aminewe898/nexus-pear-reva/engineering-tools/README.md

# Engineering tools

Historical generation, routing, correction, audit and packaging scripts are preserved for review. Some reference the original working folders and installed Windows tools. They are not a one-command reproducible build. Running generation scripts can overwrite circuit or routing changes; use the native checked project as the authoritative revision.
