aminewe898/nexus-pear-reva/docs/SOURCES.md

# Receipts, because "trust me bro" is not a datasheet

Research date: 2026-10-07. Official documentation is the basis of the redesign. Indexed supplier prices are explicitly weaker than current cart evidence. No supplier order or RFQ was sent.

| References | Manufacturer | Exact MPN | Official source |
|---|---|---|---|
| U1 | Espressif | ESP32-S3-WROOM-1U-N16R8 | [Source](https://www.espressif.com/sites/default/files/documentation/esp32-s3-wroom-1_wroom-1u_datasheet_en.pdf) |
| R1 R2 R20 R25 R29 R30 R42 R43 R44 R45 | Yageo | RC0805FR-0710KL | [Source](https://www.yageo.com/en/ProductSearch) |
| C1 C17 C21 | Murata | GRM21BR71A105KA01L | [Source](https://www.murata.com/en-global/products/capacitor/mlcc) |
| C2 C10 C11 C14 C15 C19 | Murata | GRM31CR61A226KE19L | [Source](https://www.murata.com/en-global/products/capacitor/mlcc) |
| C3 C6 C9 C16 C18 C20 C22 C23 C24 C25 | Murata | GRM21BR71H104KA01L | [Source](https://www.murata.com/en-global/products/capacitor/mlcc) |
| J1 | GCT | USB4105-GF-A | [Source](https://gct.co/files/drawings/usb4105.pdf) |
| R7 R8 | Yageo | RC0805FR-0722RL | [Source](https://www.yageo.com/en/ProductSearch) |
| U2 | STMicroelectronics | USBLC6-2SC6 | [Source](https://www.st.com/resource/en/datasheet/usblc6-2.pdf) |
| U3 | Nexperia | PESD5V0S2BT,215 | [Source](https://assets.nexperia.com/documents/data-sheet/PESD5V0S2BT.pdf) |
| F1 | Littelfuse | 1812L300/24SLER | [Source](https://www.littelfuse.com/assetdocs/low-rho-datasheet-update?assetguid=b786faf0-de16-4763-9d22-6b8080943caf) |
| U4 | Texas Instruments | TPS25940LRVCR | [Source](https://www.ti.com/lit/ds/symlink/tps25940.pdf) |
| C8 | Murata | GRM31CR61A106KA01L | [Source](https://www.murata.com/en-global/products/capacitor/mlcc) |
| U5 | Diodes Incorporated | AP63203WU-7 | [Source](https://www.diodes.com/assets/Datasheets/AP63200-AP63201-AP63203-AP63205.pdf) |
| L1 | Bourns | SRN6028C-3R9M | [Source](https://www.bourns.com/data/global/pdfs/SRN6028C.pdf) |
| R9 R37 R41 R48 R49 R50 | Yageo | RC0805FR-07100KL | [Source](https://www.yageo.com/en/ProductSearch) |
| J2 | JST | SM15B-GHS-TB(LF)(SN) | [Source](https://www.jst-mfg.com/product/pdf/eng/eGH.pdf) |
| R10 R11 R17 R18 R19 R27 R28 R46 R47 | Yageo | RC0805FR-0733RL | [Source](https://www.yageo.com/en/ProductSearch) |
| R13 R14 R24 | Yageo | RC0805FR-074K7L | [Source](https://www.yageo.com/en/ProductSearch) |
| J3 J4 | Samtec | TSW-007-07-G-S | [Source](https://www.samtec.com/products/tsw) |
| R15 | Yageo | RC0805FR-0782KL | [Source](https://www.yageo.com/en/ProductSearch) |
| R16 | Yageo | RC0805FR-07560KL | [Source](https://www.yageo.com/en/ProductSearch) |
| J5 J6 J7 | Samtec | TSW-006-07-G-S | [Source](https://www.samtec.com/products/tsw) |
| SW1 SW2 SW3 SW4 SW5 SW6 SW7 SW8 | Omron | B3F-1000 | [Source](https://components.omron.com/us-en/products/switches/B3F) |
| R21 | Yageo | RC0805JR-070RL | [Source](https://www.yageo.com/en/ProductSearch) |
| R22 R31 | Yageo | RC0805FR-071KL | [Source](https://www.yageo.com/en/ProductSearch) |
| R23 | Yageo | RC0805FR-072K2L | [Source](https://www.yageo.com/en/ProductSearch) |
| R26 | Yageo | RC0805FR-0722KL | [Source](https://www.yageo.com/en/ProductSearch) |
| J8 | Samtec | TSW-004-07-G-S | [Source](https://www.samtec.com/products/tsw) |
| D1 | Lite-On | LTST-C170KFKT | [Source](https://optoelectronics.liteon.com/en-global/Led/LED-Lamp) |
| U6 | Texas Instruments | TXU0104PWR | [Source](https://www.ti.com/lit/ds/symlink/txu0104.pdf) |
| U7 | Texas Instruments | TUSB320LAIRWBR | [Source](https://www.ti.com/lit/ds/symlink/tusb320lai.pdf) |
| U8 | Texas Instruments | TLV76033DBZR | [Source](https://www.ti.com/lit/ds/symlink/tlv760.pdf) |
| U9 | Texas Instruments | SN74LVC2G02DCTR | [Source](https://www.ti.com/lit/ds/symlink/sn74lvc2g02.pdf) |
| Q1 | Nexperia | 2N7002,215 | [Source](https://assets.nexperia.com/documents/data-sheet/2N7002.pdf) |
| D2 | Littelfuse | SMBJ10A | [Source](https://www.littelfuse.com/products/overvoltage-protection/tvs-diodes/surface-mount/smbj/smbj10a) |
| R32 R33 | Yageo | RC0805FR-0747KL | [Source](https://www.yageo.com/en/ProductSearch) |
| R34 | Yageo | RC0805FR-07887KL | [Source](https://www.yageo.com/en/ProductSearch) |
| R35 | Yageo | RC0805FR-0734K8L | [Source](https://www.yageo.com/en/ProductSearch) |
| R36 | Yageo | RC0805FR-07309KL | [Source](https://www.yageo.com/en/ProductSearch) |
| R38 | Yageo | RT0805BRD07475KL | [Source](https://www.yageo.com/en/ProductSearch) |
| R39 | Yageo | RT0805BRD07100KL | [Source](https://www.yageo.com/en/ProductSearch) |
| R40 | Yageo | RC0805FR-07332KL | [Source](https://www.yageo.com/en/ProductSearch) |
| C26 | Murata | GRM21BR71H473KA01L | [Source](https://www.murata.com/en-global/products/capacitor/mlcc) |

Display: [product](https://www.waveshare.com/product/3.5inch-capacitive-touch-lcd.htm), [wiki](https://www.waveshare.com/wiki/3.5inch_Capacitive_Touch_LCD), [public schematic](https://files.waveshare.com/wiki/3.5inch%20Capacitive%20Touch%20LCD/3.5inch_Capacitive_Touch_LCD_Schematic.pdf), [ST7796S](https://files.waveshare.com/wiki/common/ST7796S_Datasheet.pdf), [FT6336U](https://files.waveshare.com/wiki/common/FT6336U_Datasheet.pdf), [JST GH drawing](https://www.jst-mfg.com/product/pdf/eng/eGH.pdf).

Protection references: [TPS25940](https://www.ti.com/lit/ds/symlink/tps25940.pdf), [TUSB320LAI](https://www.ti.com/lit/ds/symlink/tusb320lai.pdf), [TLV760](https://www.ti.com/lit/ds/symlink/tlv760.pdf), [TXU0104](https://www.ti.com/lit/ds/symlink/txu0104.pdf), [Littelfuse Low Rho drawing/derating](https://www.littelfuse.com/assetdocs/low-rho-datasheet-update?assetguid=b786faf0-de16-4763-9d22-6b8080943caf).

Software: [KiCad 10 CLI](https://docs.kicad.org/10.0/en/cli/cli.html). KiCad 10.0.1 supplied native ERC/DRC and manufacturing exports. Local autorouting was followed by manual buck/USB/power corrections and native checks. Routing provenance is retained as engineering evidence.

BOM: 106 rows, 96 rows without prices. Observed USD subtotal 44.378 across ten rows is not a total procurement quote. Indexed prices, currency, import, VAT, shipping, PCB assembly, enclosure and storage-card cost are not a committed purchase price.
