aminewe898/nexus-pear-reva/previews/board-3d.png

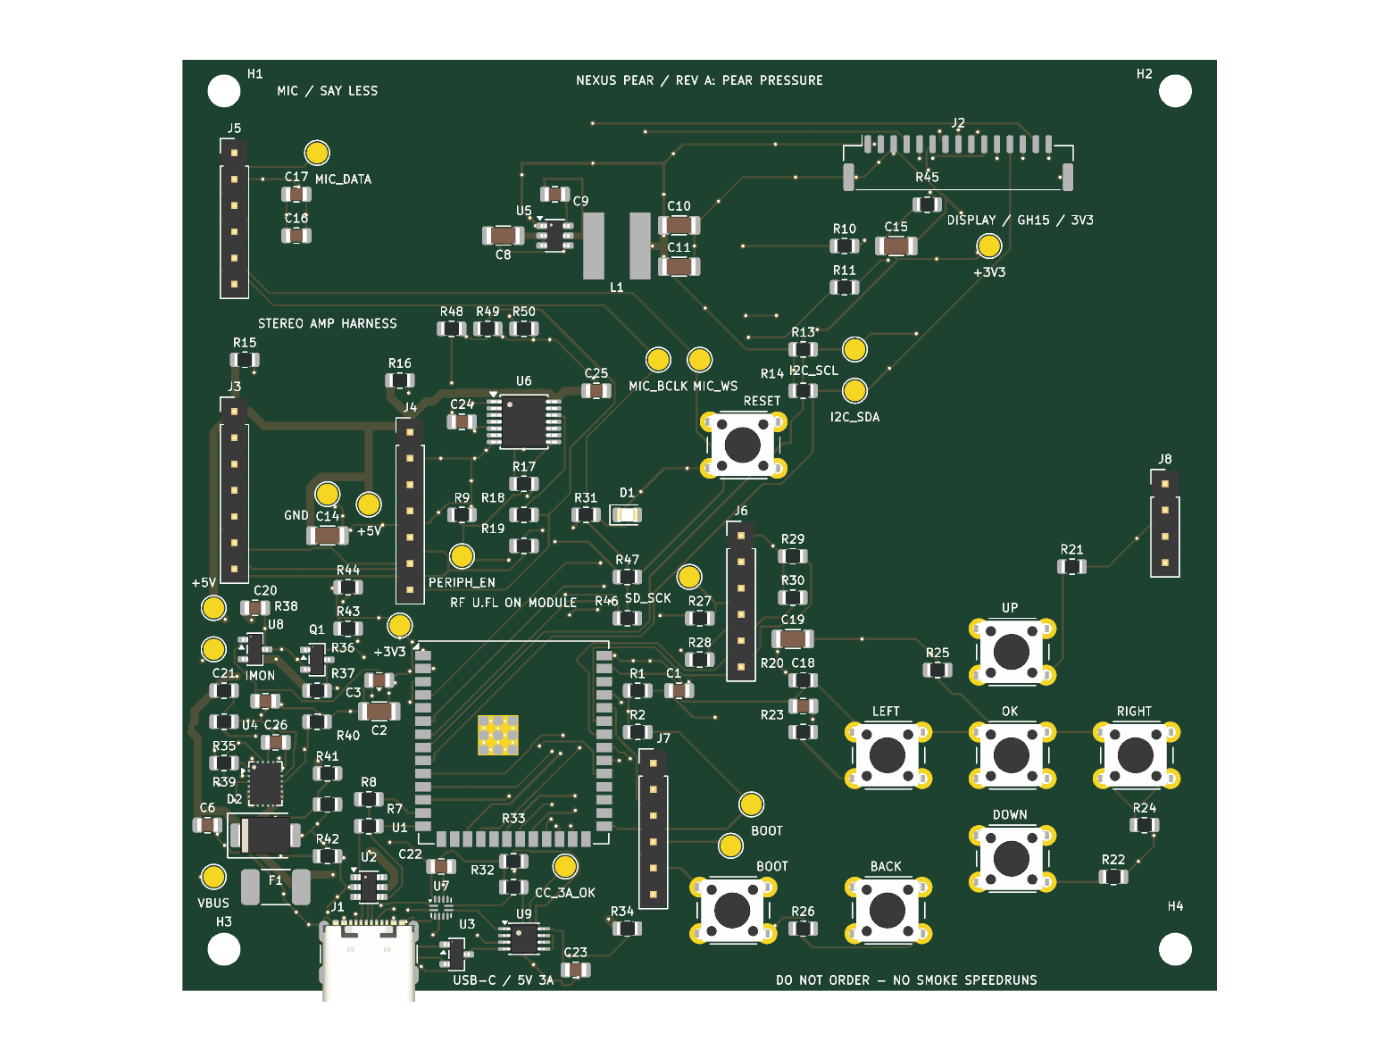
previews/board-3d.png
