aminewe898/nexus-pear-reva/hardware/manufacturing/DO_NOT_ORDER.md

# DO NOT ORDER - review exports only

Exports are regenerated from the reviewed 117-footprint native revision. Circuit defects were corrected; physical power/USB/audio qualification, manufacturer tolerance overlays, biased capacitance, complete live quotes, enclosure fit and fabricator impedance approval remain open. Read ../../docs/DESIGN_REVIEW_REVA.md.

Four layers: F.Cu signals, In1.Cu ground, In2.Cu 3.3V with isolated power/CC routes, B.Cu signals. Proposed 1.6mm board with outer 1oz/inner 0.5oz copper is not an approved impedance stackup. Placement CSV is in mm, KiCad absolute origin with negative Y; PTH/manual parts and rotations need assembly review. STEP omits five component bodies and does not qualify mechanics.

Gerbers.zip contains this revision's Gerbers. nexus-pear-reva.drl is the newly generated combined Excellon drill file; obsolete split drills and maps are removed. No panelization or assembly contract is approved. Any PCB edit requires refill, checks and regenerated exports.
