aminewe898/nexus-pear-reva/hardware/BOM_REVA.csv

Reference | Qty | Value | Description | Manufacturer | MPN | Package | Supplier | Supplier SKU | Unit Cost | Extended Cost | Availability | Datasheet URL | Notes | Currency
U1 | 1 | ESP32-S3-WROOM-1U-N16R8 | Manufacturer pin table checked; GPIO35/36/37 reserved for octal PSRAM. External RF socket. | Espressif | ESP32-S3-WROOM-1U-N16R8 | ESP32-S3-WROOM-1U | RFQ required |  |  |  | Exact live price and stock unconfirmed | https://www.espressif.com/sites/default/files/documentation/esp32-s3-wroom-1_wroom-1u_datasheet_en.pdf | CANDIDATE; DO NOT ORDER. Manufacturer pin table checked; GPIO35/36/37 reserved for octal PSRAM. External RF socket.
R1 | 1 | 10k | 1% 0805 thick-film; exact value and pin mapping explicit | Yageo | RC0805FR-0710KL | R_0805_2012Metric | RFQ required |  |  |  | Exact live price and stock unconfirmed | https://www.yageo.com/en/ProductSearch | CANDIDATE; DO NOT ORDER. 1% 0805 thick-film; exact value and pin mapping explicit
C1 | 1 | 1u | Ceramic; exact DC-bias and sourcing review pending; do not substitute voltage rating blindly | Murata | GRM21BR71A105KA01L | C_0805_2012Metric | RFQ required |  |  |  | Exact live price and stock unconfirmed | https://www.murata.com/en-global/products/capacitor/mlcc | CANDIDATE; DO NOT ORDER. Ceramic; exact DC-bias and sourcing review pending; do not substitute voltage rating blindly
C2 | 1 | 22u | Ceramic; exact DC-bias and sourcing review pending; do not substitute voltage rating blindly | Murata | GRM31CR61A226KE19L | C_1206_3216Metric | RFQ required |  |  |  | Exact live price and stock unconfirmed | https://www.murata.com/en-global/products/capacitor/mlcc | CANDIDATE; DO NOT ORDER. Ceramic; exact DC-bias and sourcing review pending; do not substitute voltage rating blindly
C3 | 1 | 100n | Ceramic; exact DC-bias and sourcing review pending; do not substitute voltage rating blindly | Murata | GRM21BR71H104KA01L | C_0805_2012Metric | RFQ required |  |  |  | Exact live price and stock unconfirmed | https://www.murata.com/en-global/products/capacitor/mlcc | CANDIDATE; DO NOT ORDER. Ceramic; exact DC-bias and sourcing review pending; do not substitute voltage rating blindly
R2 | 1 | 10k | 1% 0805 thick-film; exact value and pin mapping explicit | Yageo | RC0805FR-0710KL | R_0805_2012Metric | RFQ required |  |  |  | Exact live price and stock unconfirmed | https://www.yageo.com/en/ProductSearch | CANDIDATE; DO NOT ORDER. 1% 0805 thick-film; exact value and pin mapping explicit
J1 | 1 | USB-C 5V / USB2 FS | Fixed sink; no PD, no host; shield bonded to ground. Exact footprint requires final dimension audit. | GCT | USB4105-GF-A | USB_C_Receptacle_GCT_USB4105-xx-A_16P_TopMnt_Horizontal | RFQ required |  |  |  | Exact live price and stock unconfirmed | https://gct.co/files/drawings/usb4105.pdf | CANDIDATE; DO NOT ORDER. Fixed sink; no PD, no host; shield bonded to ground. Exact footprint requires final dimension audit.
R7 | 1 | 22 | 1% 0805 thick-film; exact value and pin mapping explicit | Yageo | RC0805FR-0722RL | R_0805_2012Metric | RFQ required |  |  |  | Exact live price and stock unconfirmed | https://www.yageo.com/en/ProductSearch | CANDIDATE; DO NOT ORDER. 1% 0805 thick-film; exact value and pin mapping explicit
R8 | 1 | 22 | 1% 0805 thick-film; exact value and pin mapping explicit | Yageo | RC0805FR-0722RL | R_0805_2012Metric | RFQ required |  |  |  | Exact live price and stock unconfirmed | https://www.yageo.com/en/ProductSearch | CANDIDATE; DO NOT ORDER. 1% 0805 thick-film; exact value and pin mapping explicit
U2 | 1 | USBLC6-2SC6 | USB data ESD; bias from protected main 5V, not raw VBUS | STMicroelectronics | USBLC6-2SC6 | SOT-23-6 | RFQ required |  |  |  | Exact live price and stock unconfirmed | https://www.st.com/resource/en/datasheet/usblc6-2.pdf | CANDIDATE; DO NOT ORDER. USB data ESD; bias from protected main 5V, not raw VBUS
U3 | 1 | PESD5V0S2BT CC ESD | Ground-referenced CC ESD; no rail injection. Not a 20V CC-to-VBUS short protector. | Nexperia | PESD5V0S2BT,215 | SOT-23 | RFQ required |  |  |  | Exact live price and stock unconfirmed | https://assets.nexperia.com/documents/data-sheet/PESD5V0S2BT.pdf | CANDIDATE; DO NOT ORDER. Ground-referenced CC ESD; no rail injection. Not a 20V CC-to-VBUS short protector.
F1 | 1 | 3A / 24V PTC | Manufacturer Low Rho table: 3A hold, 24V, R1max30mOhm; recommended pads 1.78x3.45mm, 3.15mm inner gap. Derates to 2.45A at40C and1.85A at60C. | Littelfuse | 1812L300/24SLER | Fuse_1812_4532Metric | DigiKey | 18-1812L300/24SLERCT-ND | 2.63 | 2.63 | Price/stock captured 2026-10-07 | https://www.littelfuse.com/assetdocs/low-rho-datasheet-update?assetguid=b786faf0-de16-4763-9d22-6b8080943caf | CANDIDATE; DO NOT ORDER. Manufacturer Low Rho table: 3A hold, 24V, R1max30mOhm; recommended pads 1.78x3.45mm, 3.15mm inner gap. Derates to 2.45A at40C and1.85A at60C. | USD
C6 | 1 | 100n | 50V X7R raw input decoupling; upstream capacitance below 1uF | Murata | GRM21BR71H104KA01L | C_0805_2012Metric | RFQ required |  |  |  | Exact live price and stock unconfirmed | https://www.murata.com/en-global/products/capacitor/mlcc | CANDIDATE; DO NOT ORDER. 50V X7R raw input decoupling; upstream capacitance below 1uF
U4 | 1 | TPS25940LRVCR eFuse | Latched eFuse: reverse blocking, UVLO, OVP, ~2.56A limit, controlled rise; only enabled on 3A advertisement | Texas Instruments | TPS25940LRVCR | Texas_RVC0020A_WQFN-20-1EP_3x4mm_P0.5mm_EP1.6x2.6mm | RFQ required |  |  |  | Exact live price and stock unconfirmed | https://www.ti.com/lit/ds/symlink/tps25940.pdf | CANDIDATE; DO NOT ORDER. Latched eFuse: reverse blocking, UVLO, OVP, ~2.56A limit, controlled rise; only enabled on 3A advertisement
C8 | 1 | 10u | Ceramic; exact DC-bias and sourcing review pending; do not substitute voltage rating blindly | Murata | GRM31CR61A106KA01L | C_1206_3216Metric | RFQ required |  |  |  | Exact live price and stock unconfirmed | https://www.murata.com/en-global/products/capacitor/mlcc | CANDIDATE; DO NOT ORDER. Ceramic; exact DC-bias and sourcing review pending; do not substitute voltage rating blindly
U5 | 1 | AP63203WU-7 3V3 buck | 2A fixed 3.3V. Sourcing contradictory; not release-qualified. | Diodes Incorporated | AP63203WU-7 | TSOT-23-6 | RFQ required |  |  |  | Exact live price and stock unconfirmed | https://www.diodes.com/assets/Datasheets/AP63200-AP63201-AP63203-AP63205.pdf | CANDIDATE; DO NOT ORDER. 2A fixed 3.3V. Sourcing contradictory; not release-qualified.
C9 | 1 | 100n | Ceramic; exact DC-bias and sourcing review pending; do not substitute voltage rating blindly | Murata | GRM21BR71H104KA01L | C_0805_2012Metric | RFQ required |  |  |  | Exact live price and stock unconfirmed | https://www.murata.com/en-global/products/capacitor/mlcc | CANDIDATE; DO NOT ORDER. Ceramic; exact DC-bias and sourcing review pending; do not substitute voltage rating blindly
L1 | 1 | 3.9uH | Bourns C-series recommended pads 2.0x6.5mm, center spacing 4.5mm; local native snapshot corrected against manufacturer drawing. | Bourns | SRN6028C-3R9M | L_Bourns-SRN6028 | RFQ required |  |  |  | Exact live price and stock unconfirmed | https://www.bourns.com/data/global/pdfs/SRN6028C.pdf | CANDIDATE; DO NOT ORDER. Bourns C-series recommended pads 2.0x6.5mm, center spacing 4.5mm; local native snapshot corrected against manufacturer drawing.
C10 | 1 | 22u | Ceramic; exact DC-bias and sourcing review pending; do not substitute voltage rating blindly | Murata | GRM31CR61A226KE19L | C_1206_3216Metric | RFQ required |  |  |  | Exact live price and stock unconfirmed | https://www.murata.com/en-global/products/capacitor/mlcc | CANDIDATE; DO NOT ORDER. Ceramic; exact DC-bias and sourcing review pending; do not substitute voltage rating blindly
C11 | 1 | 22u | Ceramic; exact DC-bias and sourcing review pending; do not substitute voltage rating blindly | Murata | GRM31CR61A226KE19L | C_1206_3216Metric | RFQ required |  |  |  | Exact live price and stock unconfirmed | https://www.murata.com/en-global/products/capacitor/mlcc | CANDIDATE; DO NOT ORDER. Ceramic; exact DC-bias and sourcing review pending; do not substitute voltage rating blindly
R9 | 1 | 100k | 1% 0805 thick-film; exact value and pin mapping explicit | Yageo | RC0805FR-07100KL | R_0805_2012Metric | RFQ required |  |  |  | Exact live price and stock unconfirmed | https://www.yageo.com/en/ProductSearch | CANDIDATE; DO NOT ORDER. 1% 0805 thick-film; exact value and pin mapping explicit
C14 | 1 | 22u | Ceramic; exact DC-bias and sourcing review pending; do not substitute voltage rating blindly | Murata | GRM31CR61A226KE19L | C_1206_3216Metric | RFQ required |  |  |  | Exact live price and stock unconfirmed | https://www.murata.com/en-global/products/capacitor/mlcc | CANDIDATE; DO NOT ORDER. Ceramic; exact DC-bias and sourcing review pending; do not substitute voltage rating blindly
C15 | 1 | 22u | Ceramic; exact DC-bias and sourcing review pending; do not substitute voltage rating blindly | Murata | GRM31CR61A226KE19L | C_1206_3216Metric | RFQ required |  |  |  | Exact live price and stock unconfirmed | https://www.murata.com/en-global/products/capacitor/mlcc | CANDIDATE; DO NOT ORDER. Ceramic; exact DC-bias and sourcing review pending; do not substitute voltage rating blindly
J2 | 1 | WAVESHARE 29318 GH15 | GH15 straight-through harness, 3.3V mode; mate GHR-15V-S and SSHL-002T-P0.2. No 5V on either supply pin. | JST | SM15B-GHS-TB(LF)(SN) | JST_GH_SM15B-GHS-TB_1x15-1MP_P1.25mm_Horizontal | Mouser | 306-SM15BGHSTBLFSN | 0.8 | 0.8 | Indexed price; live confirmation pending | https://www.jst-mfg.com/product/pdf/eng/eGH.pdf | CANDIDATE; DO NOT ORDER. GH15 straight-through harness, 3.3V mode; mate GHR-15V-S and SSHL-002T-P0.2. No 5V on either supply pin. | USD
R10 | 1 | 33 | 1% 0805 thick-film; exact value and pin mapping explicit | Yageo | RC0805FR-0733RL | R_0805_2012Metric | RFQ required |  |  |  | Exact live price and stock unconfirmed | https://www.yageo.com/en/ProductSearch | CANDIDATE; DO NOT ORDER. 1% 0805 thick-film; exact value and pin mapping explicit
R11 | 1 | 33 | 1% 0805 thick-film; exact value and pin mapping explicit | Yageo | RC0805FR-0733RL | R_0805_2012Metric | RFQ required |  |  |  | Exact live price and stock unconfirmed | https://www.yageo.com/en/ProductSearch | CANDIDATE; DO NOT ORDER. 1% 0805 thick-film; exact value and pin mapping explicit
R13 | 1 | 4.7k | 1% 0805 thick-film; exact value and pin mapping explicit | Yageo | RC0805FR-074K7L | R_0805_2012Metric | RFQ required |  |  |  | Exact live price and stock unconfirmed | https://www.yageo.com/en/ProductSearch | CANDIDATE; DO NOT ORDER. 1% 0805 thick-film; exact value and pin mapping explicit
R14 | 1 | 4.7k | 1% 0805 thick-film; exact value and pin mapping explicit | Yageo | RC0805FR-074K7L | R_0805_2012Metric | RFQ required |  |  |  | Exact live price and stock unconfirmed | https://www.yageo.com/en/ProductSearch | CANDIDATE; DO NOT ORDER. 1% 0805 thick-film; exact value and pin mapping explicit
J3 | 1 | LEFT AMP HARNESS | Carrier-side pin order only. Cable assembly and manufacturer drawing audit remain release gates. | Samtec | TSW-007-07-G-S | PinHeader_1x07_P2.54mm_Vertical | Samtec | TSW-107-07-G-S | 0.874 | 0.874 | Manufacturer indexed price; live confirmation pending | https://www.samtec.com/products/tsw | CANDIDATE; DO NOT ORDER. Carrier-side pin order only. Cable assembly and manufacturer drawing audit remain release gates. | USD
J4 | 1 | RIGHT AMP HARNESS | Carrier-side pin order only. Cable assembly and manufacturer drawing audit remain release gates. | Samtec | TSW-007-07-G-S | PinHeader_1x07_P2.54mm_Vertical | Samtec | TSW-107-07-G-S | 0.874 | 0.874 | Manufacturer indexed price; live confirmation pending | https://www.samtec.com/products/tsw | CANDIDATE; DO NOT ORDER. Carrier-side pin order only. Cable assembly and manufacturer drawing audit remain release gates. | USD
R15 | 1 | 82k | 1% 0805 thick-film; exact value and pin mapping explicit | Yageo | RC0805FR-0782KL | R_0805_2012Metric | RFQ required |  |  |  | Exact live price and stock unconfirmed | https://www.yageo.com/en/ProductSearch | CANDIDATE; DO NOT ORDER. 1% 0805 thick-film; exact value and pin mapping explicit
R16 | 1 | 560k | 1% 0805 thick-film; exact value and pin mapping explicit | Yageo | RC0805FR-07560KL | R_0805_2012Metric | RFQ required |  |  |  | Exact live price and stock unconfirmed | https://www.yageo.com/en/ProductSearch | CANDIDATE; DO NOT ORDER. 1% 0805 thick-film; exact value and pin mapping explicit
R17 | 1 | 33 | 1% 0805 thick-film; exact value and pin mapping explicit | Yageo | RC0805FR-0733RL | R_0805_2012Metric | RFQ required |  |  |  | Exact live price and stock unconfirmed | https://www.yageo.com/en/ProductSearch | CANDIDATE; DO NOT ORDER. 1% 0805 thick-film; exact value and pin mapping explicit
R18 | 1 | 33 | 1% 0805 thick-film; exact value and pin mapping explicit | Yageo | RC0805FR-0733RL | R_0805_2012Metric | RFQ required |  |  |  | Exact live price and stock unconfirmed | https://www.yageo.com/en/ProductSearch | CANDIDATE; DO NOT ORDER. 1% 0805 thick-film; exact value and pin mapping explicit
R19 | 1 | 33 | 1% 0805 thick-film; exact value and pin mapping explicit | Yageo | RC0805FR-0733RL | R_0805_2012Metric | RFQ required |  |  |  | Exact live price and stock unconfirmed | https://www.yageo.com/en/ProductSearch | CANDIDATE; DO NOT ORDER. 1% 0805 thick-film; exact value and pin mapping explicit
J5 | 1 | MIC HARNESS | Carrier-side pin order only. Cable assembly and manufacturer drawing audit remain release gates. | Samtec | TSW-006-07-G-S | PinHeader_1x06_P2.54mm_Vertical | RFQ required |  |  |  | Exact live price and stock unconfirmed | https://www.samtec.com/products/tsw | CANDIDATE; DO NOT ORDER. Carrier-side pin order only. Cable assembly and manufacturer drawing audit remain release gates.
C16 | 1 | 100n | Ceramic; exact DC-bias and sourcing review pending; do not substitute voltage rating blindly | Murata | GRM21BR71H104KA01L | C_0805_2012Metric | RFQ required |  |  |  | Exact live price and stock unconfirmed | https://www.murata.com/en-global/products/capacitor/mlcc | CANDIDATE; DO NOT ORDER. Ceramic; exact DC-bias and sourcing review pending; do not substitute voltage rating blindly
C17 | 1 | 1u | Ceramic; exact DC-bias and sourcing review pending; do not substitute voltage rating blindly | Murata | GRM21BR71A105KA01L | C_0805_2012Metric | RFQ required |  |  |  | Exact live price and stock unconfirmed | https://www.murata.com/en-global/products/capacitor/mlcc | CANDIDATE; DO NOT ORDER. Ceramic; exact DC-bias and sourcing review pending; do not substitute voltage rating blindly
R20 | 1 | 10k | 1% 0805 thick-film; exact value and pin mapping explicit | Yageo | RC0805FR-0710KL | R_0805_2012Metric | RFQ required |  |  |  | Exact live price and stock unconfirmed | https://www.yageo.com/en/ProductSearch | CANDIDATE; DO NOT ORDER. 1% 0805 thick-film; exact value and pin mapping explicit
C18 | 1 | 100n | Ceramic; exact DC-bias and sourcing review pending; do not substitute voltage rating blindly | Murata | GRM21BR71H104KA01L | C_0805_2012Metric | RFQ required |  |  |  | Exact live price and stock unconfirmed | https://www.murata.com/en-global/products/capacitor/mlcc | CANDIDATE; DO NOT ORDER. Ceramic; exact DC-bias and sourcing review pending; do not substitute voltage rating blindly
SW1 | 1 | UP | 6mm through-hole tact; verify actuator height and native pad fit | Omron | B3F-1000 | SW_PUSH_6mm | RFQ required |  |  |  | Exact live price and stock unconfirmed | https://components.omron.com/us-en/products/switches/B3F | CANDIDATE; DO NOT ORDER. 6mm through-hole tact; verify actuator height and native pad fit
R21 | 1 | 0 | Zero-ohm jumper; resistor tolerance code J, not F | Yageo | RC0805JR-070RL | R_0805_2012Metric | RFQ required |  |  |  | Exact live price and stock unconfirmed | https://www.yageo.com/en/ProductSearch | CANDIDATE; DO NOT ORDER. Zero-ohm jumper; resistor tolerance code J, not F
SW2 | 1 | DOWN | 6mm through-hole tact; verify actuator height and native pad fit | Omron | B3F-1000 | SW_PUSH_6mm | RFQ required |  |  |  | Exact live price and stock unconfirmed | https://components.omron.com/us-en/products/switches/B3F | CANDIDATE; DO NOT ORDER. 6mm through-hole tact; verify actuator height and native pad fit
R22 | 1 | 1k | 1% 0805 thick-film; exact value and pin mapping explicit | Yageo | RC0805FR-071KL | R_0805_2012Metric | RFQ required |  |  |  | Exact live price and stock unconfirmed | https://www.yageo.com/en/ProductSearch | CANDIDATE; DO NOT ORDER. 1% 0805 thick-film; exact value and pin mapping explicit
SW3 | 1 | LEFT | 6mm through-hole tact; verify actuator height and native pad fit | Omron | B3F-1000 | SW_PUSH_6mm | RFQ required |  |  |  | Exact live price and stock unconfirmed | https://components.omron.com/us-en/products/switches/B3F | CANDIDATE; DO NOT ORDER. 6mm through-hole tact; verify actuator height and native pad fit
R23 | 1 | 2.2k | 1% 0805 thick-film; exact value and pin mapping explicit | Yageo | RC0805FR-072K2L | R_0805_2012Metric | RFQ required |  |  |  | Exact live price and stock unconfirmed | https://www.yageo.com/en/ProductSearch | CANDIDATE; DO NOT ORDER. 1% 0805 thick-film; exact value and pin mapping explicit
SW4 | 1 | RIGHT | 6mm through-hole tact; verify actuator height and native pad fit | Omron | B3F-1000 | SW_PUSH_6mm | RFQ required |  |  |  | Exact live price and stock unconfirmed | https://components.omron.com/us-en/products/switches/B3F | CANDIDATE; DO NOT ORDER. 6mm through-hole tact; verify actuator height and native pad fit
R24 | 1 | 4.7k | 1% 0805 thick-film; exact value and pin mapping explicit | Yageo | RC0805FR-074K7L | R_0805_2012Metric | RFQ required |  |  |  | Exact live price and stock unconfirmed | https://www.yageo.com/en/ProductSearch | CANDIDATE; DO NOT ORDER. 1% 0805 thick-film; exact value and pin mapping explicit
SW5 | 1 | OK | 6mm through-hole tact; verify actuator height and native pad fit | Omron | B3F-1000 | SW_PUSH_6mm | RFQ required |  |  |  | Exact live price and stock unconfirmed | https://components.omron.com/us-en/products/switches/B3F | CANDIDATE; DO NOT ORDER. 6mm through-hole tact; verify actuator height and native pad fit
R25 | 1 | 10k | 1% 0805 thick-film; exact value and pin mapping explicit | Yageo | RC0805FR-0710KL | R_0805_2012Metric | RFQ required |  |  |  | Exact live price and stock unconfirmed | https://www.yageo.com/en/ProductSearch | CANDIDATE; DO NOT ORDER. 1% 0805 thick-film; exact value and pin mapping explicit
SW6 | 1 | BACK | 6mm through-hole tact; verify actuator height and native pad fit | Omron | B3F-1000 | SW_PUSH_6mm | RFQ required |  |  |  | Exact live price and stock unconfirmed | https://components.omron.com/us-en/products/switches/B3F | CANDIDATE; DO NOT ORDER. 6mm through-hole tact; verify actuator height and native pad fit
R26 | 1 | 22k | 1% 0805 thick-film; exact value and pin mapping explicit | Yageo | RC0805FR-0722KL | R_0805_2012Metric | RFQ required |  |  |  | Exact live price and stock unconfirmed | https://www.yageo.com/en/ProductSearch | CANDIDATE; DO NOT ORDER. 1% 0805 thick-film; exact value and pin mapping explicit
J6 | 1 | 3V3 SD HARNESS | Carrier-side pin order only. Cable assembly and manufacturer drawing audit remain release gates. | Samtec | TSW-006-07-G-S | PinHeader_1x06_P2.54mm_Vertical | RFQ required |  |  |  | Exact live price and stock unconfirmed | https://www.samtec.com/products/tsw | CANDIDATE; DO NOT ORDER. Carrier-side pin order only. Cable assembly and manufacturer drawing audit remain release gates.
R27 | 1 | 33 | 1% 0805 thick-film; exact value and pin mapping explicit | Yageo | RC0805FR-0733RL | R_0805_2012Metric | RFQ required |  |  |  | Exact live price and stock unconfirmed | https://www.yageo.com/en/ProductSearch | CANDIDATE; DO NOT ORDER. 1% 0805 thick-film; exact value and pin mapping explicit
R28 | 1 | 33 | 1% 0805 thick-film; exact value and pin mapping explicit | Yageo | RC0805FR-0733RL | R_0805_2012Metric | RFQ required |  |  |  | Exact live price and stock unconfirmed | https://www.yageo.com/en/ProductSearch | CANDIDATE; DO NOT ORDER. 1% 0805 thick-film; exact value and pin mapping explicit
R29 | 1 | 10k | 1% 0805 thick-film; exact value and pin mapping explicit | Yageo | RC0805FR-0710KL | R_0805_2012Metric | RFQ required |  |  |  | Exact live price and stock unconfirmed | https://www.yageo.com/en/ProductSearch | CANDIDATE; DO NOT ORDER. 1% 0805 thick-film; exact value and pin mapping explicit
R30 | 1 | 10k | 1% 0805 thick-film; exact value and pin mapping explicit | Yageo | RC0805FR-0710KL | R_0805_2012Metric | RFQ required |  |  |  | Exact live price and stock unconfirmed | https://www.yageo.com/en/ProductSearch | CANDIDATE; DO NOT ORDER. 1% 0805 thick-film; exact value and pin mapping explicit
C19 | 1 | 22u | Ceramic; exact DC-bias and sourcing review pending; do not substitute voltage rating blindly | Murata | GRM31CR61A226KE19L | C_1206_3216Metric | RFQ required |  |  |  | Exact live price and stock unconfirmed | https://www.murata.com/en-global/products/capacitor/mlcc | CANDIDATE; DO NOT ORDER. Ceramic; exact DC-bias and sourcing review pending; do not substitute voltage rating blindly
J7 | 1 | UART RECOVERY | Carrier-side pin order only. Cable assembly and manufacturer drawing audit remain release gates. | Samtec | TSW-006-07-G-S | PinHeader_1x06_P2.54mm_Vertical | RFQ required |  |  |  | Exact live price and stock unconfirmed | https://www.samtec.com/products/tsw | CANDIDATE; DO NOT ORDER. Carrier-side pin order only. Cable assembly and manufacturer drawing audit remain release gates.
J8 | 1 | I2C EXPANSION | Carrier-side pin order only. Cable assembly and manufacturer drawing audit remain release gates. | Samtec | TSW-004-07-G-S | PinHeader_1x04_P2.54mm_Vertical | RFQ required |  |  |  | Exact live price and stock unconfirmed | https://www.samtec.com/products/tsw | CANDIDATE; DO NOT ORDER. Carrier-side pin order only. Cable assembly and manufacturer drawing audit remain release gates.
SW7 | 1 | BOOT |  | Omron | B3F-1000 | SW_PUSH_6mm | RFQ required |  |  |  | Exact live price and stock unconfirmed | https://components.omron.com/us-en/products/switches/B3F | CANDIDATE; DO NOT ORDER.
SW8 | 1 | RESET |  | Omron | B3F-1000 | SW_PUSH_6mm | RFQ required |  |  |  | Exact live price and stock unconfirmed | https://components.omron.com/us-en/products/switches/B3F | CANDIDATE; DO NOT ORDER.
R31 | 1 | 1k | 1% 0805 thick-film; exact value and pin mapping explicit | Yageo | RC0805FR-071KL | R_0805_2012Metric | RFQ required |  |  |  | Exact live price and stock unconfirmed | https://www.yageo.com/en/ProductSearch | CANDIDATE; DO NOT ORDER. 1% 0805 thick-film; exact value and pin mapping explicit
D1 | 1 | STATUS amber | Sourcing and polarity audit pending | Lite-On | LTST-C170KFKT | LED_0805_2012Metric | RFQ required |  |  |  | Exact live price and stock unconfirmed | https://optoelectronics.liteon.com/en-global/Led/LED-Lamp | CANDIDATE; DO NOT ORDER. Sourcing and polarity audit pending
U6 | 1 | TXU0104PWR fail-safe I2S | Automatic supply isolation and Ioff; default disabled by R9. Same-rail display/mic/SD eliminate independent power-off injection. | Texas Instruments | TXU0104PWR | TSSOP-14_4.4x5mm_P0.65mm | Mouser | 595-TXU0104PWR | 1.03 | 1.03 | Indexed price; live confirmation pending | https://www.ti.com/lit/ds/symlink/txu0104.pdf | CANDIDATE; DO NOT ORDER. Automatic supply isolation and Ioff; default disabled by R9. Same-rail display/mic/SD eliminate independent power-off injection. | USD
U7 | 1 | TUSB320LAIRWBR Type-C sink | GPIO mode ADDR floating; sink PORT grounded; internal Rd. OUT1/2 low only for 3A advertisement. | Texas Instruments | TUSB320LAIRWBR | Texas_X2QFN-12_1.6x1.6mm_P0.4mm | RFQ required |  |  |  | Exact live price and stock unconfirmed | https://www.ti.com/lit/ds/symlink/tusb320lai.pdf | CANDIDATE; DO NOT ORDER. GPIO mode ADDR floating; sink PORT grounded; internal Rd. OUT1/2 low only for 3A advertisement.
U8 | 1 | TLV76033DBZR always-on | 30V input rating; pin order follows corrected Rev A datasheet. Powers only CC detector and logic. | Texas Instruments | TLV76033DBZR | SOT-23 | Mouser | 595-TLV76033DBZR | 0.23 | 0.23 | Indexed price; live confirmation pending | https://www.ti.com/lit/ds/symlink/tlv760.pdf | CANDIDATE; DO NOT ORDER. 30V input rating; pin order follows corrected Rev A datasheet. Powers only CC detector and logic. | USD
U9 | 1 | SN74LVC2G02DCTR dual NOR | 3A truth table hardware interlock; no MCU sampling thresholds | Texas Instruments | SN74LVC2G02DCTR | SSOP-8_2.95x2.8mm_P0.65mm | RFQ required |  |  |  | Exact live price and stock unconfirmed | https://www.ti.com/lit/ds/symlink/sn74lvc2g02.pdf | CANDIDATE; DO NOT ORDER. 3A truth table hardware interlock; no MCU sampling thresholds
Q1 | 1 | 2N7002 eFuse inhibit | Pulls eFuse enable below UVLO when unattached/default/1.5A | Nexperia | 2N7002,215 | SOT-23 | RFQ required |  |  |  | Exact live price and stock unconfirmed | https://assets.nexperia.com/documents/data-sheet/2N7002.pdf | CANDIDATE; DO NOT ORDER. Pulls eFuse enable below UVLO when unattached/default/1.5A
D2 | 1 | SMBJ10A VBUS TVS | 17V rated pulse clamp below eFuse 20V absolute maximum; transient energy qualification pending | Littelfuse | SMBJ10A | D_SMB | RFQ required |  |  |  | Exact live price and stock unconfirmed | https://www.littelfuse.com/products/overvoltage-protection/tvs-diodes/surface-mount/smbj/smbj10a | CANDIDATE; DO NOT ORDER. 17V rated pulse clamp below eFuse 20V absolute maximum; transient energy qualification pending
R32 | 1 | 47k | 1% 0805 thick-film; exact value and pin mapping explicit | Yageo | RC0805FR-0747KL | R_0805_2012Metric | RFQ required |  |  |  | Exact live price and stock unconfirmed | https://www.yageo.com/en/ProductSearch | CANDIDATE; DO NOT ORDER. 1% 0805 thick-film; exact value and pin mapping explicit
R33 | 1 | 47k | 1% 0805 thick-film; exact value and pin mapping explicit | Yageo | RC0805FR-0747KL | R_0805_2012Metric | RFQ required |  |  |  | Exact live price and stock unconfirmed | https://www.yageo.com/en/ProductSearch | CANDIDATE; DO NOT ORDER. 1% 0805 thick-film; exact value and pin mapping explicit
R34 | 1 | 887k | 1% 0805 thick-film; exact value and pin mapping explicit | Yageo | RC0805FR-07887KL | R_0805_2012Metric | RFQ required |  |  |  | Exact live price and stock unconfirmed | https://www.yageo.com/en/ProductSearch | CANDIDATE; DO NOT ORDER. 1% 0805 thick-film; exact value and pin mapping explicit
R35 | 1 | 34.8k | 1% 0805 thick-film; exact value and pin mapping explicit | Yageo | RC0805FR-0734K8L | R_0805_2012Metric | Mouser | 603-RC0805FR-0734K8L | 0.1 | 0.1 | Indexed price; live confirmation pending | https://www.yageo.com/en/ProductSearch | CANDIDATE; DO NOT ORDER. 1% 0805 thick-film; exact value and pin mapping explicit | USD
R36 | 1 | 309k | 1% 0805 thick-film; exact value and pin mapping explicit | Yageo | RC0805FR-07309KL | R_0805_2012Metric | RFQ required |  |  |  | Exact live price and stock unconfirmed | https://www.yageo.com/en/ProductSearch | CANDIDATE; DO NOT ORDER. 1% 0805 thick-film; exact value and pin mapping explicit
R37 | 1 | 100k | 1% 0805 thick-film; exact value and pin mapping explicit | Yageo | RC0805FR-07100KL | R_0805_2012Metric | RFQ required |  |  |  | Exact live price and stock unconfirmed | https://www.yageo.com/en/ProductSearch | CANDIDATE; DO NOT ORDER. 1% 0805 thick-film; exact value and pin mapping explicit
R38 | 1 | 475k | 0.1% OVP threshold divider | Yageo | RT0805BRD07475KL | R_0805_2012Metric | RFQ required |  |  |  | Exact live price and stock unconfirmed | https://www.yageo.com/en/ProductSearch | CANDIDATE; DO NOT ORDER. 0.1% OVP threshold divider
R39 | 1 | 100k | 0.1% OVP threshold divider | Yageo | RT0805BRD07100KL | R_0805_2012Metric | RFQ required |  |  |  | Exact live price and stock unconfirmed | https://www.yageo.com/en/ProductSearch | CANDIDATE; DO NOT ORDER. 0.1% OVP threshold divider
R40 | 1 | 332k | 1% 0805 thick-film; exact value and pin mapping explicit | Yageo | RC0805FR-07332KL | R_0805_2012Metric | RFQ required |  |  |  | Exact live price and stock unconfirmed | https://www.yageo.com/en/ProductSearch | CANDIDATE; DO NOT ORDER. 1% 0805 thick-film; exact value and pin mapping explicit
R41 | 1 | 100k | 1% 0805 thick-film; exact value and pin mapping explicit | Yageo | RC0805FR-07100KL | R_0805_2012Metric | RFQ required |  |  |  | Exact live price and stock unconfirmed | https://www.yageo.com/en/ProductSearch | CANDIDATE; DO NOT ORDER. 1% 0805 thick-film; exact value and pin mapping explicit
R42 | 1 | 10k | 1% 0805 thick-film; exact value and pin mapping explicit | Yageo | RC0805FR-0710KL | R_0805_2012Metric | RFQ required |  |  |  | Exact live price and stock unconfirmed | https://www.yageo.com/en/ProductSearch | CANDIDATE; DO NOT ORDER. 1% 0805 thick-film; exact value and pin mapping explicit
R43 | 1 | 10k | 1% 0805 thick-film; exact value and pin mapping explicit | Yageo | RC0805FR-0710KL | R_0805_2012Metric | RFQ required |  |  |  | Exact live price and stock unconfirmed | https://www.yageo.com/en/ProductSearch | CANDIDATE; DO NOT ORDER. 1% 0805 thick-film; exact value and pin mapping explicit
R44 | 1 | 10k | 1% 0805 thick-film; exact value and pin mapping explicit | Yageo | RC0805FR-0710KL | R_0805_2012Metric | RFQ required |  |  |  | Exact live price and stock unconfirmed | https://www.yageo.com/en/ProductSearch | CANDIDATE; DO NOT ORDER. 1% 0805 thick-film; exact value and pin mapping explicit
R45 | 1 | 10k | 1% 0805 thick-film; exact value and pin mapping explicit | Yageo | RC0805FR-0710KL | R_0805_2012Metric | RFQ required |  |  |  | Exact live price and stock unconfirmed | https://www.yageo.com/en/ProductSearch | CANDIDATE; DO NOT ORDER. 1% 0805 thick-film; exact value and pin mapping explicit
R46 | 1 | 33 | 1% 0805 thick-film; exact value and pin mapping explicit | Yageo | RC0805FR-0733RL | R_0805_2012Metric | RFQ required |  |  |  | Exact live price and stock unconfirmed | https://www.yageo.com/en/ProductSearch | CANDIDATE; DO NOT ORDER. 1% 0805 thick-film; exact value and pin mapping explicit
R47 | 1 | 33 | 1% 0805 thick-film; exact value and pin mapping explicit | Yageo | RC0805FR-0733RL | R_0805_2012Metric | RFQ required |  |  |  | Exact live price and stock unconfirmed | https://www.yageo.com/en/ProductSearch | CANDIDATE; DO NOT ORDER. 1% 0805 thick-film; exact value and pin mapping explicit
R48 | 1 | 100k | 1% 0805 thick-film; exact value and pin mapping explicit | Yageo | RC0805FR-07100KL | R_0805_2012Metric | RFQ required |  |  |  | Exact live price and stock unconfirmed | https://www.yageo.com/en/ProductSearch | CANDIDATE; DO NOT ORDER. 1% 0805 thick-film; exact value and pin mapping explicit
R49 | 1 | 100k | 1% 0805 thick-film; exact value and pin mapping explicit | Yageo | RC0805FR-07100KL | R_0805_2012Metric | RFQ required |  |  |  | Exact live price and stock unconfirmed | https://www.yageo.com/en/ProductSearch | CANDIDATE; DO NOT ORDER. 1% 0805 thick-film; exact value and pin mapping explicit
R50 | 1 | 100k | 1% 0805 thick-film; exact value and pin mapping explicit | Yageo | RC0805FR-07100KL | R_0805_2012Metric | RFQ required |  |  |  | Exact live price and stock unconfirmed | https://www.yageo.com/en/ProductSearch | CANDIDATE; DO NOT ORDER. 1% 0805 thick-film; exact value and pin mapping explicit
C20 | 1 | 100n | Ceramic; exact DC-bias and sourcing review pending; do not substitute voltage rating blindly | Murata | GRM21BR71H104KA01L | C_0805_2012Metric | RFQ required |  |  |  | Exact live price and stock unconfirmed | https://www.murata.com/en-global/products/capacitor/mlcc | CANDIDATE; DO NOT ORDER. Ceramic; exact DC-bias and sourcing review pending; do not substitute voltage rating blindly
C21 | 1 | 1u | Ceramic; exact DC-bias and sourcing review pending; do not substitute voltage rating blindly | Murata | GRM21BR71A105KA01L | C_0805_2012Metric | RFQ required |  |  |  | Exact live price and stock unconfirmed | https://www.murata.com/en-global/products/capacitor/mlcc | CANDIDATE; DO NOT ORDER. Ceramic; exact DC-bias and sourcing review pending; do not substitute voltage rating blindly
C22 | 1 | 100n | Ceramic; exact DC-bias and sourcing review pending; do not substitute voltage rating blindly | Murata | GRM21BR71H104KA01L | C_0805_2012Metric | RFQ required |  |  |  | Exact live price and stock unconfirmed | https://www.murata.com/en-global/products/capacitor/mlcc | CANDIDATE; DO NOT ORDER. Ceramic; exact DC-bias and sourcing review pending; do not substitute voltage rating blindly
C23 | 1 | 100n | Ceramic; exact DC-bias and sourcing review pending; do not substitute voltage rating blindly | Murata | GRM21BR71H104KA01L | C_0805_2012Metric | RFQ required |  |  |  | Exact live price and stock unconfirmed | https://www.murata.com/en-global/products/capacitor/mlcc | CANDIDATE; DO NOT ORDER. Ceramic; exact DC-bias and sourcing review pending; do not substitute voltage rating blindly
C24 | 1 | 100n | Ceramic; exact DC-bias and sourcing review pending; do not substitute voltage rating blindly | Murata | GRM21BR71H104KA01L | C_0805_2012Metric | RFQ required |  |  |  | Exact live price and stock unconfirmed | https://www.murata.com/en-global/products/capacitor/mlcc | CANDIDATE; DO NOT ORDER. Ceramic; exact DC-bias and sourcing review pending; do not substitute voltage rating blindly
C25 | 1 | 100n | Ceramic; exact DC-bias and sourcing review pending; do not substitute voltage rating blindly | Murata | GRM21BR71H104KA01L | C_0805_2012Metric | RFQ required |  |  |  | Exact live price and stock unconfirmed | https://www.murata.com/en-global/products/capacitor/mlcc | CANDIDATE; DO NOT ORDER. Ceramic; exact DC-bias and sourcing review pending; do not substitute voltage rating blindly
C26 | 1 | 47n | 50V X7R; nominal ~19.5ms eFuse ramp | Murata | GRM21BR71H473KA01L | C_0805_2012Metric | RFQ required |  |  |  | Exact live price and stock unconfirmed | https://www.murata.com/en-global/products/capacitor/mlcc | CANDIDATE; DO NOT ORDER. 50V X7R; nominal ~19.5ms eFuse ramp
EXT_DISPLAY | 1 | 3.5 inch IPS / capacitive | ST7796S + FT6336U; native 320x480; landscape 480x320 | Waveshare | 29318 | Off-board module | Waveshare | 29318 | 18.99 | 18.99 | Official product price captured 2026-10-07 | https://www.waveshare.com/product/3.5inch-capacitive-touch-lcd.htm | 3.3V mode; GHR-15V-S housing and SSHL-002T-P0.2 contacts; 12MHz write limit | USD
EXT_AMP_L EXT_AMP_R | 2 | MAX98357A breakout | Two mono I2S DAC/class-D channels | Adafruit | 3006 | Off-board breakout | Adafruit | 3006 | 5.95 | 11.9 | Add to Cart shown 2026-10-07 | https://www.adafruit.com/product/3006 | Harness to J3/J4; speaker terminals are on amplifier breakouts | USD
EXT_MIC | 1 | SPH0645LM4H breakout | Digital I2S MEMS microphone | Adafruit | 3421 | Off-board breakout | Adafruit | 3421 | 6.95 | 6.95 | Add to Cart shown 2026-10-07 | https://www.adafruit.com/product/3421 | J5 harness; bottom acoustic port; exact microphone datasheet audit incomplete | USD
EXT_SD | 1 | 3V microSD SPI breakout | Optional storage module | Adafruit | 4682 | Off-board breakout | Adafruit | 4682 |  |  | Product page found; stock/price not captured | https://www.adafruit.com/product/4682 | J6 harness to 3V/GND/CLK/CMD/DAT0/DAT3; no 5V level shifter
EXT_SPK_L EXT_SPK_R | 2 | 8 ohm / 2W | 28 x 40 mm miniature full-range loudspeakers | Visaton | 2945 | Off-board driver | Mouser / TME | VS-K28.40-8 |  |  | Mouser indexed listing 898; TME indexed listing 200; live confirmation pending | https://www.visaton.de/en/products/drivers/miniature-speakers/k-2840-8-ohm | Rated 2W, maximum 3W; bridge outputs must never connect to GND
EXT_ANT | 1 | 2.4GHz external antenna | Real hinged RP-SMA antenna, 50 ohm | Taoglas | GW.11.A153 | Off-board antenna | Mouser | 960-GW11A153 |  |  | Indexed Mouser listing 1963; price/live stock unconfirmed | https://www.taoglas.com/datasheets/GW.11.A153.pdf | Use current rev H gain, up to 3dBi; module antenna certification limits not yet qualified
EXT_RF_CABLE | 1 | 100mm U.FL to RP-SMA(F) | Bulkhead coax assembly | Taoglas | CAB.774 | Off-board cable | Not qualified |  |  |  | Datasheet found; supplier stock/price unverified | https://www.taoglas.com/datasheets/CAB.774.pdf | Confirm gender and length against mechanical drawing; not CAB.011 ambiguous revision
EXT_DISPLAY_HOUSING | 1 | 15 pin GH housing | Display cable carrier mate | JST | GHR-15V-S | Cable housing | RFQ required |  |  |  | No quote | https://www.jst-mfg.com/product/pdf/eng/eGH.pdf | Use only manufacturer-compatible contacts
EXT_DISPLAY_CONTACTS | 15 | GH crimp contacts | 26-30AWG contacts | JST | SSHL-002T-P0.2 | Crimp terminal | RFQ required |  |  |  | No quote | https://www.jst-mfg.com/product/pdf/eng/eGH.pdf | 0.76-1.0mm insulation; correct tooling required
EXT_HARNESS | 1 | Display/audio/mic/SD harness set | Custom point-to-point assemblies | Custom assembly | NEXUS-PEAR-HARNESS-A-CANDIDATE | Wiring | RFQ required |  |  |  | No quote | ../docs/PIN_ASSIGNMENTS.md | Pin mappings released as design intent; custom assembly, wire lengths and supplier assembly drawing require quote and approval
