aminewe898/nexus-pear-reva/hardware/manufacturing/nexus-pear-reva.step

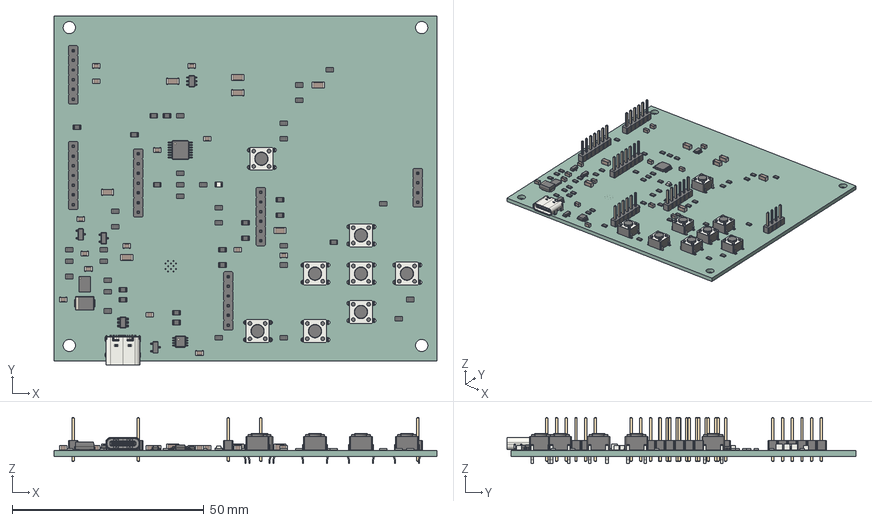
[picture p2: CAD file, 2026-10-09]
hardware/manufacturing/nexus-pear-reva.step
100.0 x 91.1 x 12.0 mm
C_0805_2012Metric x 14
C_1206_3216Metric x 7
R_0805_2012Metric x 45
TSOT-23-6
PinHeader_1x06_P2.54mm_Vertical x 3
LED_0805_2012Metric
PinHeader_1x07_P2.54mm_Vertical x 2
SOT-23 x 3
SOT-23-6
D_SMB
SW_PUSH_6mm x 8
TSSOP-14_4.4x5mm_P0.65mm
SSOP-8_2.95x2.8mm_P0.65mm
USB_C_Receptacle_GCT_USB4105-xx-A_16P_TopMnt_Horizontal
PinHeader_1x04_P2.54mm_Vertical
Texas_RVC0020A_WQFN-20-1EP_3x4mm_P0.5mm_EP1.6x2.6mm
nexus-pear-reva_PCB
