aminewe898/nexus-pear-reva/previews/schematic.pdf

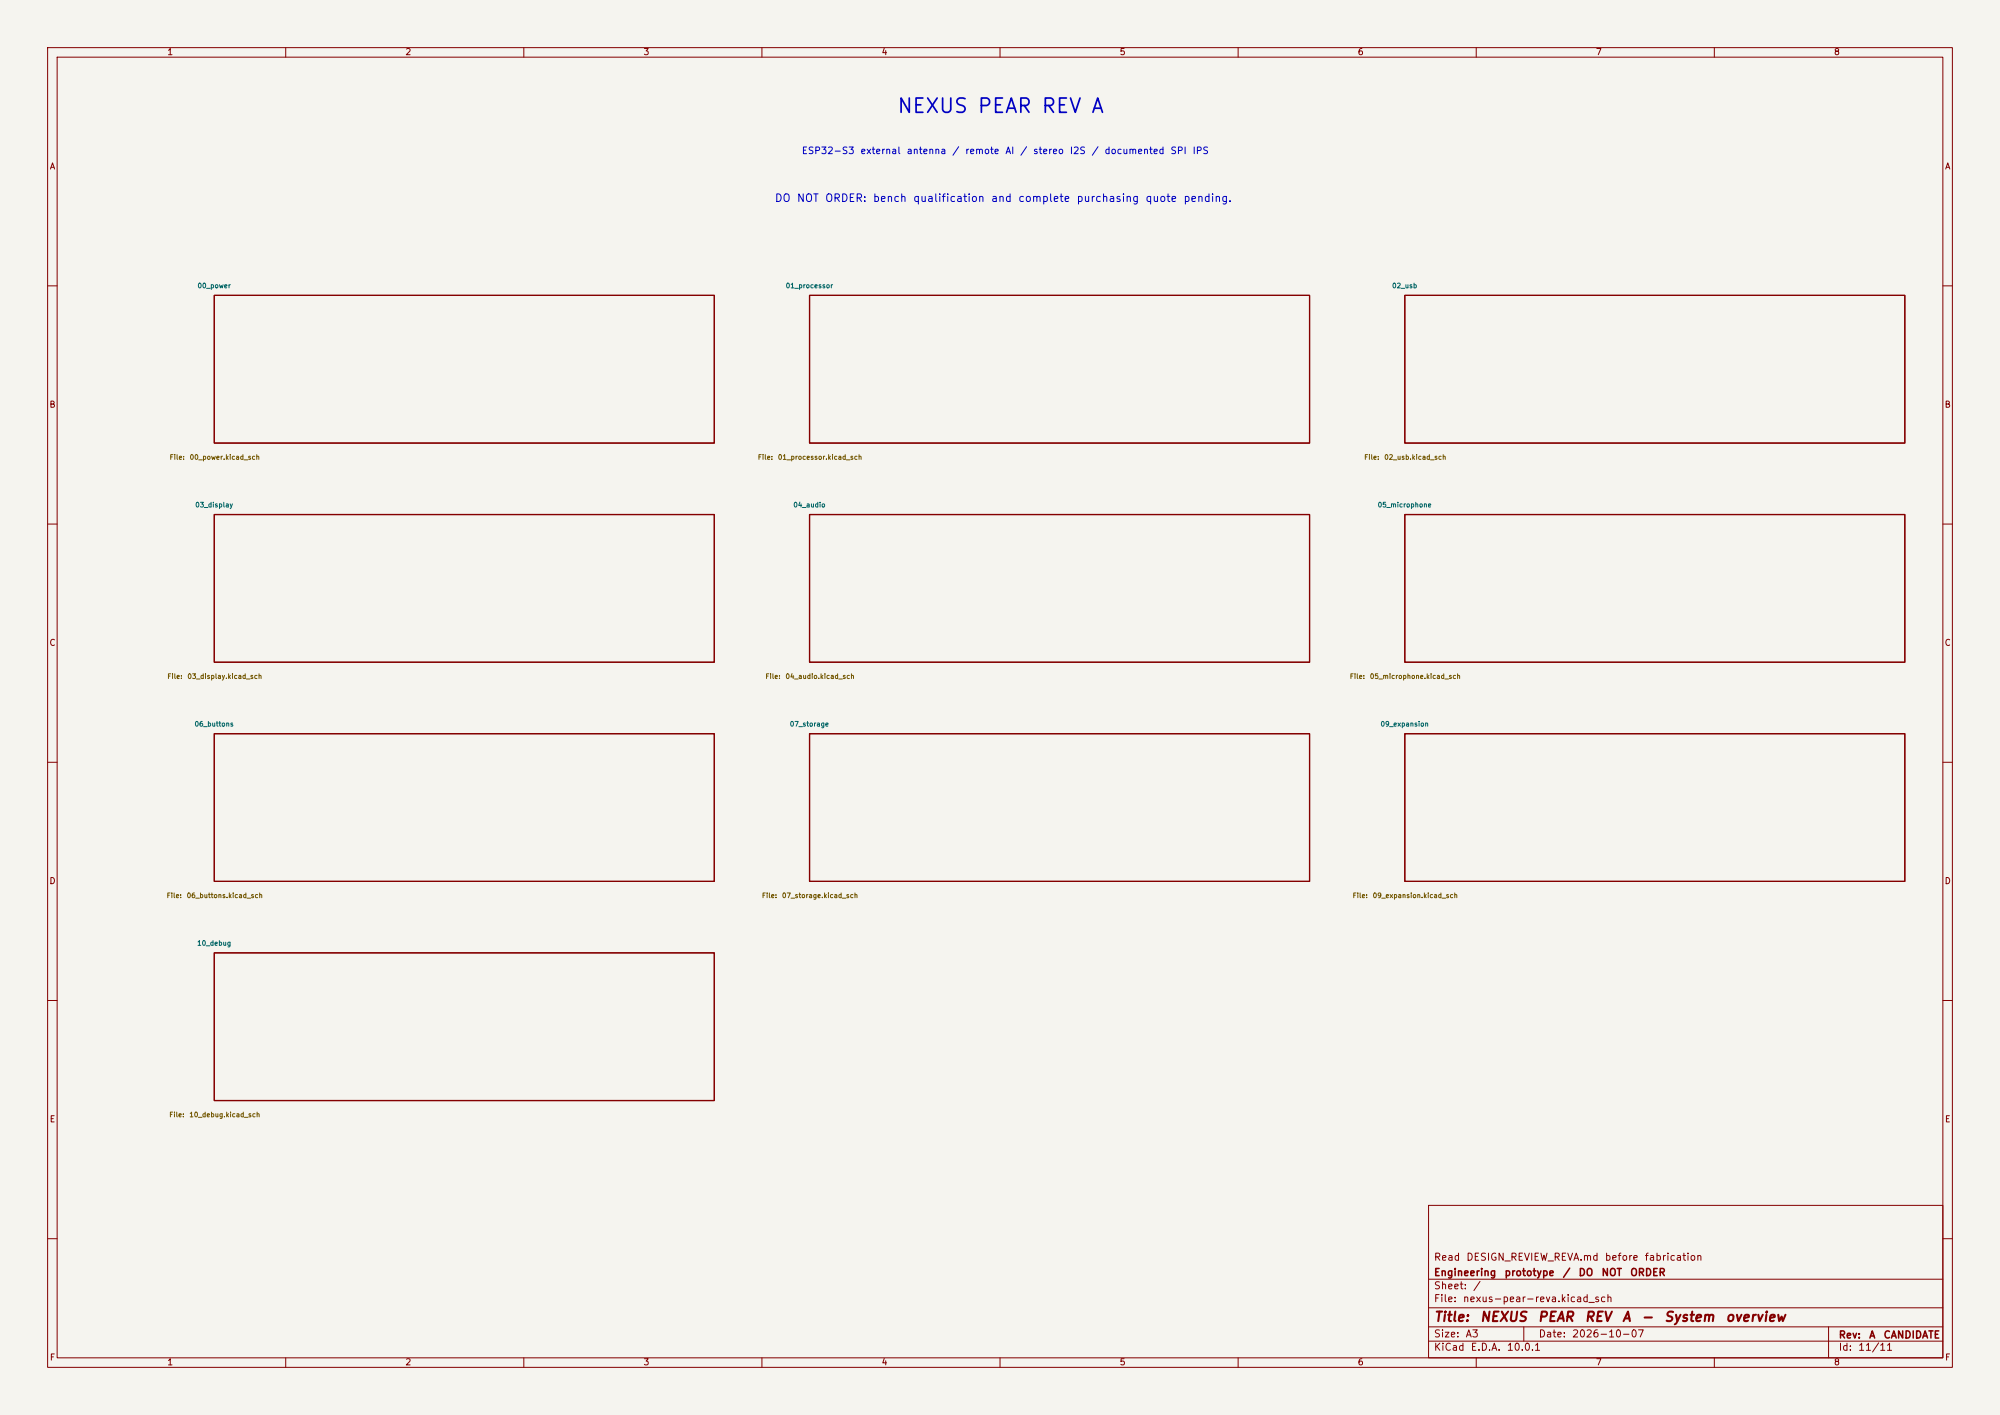
[picture p3: page 1]

ESP32-S3 external antenna / remote AI / stereo I2S / documented SPI IPS DO NOT ORDER: bench qualification and complete purchasing quote pending.

Read DESIGN_REVIEW_REVA.md before fabrication
Engineering prototype / DO NOT ORDER
Sheet: /
File: nexus-pear-reva.kicad_sch
Title: NEXUS PEAR REV A - System overview

Size: A3 | Rev: A CANDIDATE | F Date: 2026-10-07
KiCad E.D.A. 10.0.1 | Id: 11/11

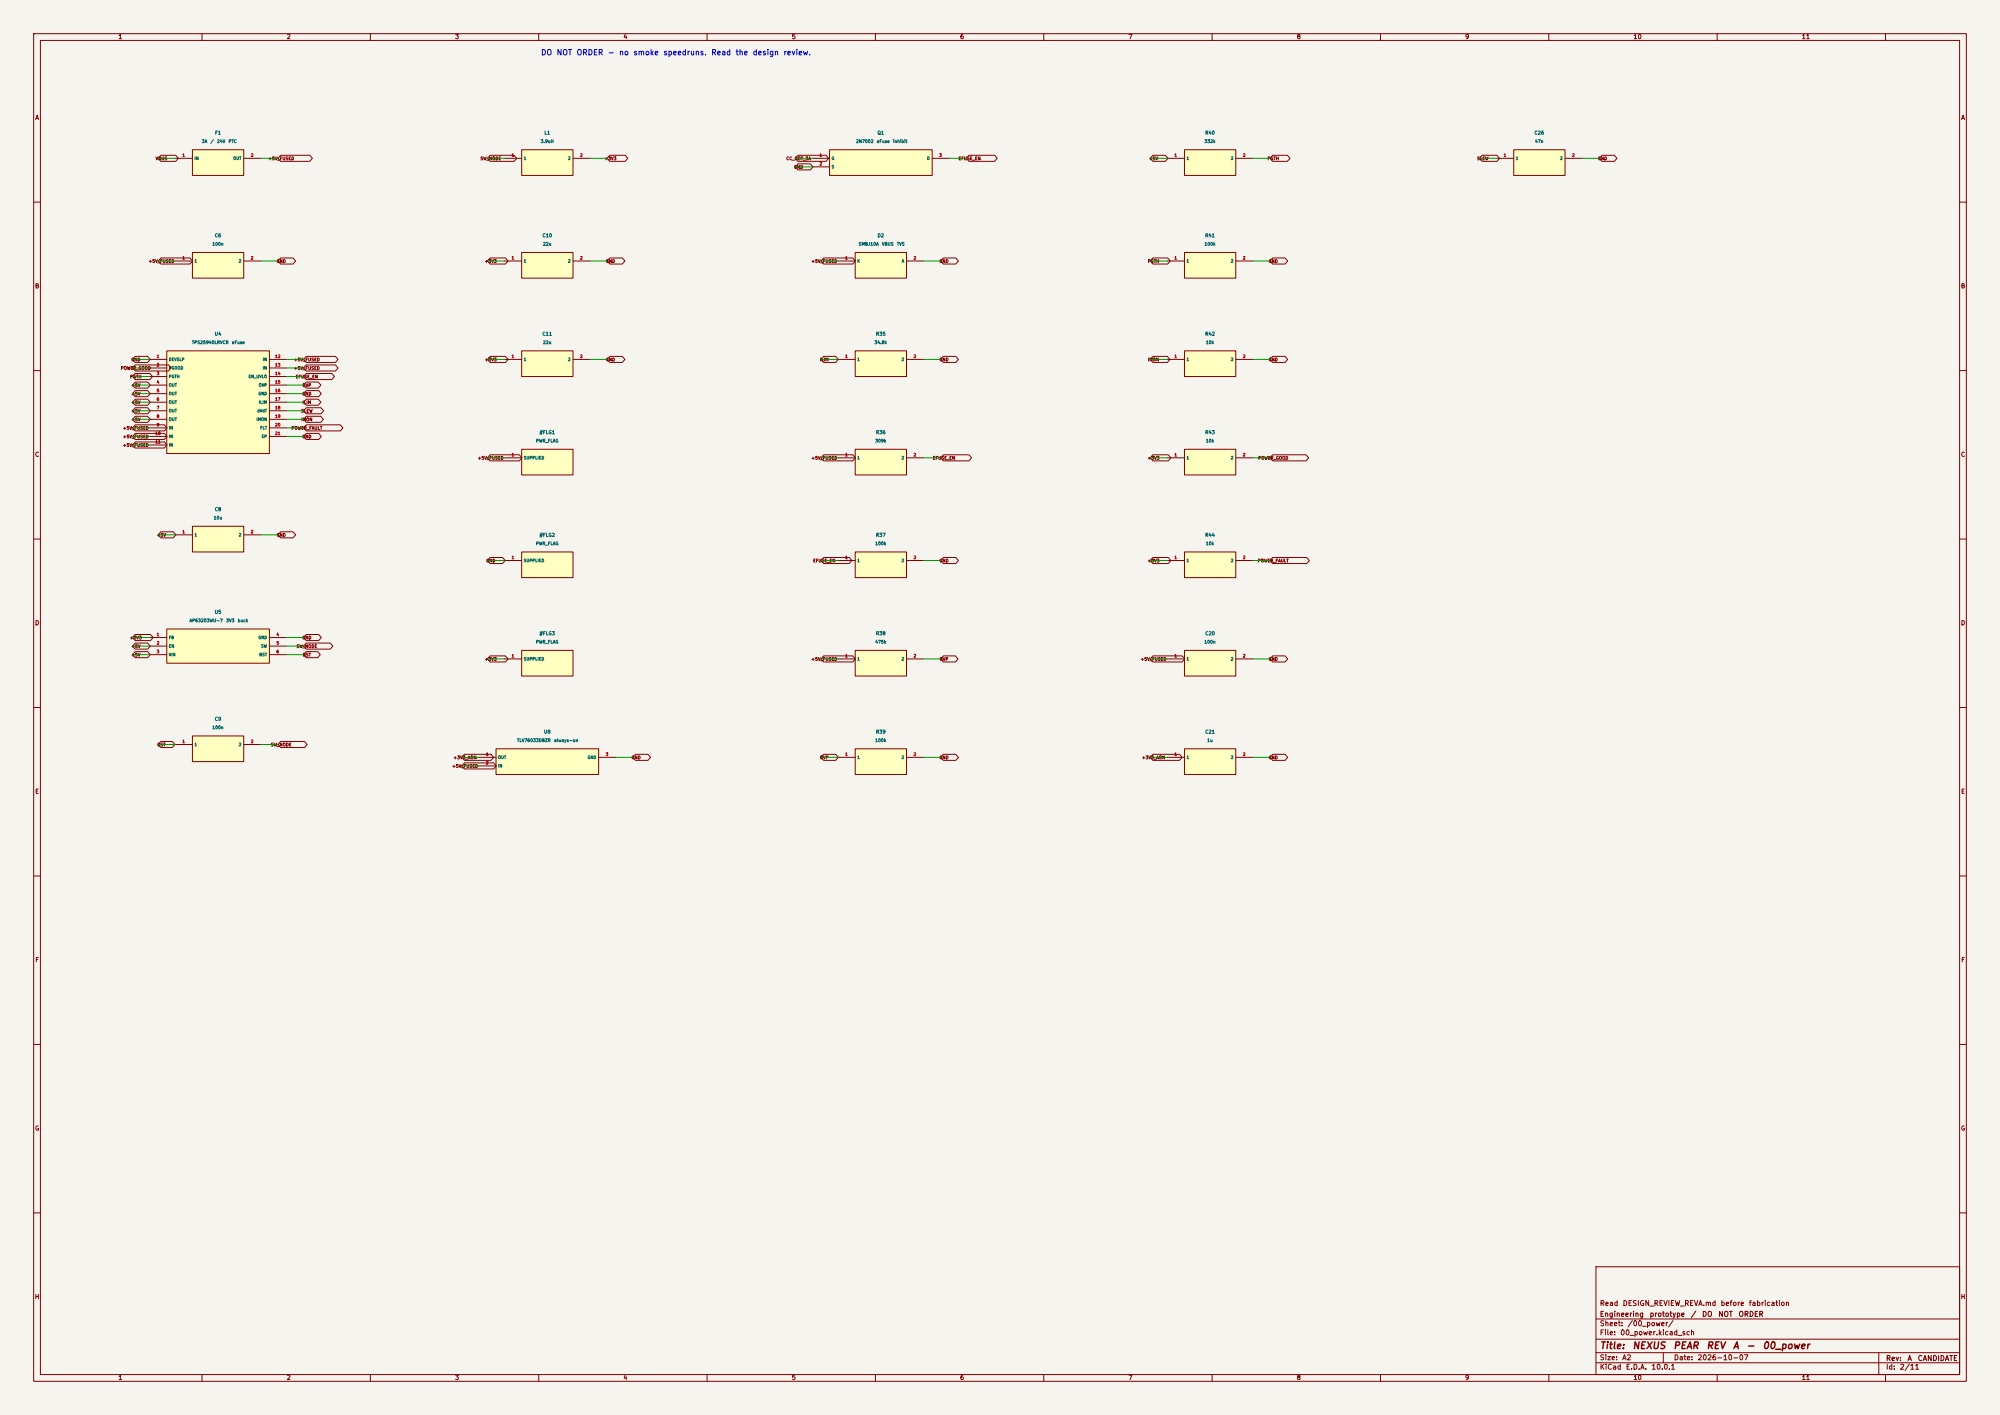
[picture p4: page 2]

DO NOT ORDER - no smoke speedruns. Read the design review.

Read DESIGN_REVIEW_REVA.md before fabrication
Engineering prototype / DO NOT ORDER
Sheet: /00_power/
File: 00_power.kicad_sch
Title: NEXUS PEAR REV A - 00_power

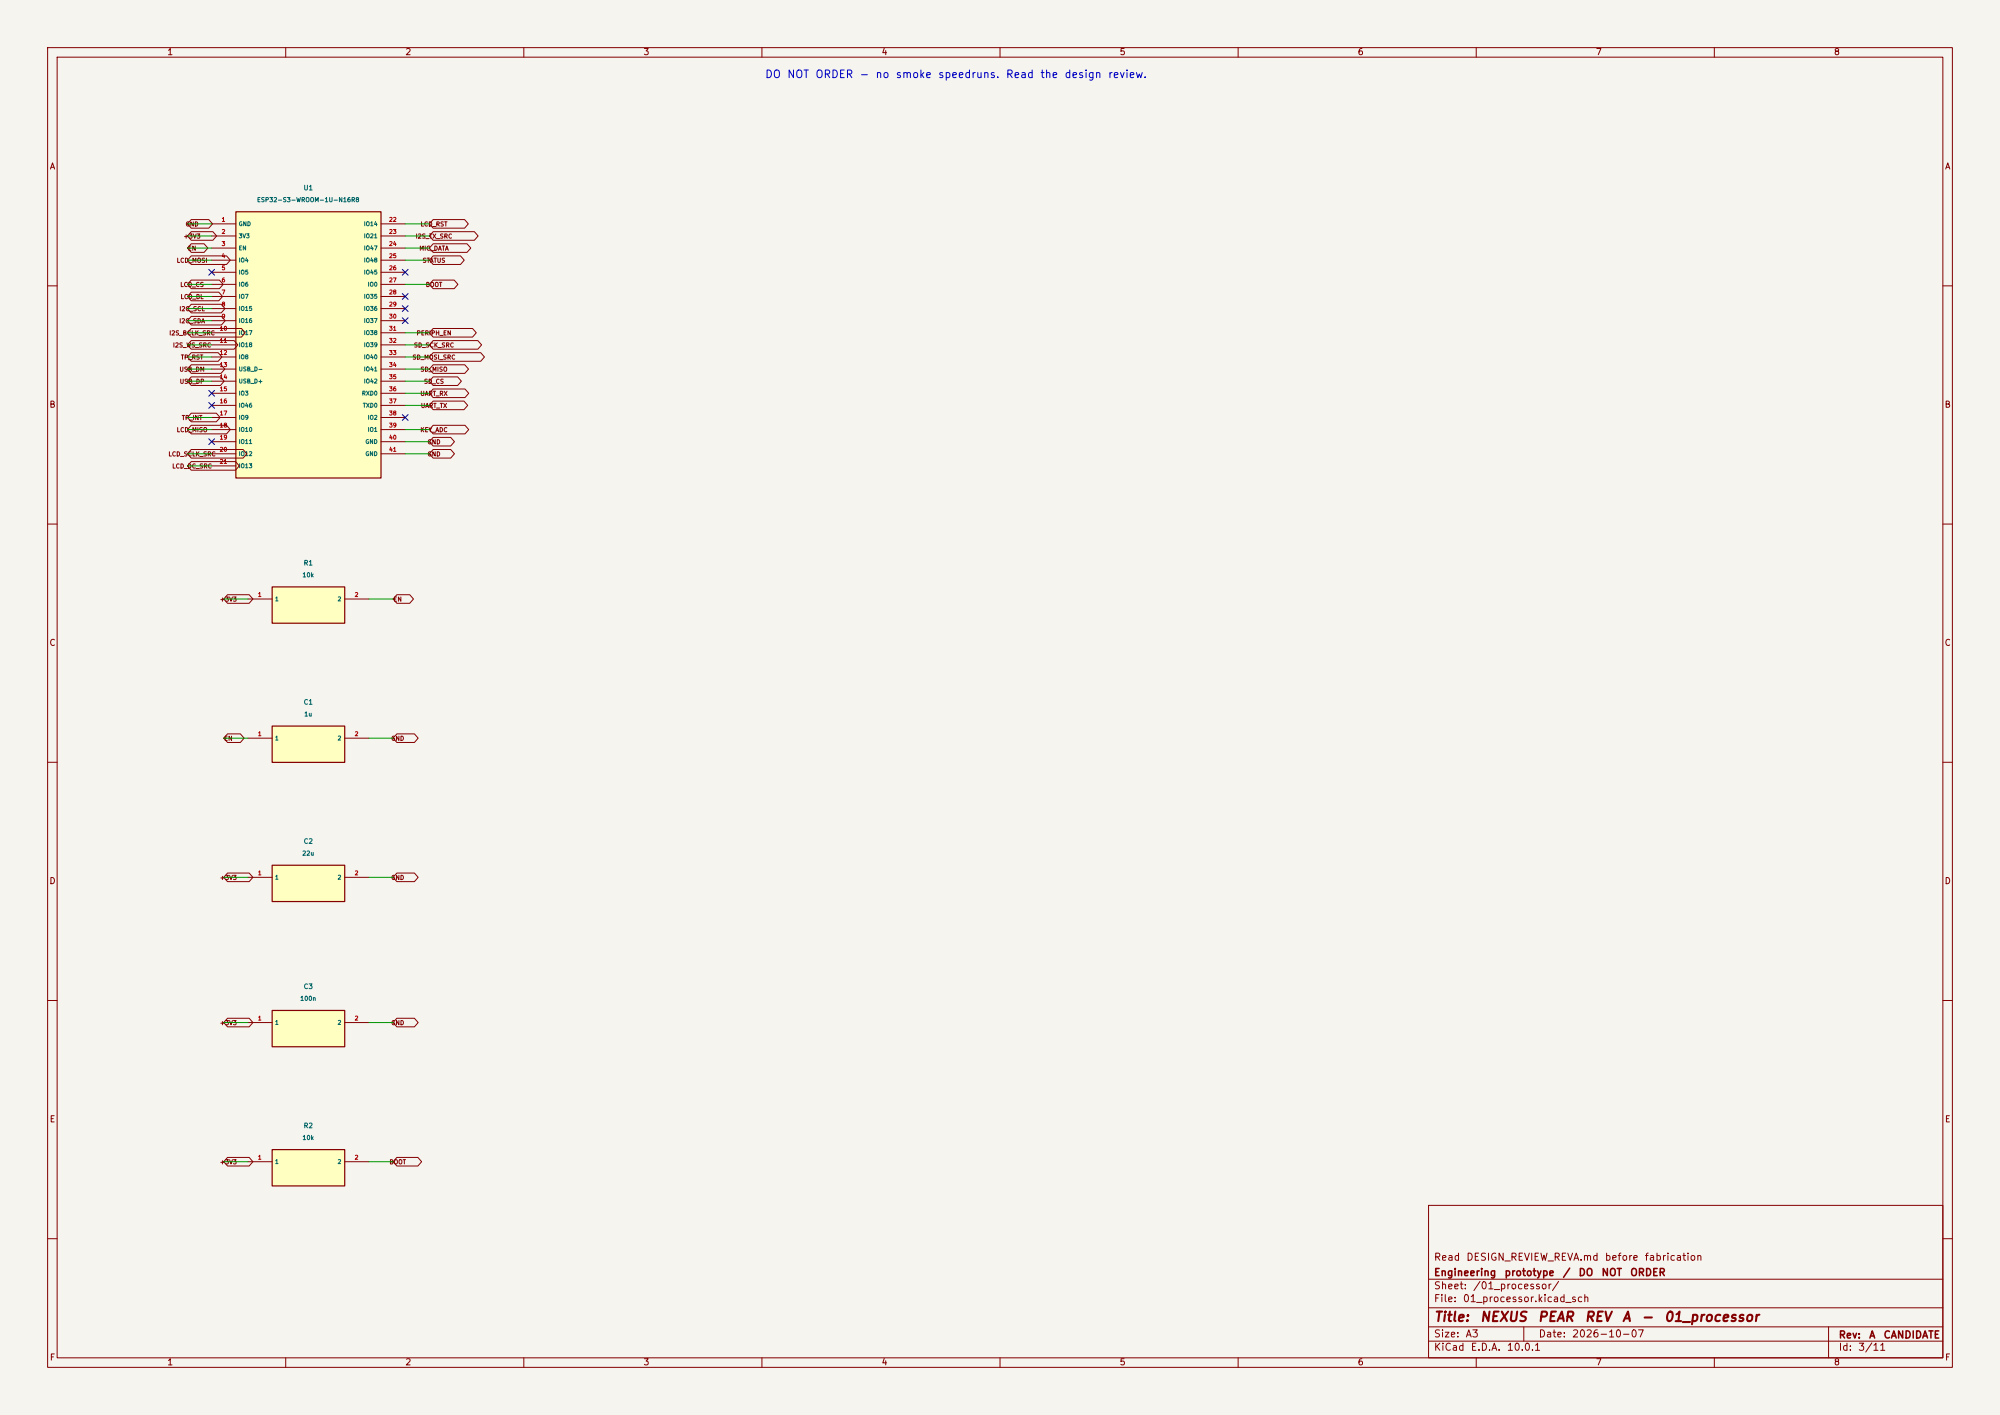
[picture p5: page 3]

DO NOT ORDER - no smoke speedruns. Read the design review.

Read DESIGN_REVIEW_REVA.md before fabrication
Engineering prototype / DO NOT ORDER
Sheet: /01_processor/
File: 01_processor.kicad_sch
Title: NEXUS PEAR REV A - 01_processor

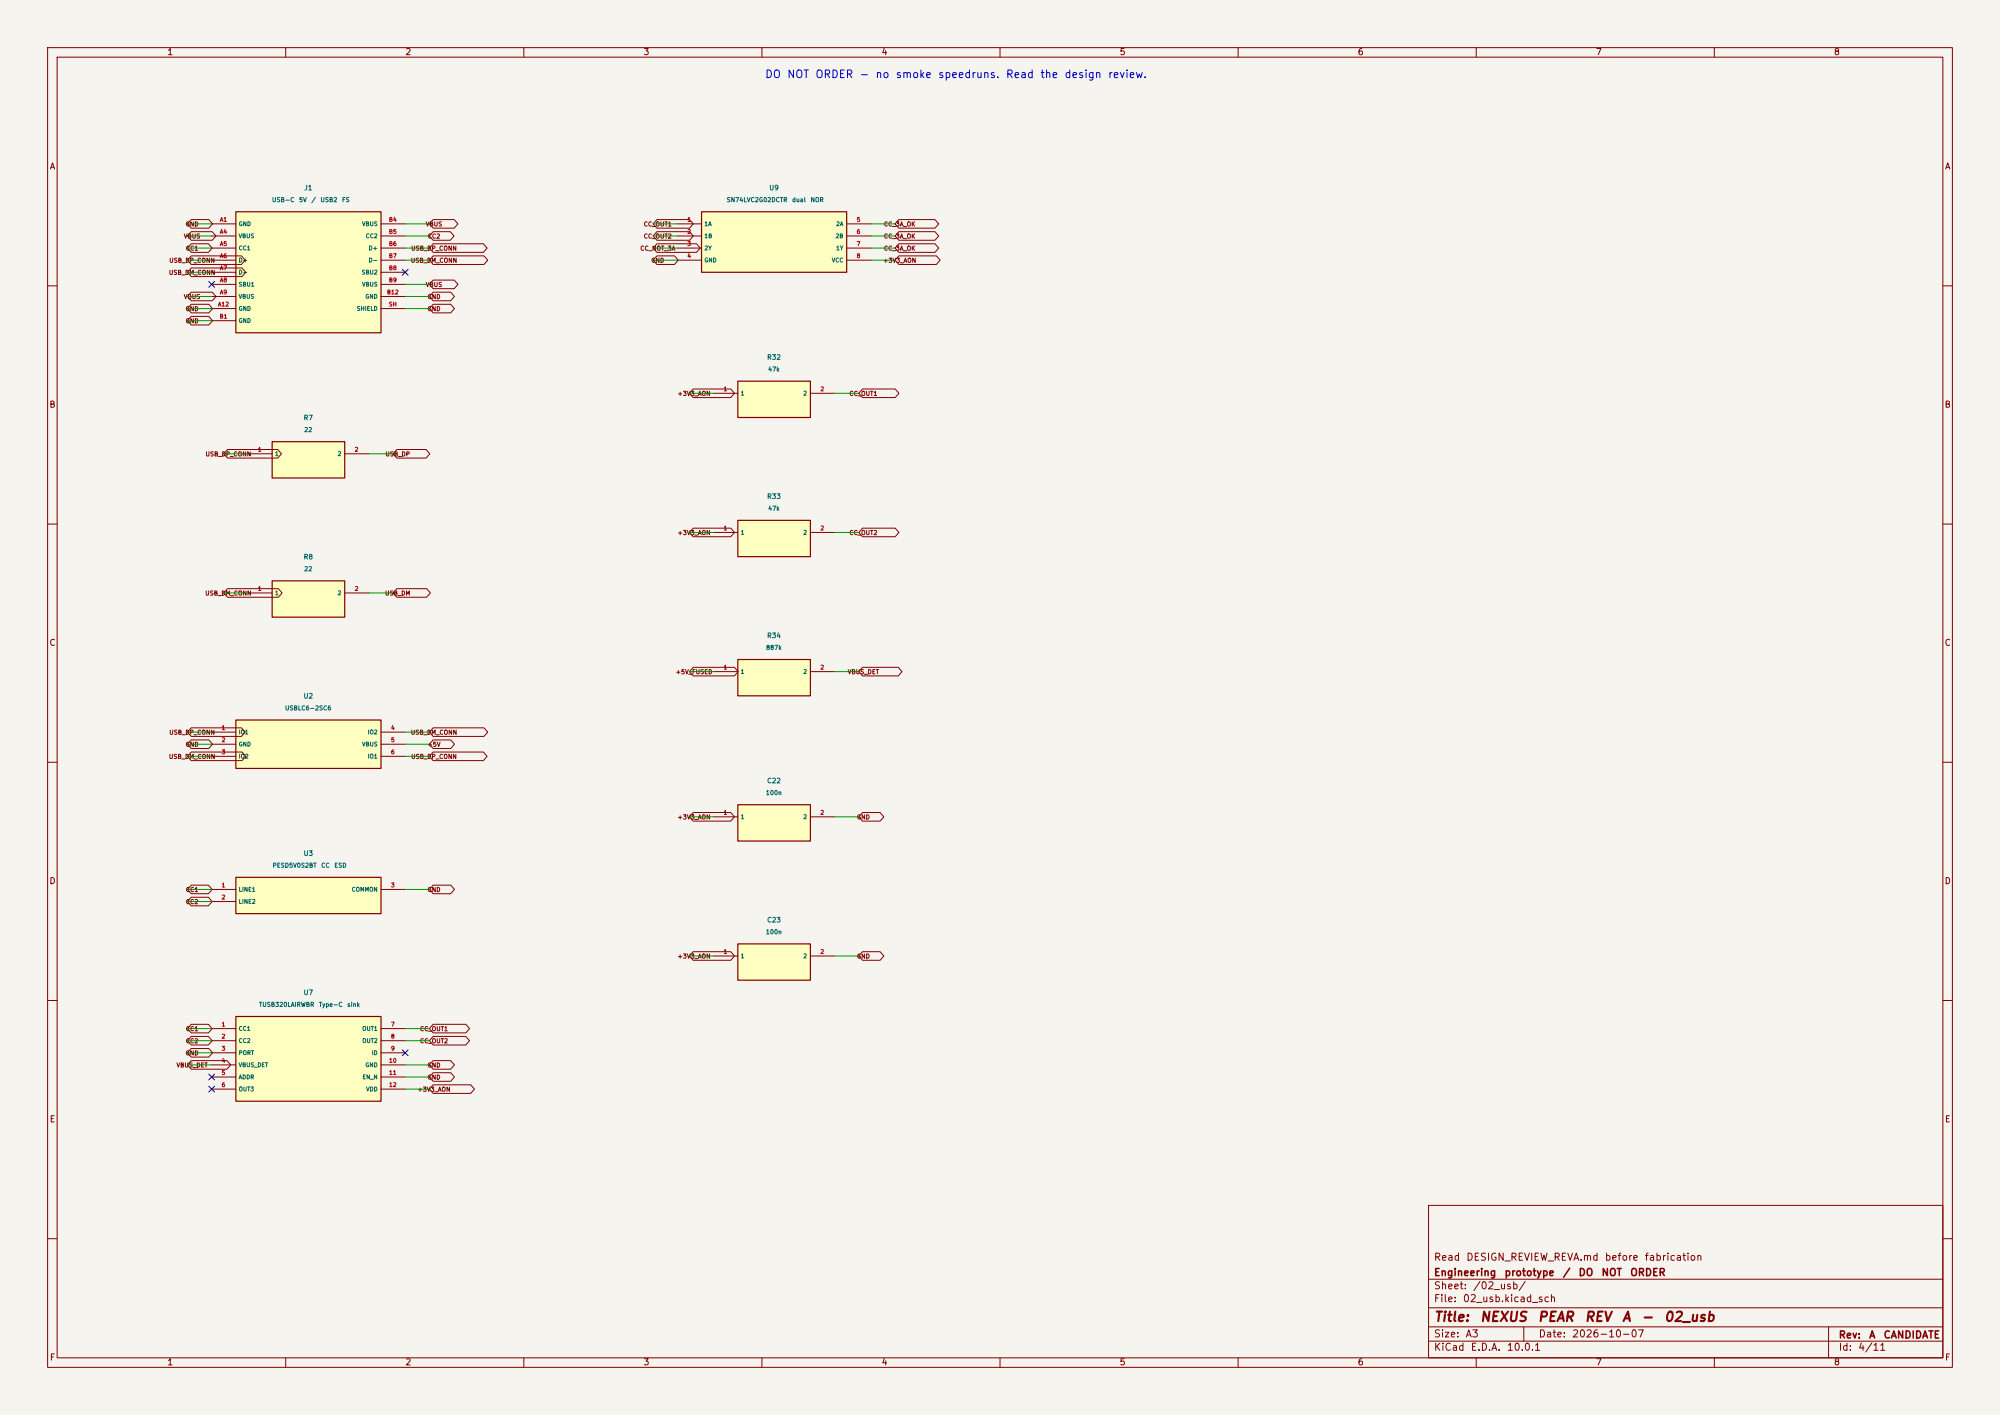
[picture p6: page 4]

Read DESIGN_REVIEW_REVA.md before fabrication
Engineering prototype / DO NOT ORDER
Sheet: /02_usb/
File: 02_usb.kicad_sch
Title: NEXUS PEAR REV A - 02_usb

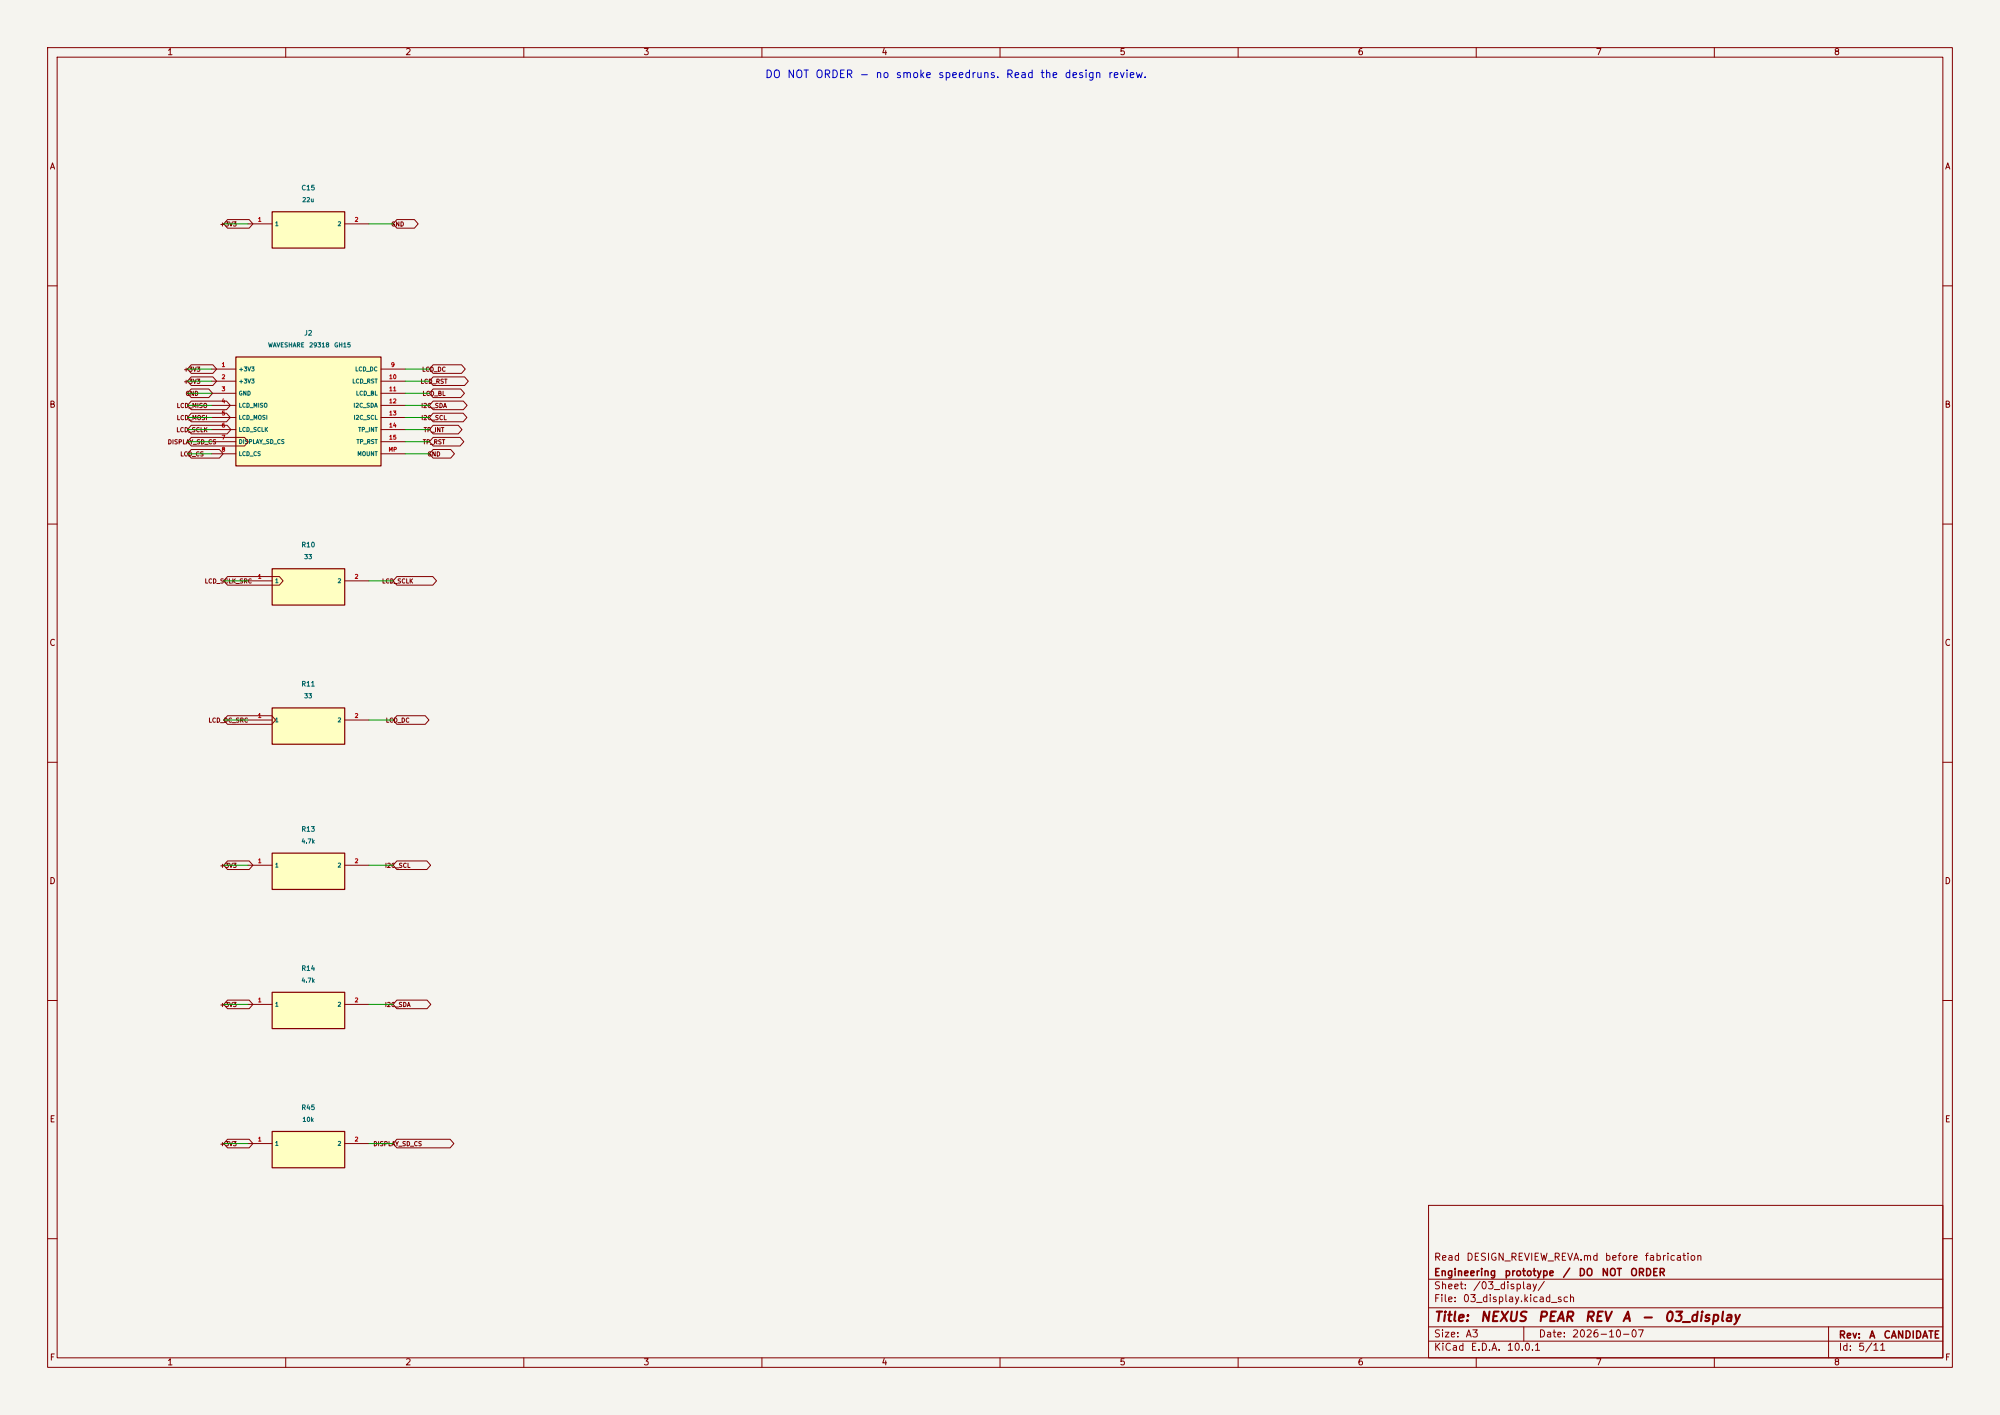
[picture p7: page 5]

Read DESIGN_REVIEW_REVA.md before fabrication
Engineering prototype / DO NOT ORDER
Sheet: /03_display/
File: 03_display.kicad_sch
Title: NEXUS PEAR REV A - 03_display

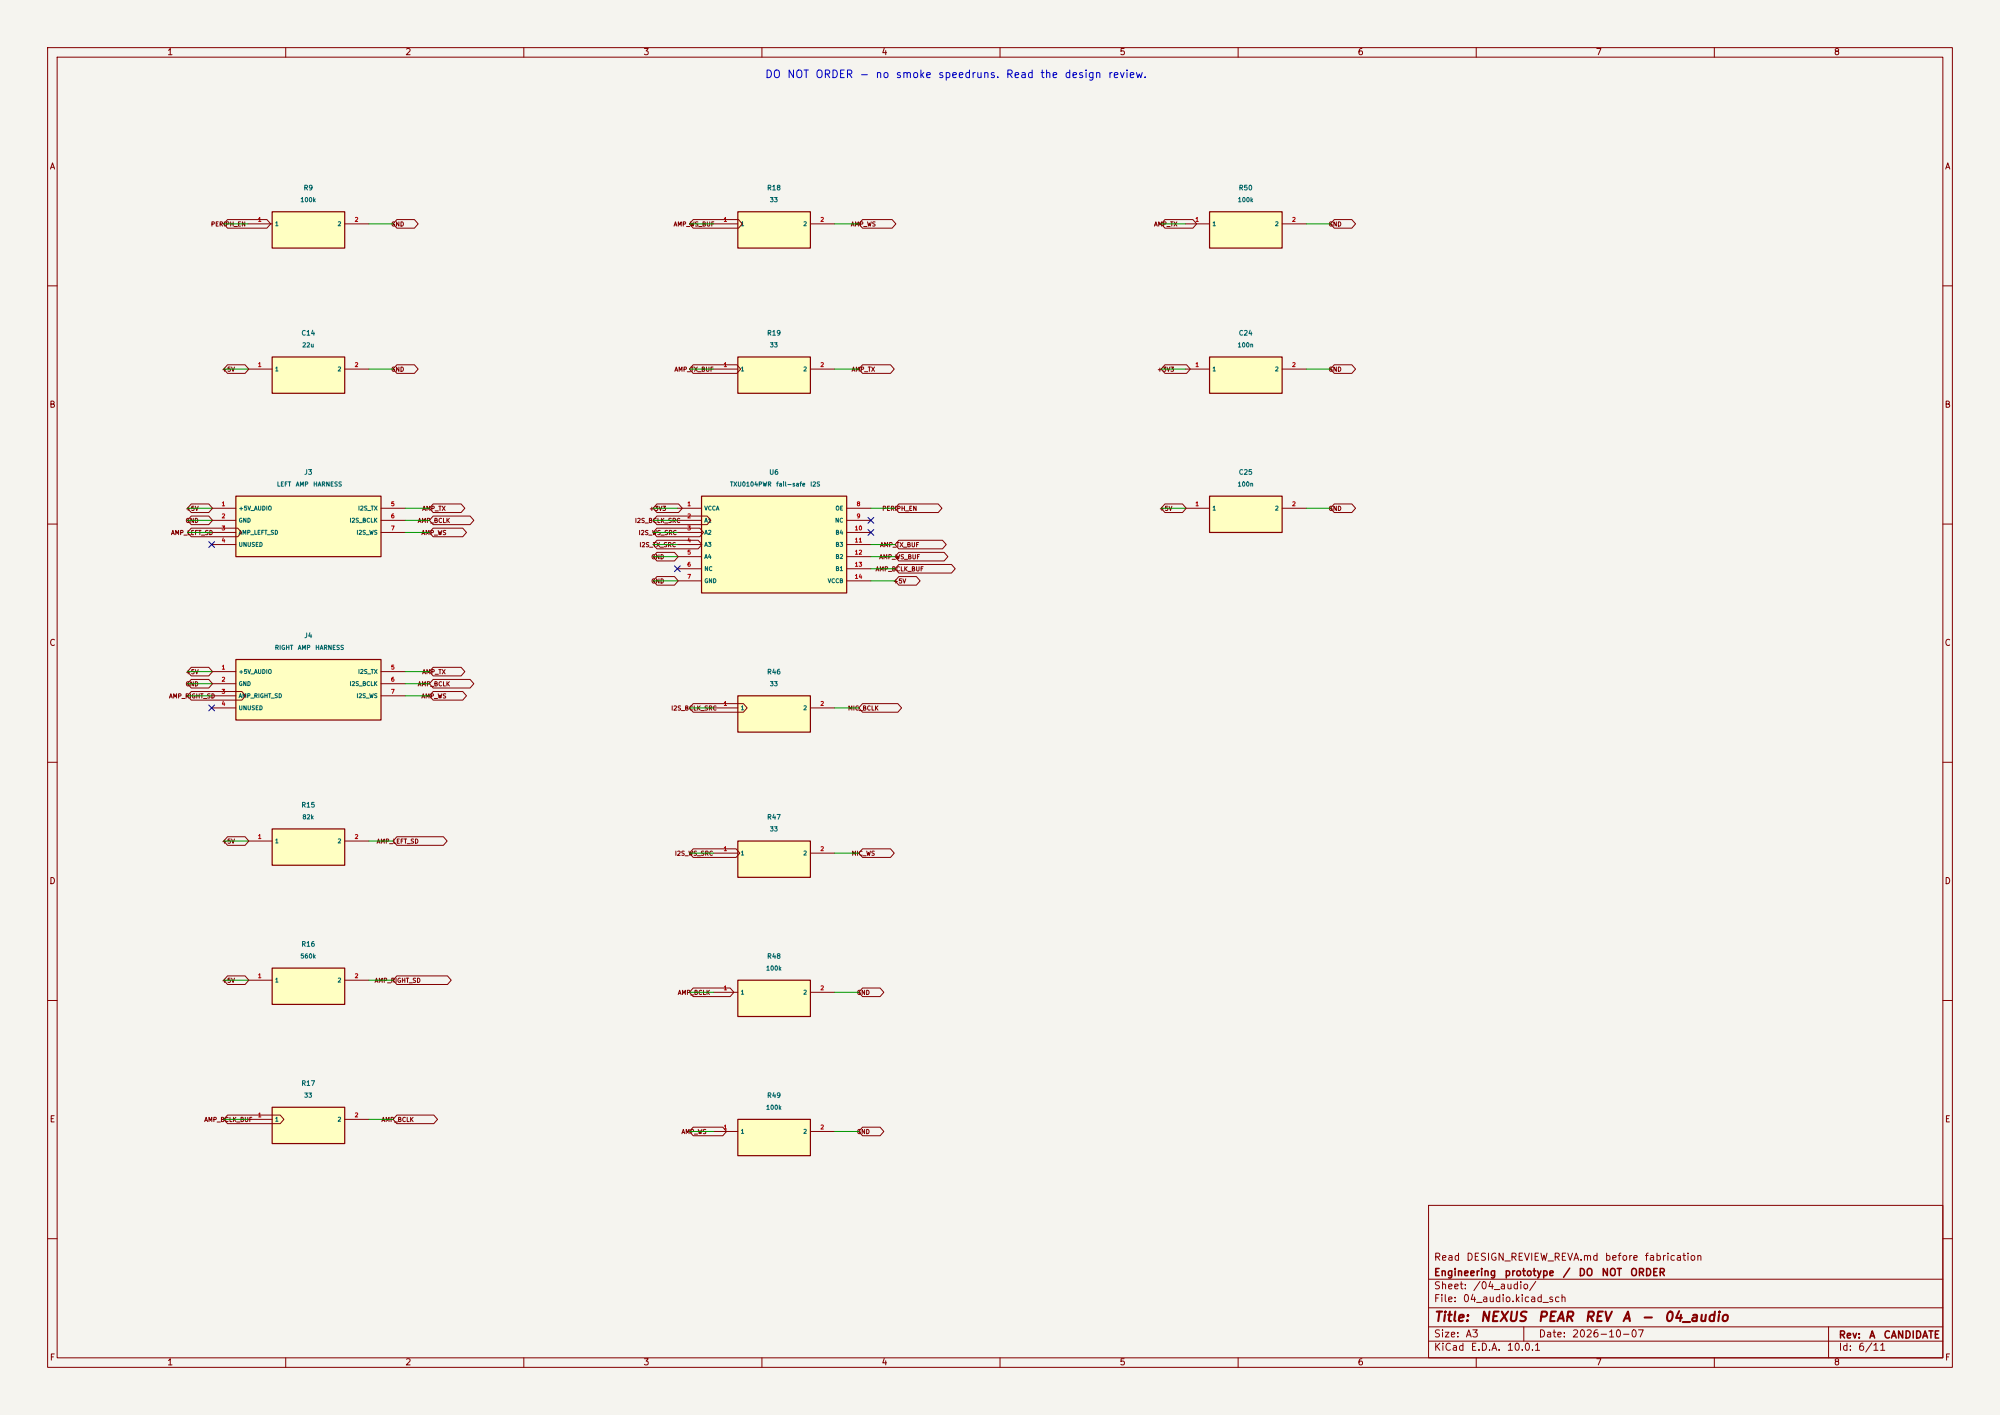
[picture p8: page 6]

Read DESIGN_REVIEW_REVA.md before fabrication
Engineering prototype / DO NOT ORDER
Sheet: /04_audio/
File: 04_audio.kicad_sch
Title: NEXUS PEAR REV A - 04_audio

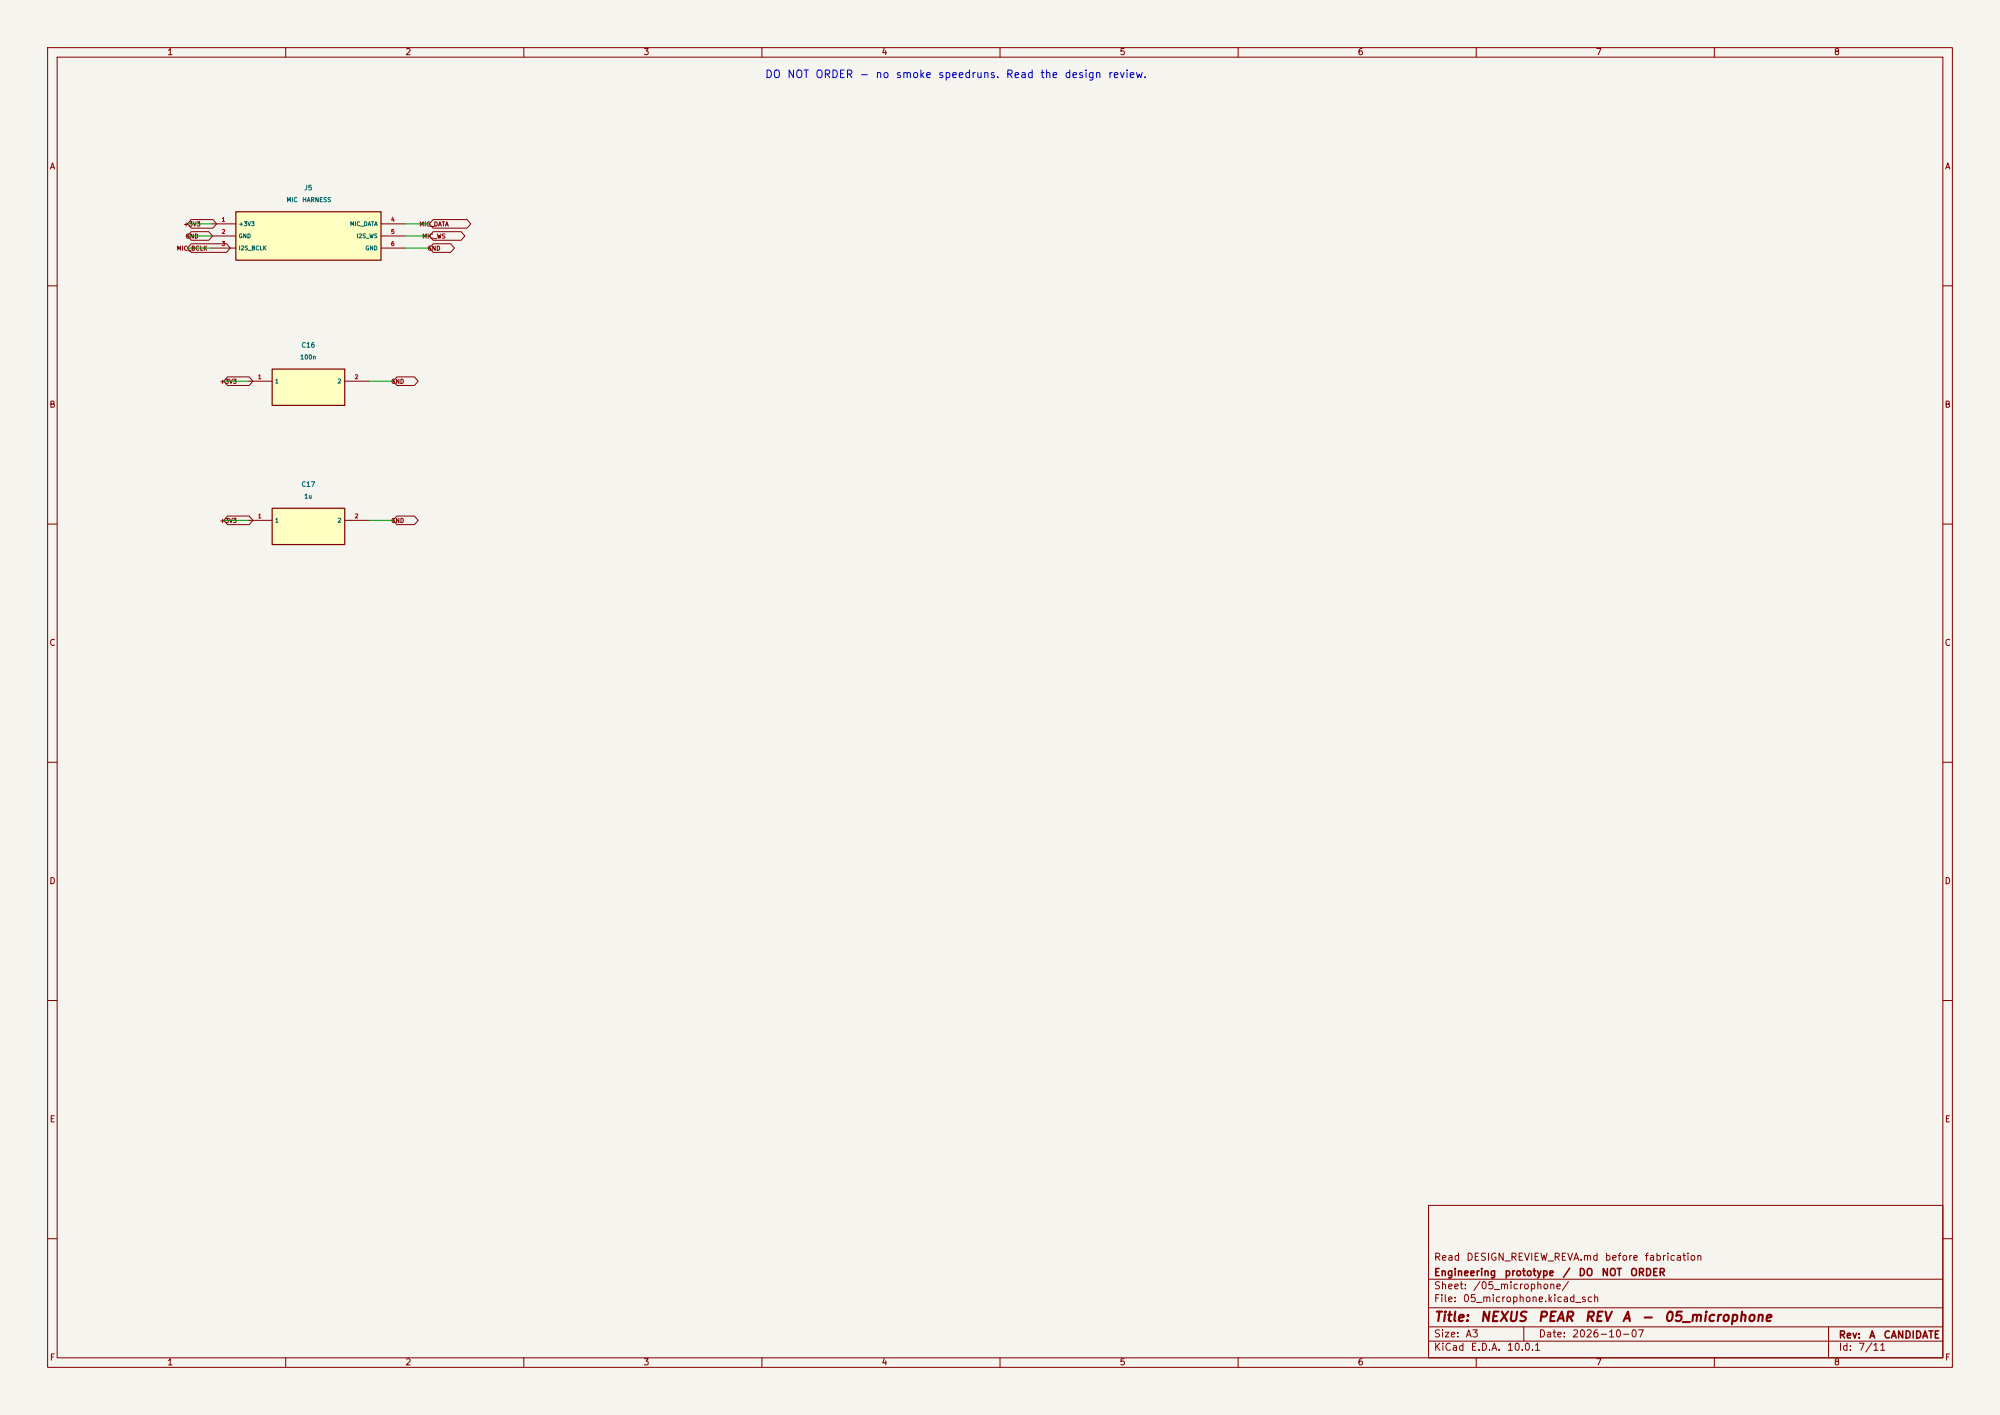
[picture p9: page 7]

Read DESIGN_REVIEW_REVA.md before fabrication
Engineering prototype / DO NOT ORDER
Sheet: /05_microphone/
File: 05_microphone.kicad_sch
Title: NEXUS PEAR REV A - 05_microphone

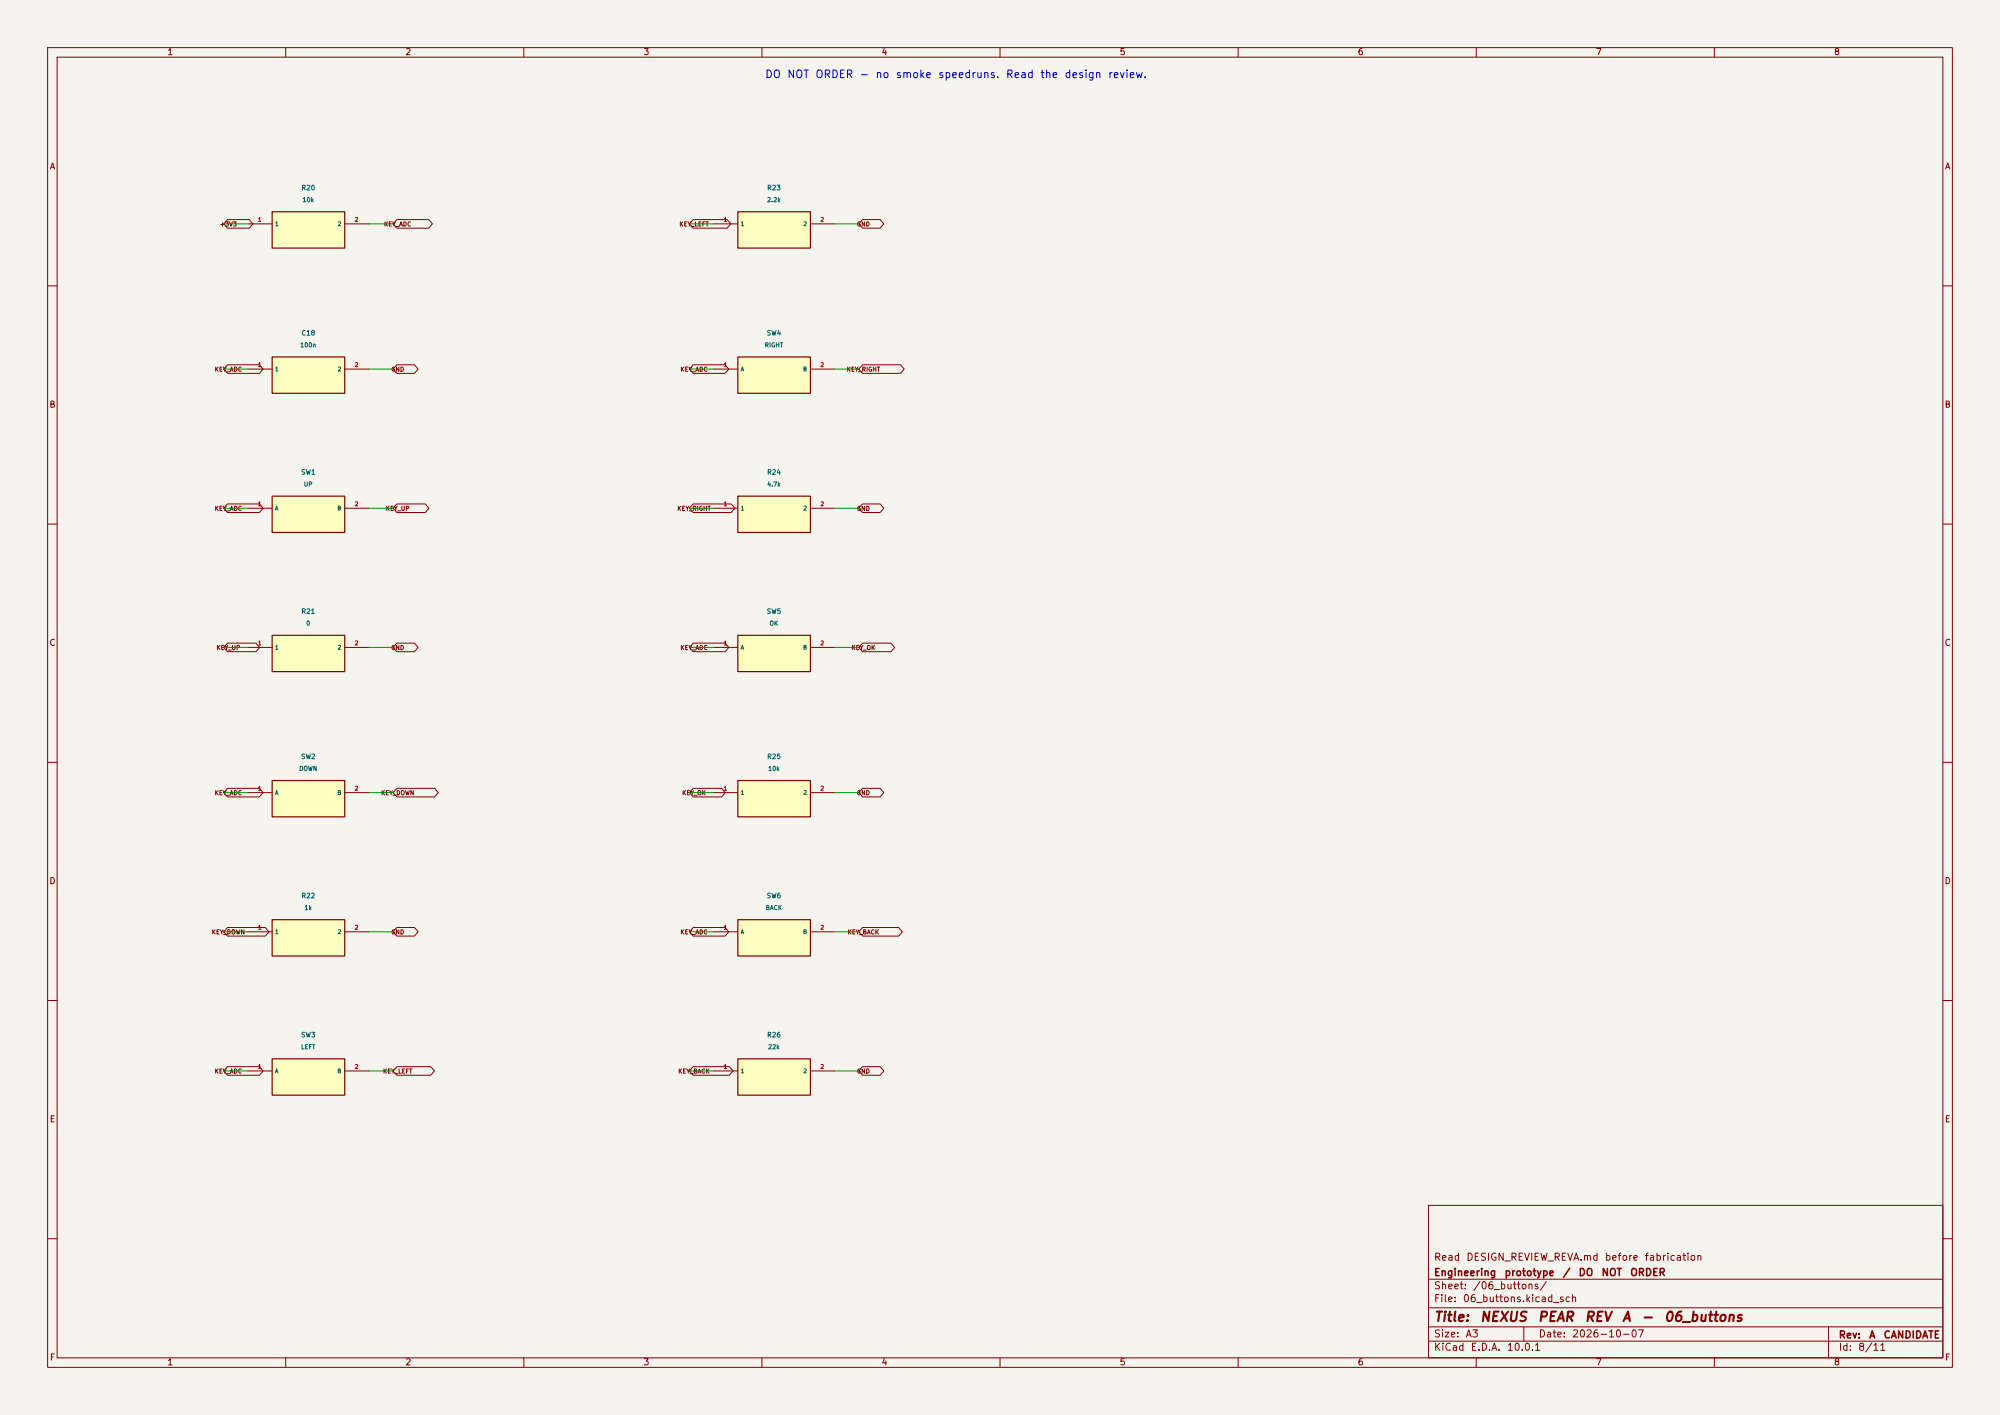
[picture p10: page 8]

Read DESIGN_REVIEW_REVA.md before fabrication
Engineering prototype / DO NOT ORDER
Sheet: /06_buttons/
File: 06_buttons.kicad_sch
Title: NEXUS PEAR REV A - 06_buttons

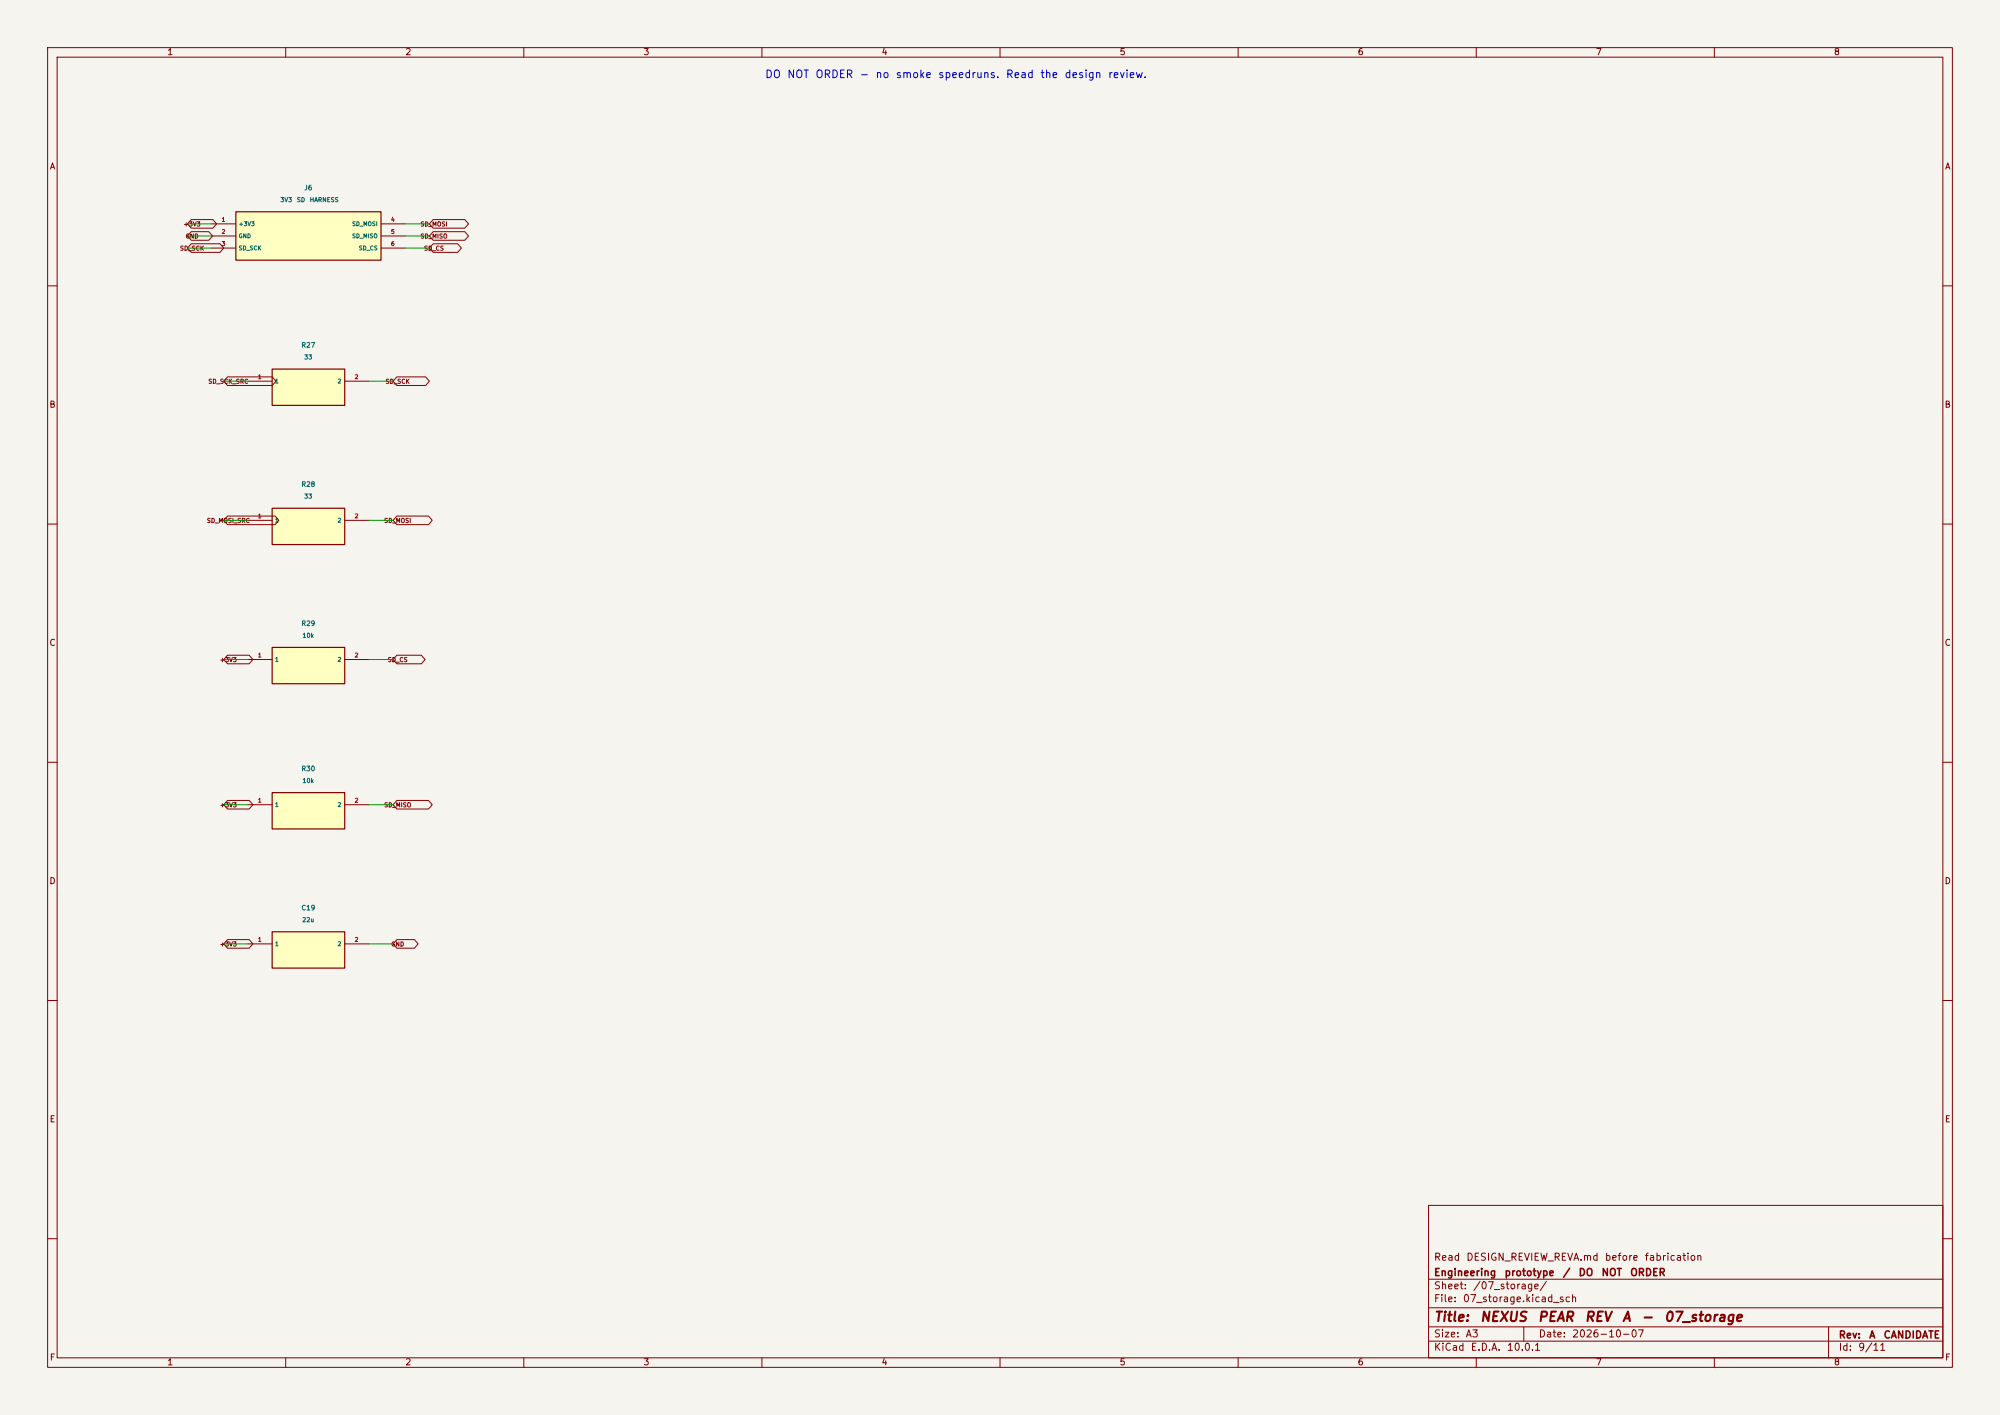
[picture p11: page 9]

DO NOT ORDER - no smoke speedruns. Read the design review.

Read DESIGN_REVIEW_REVA.md before fabrication
Engineering prototype / DO NOT ORDER
Sheet: /07_storage/
File: 07_storage.kicad_sch
Title: NEXUS PEAR REV A - 07_storage

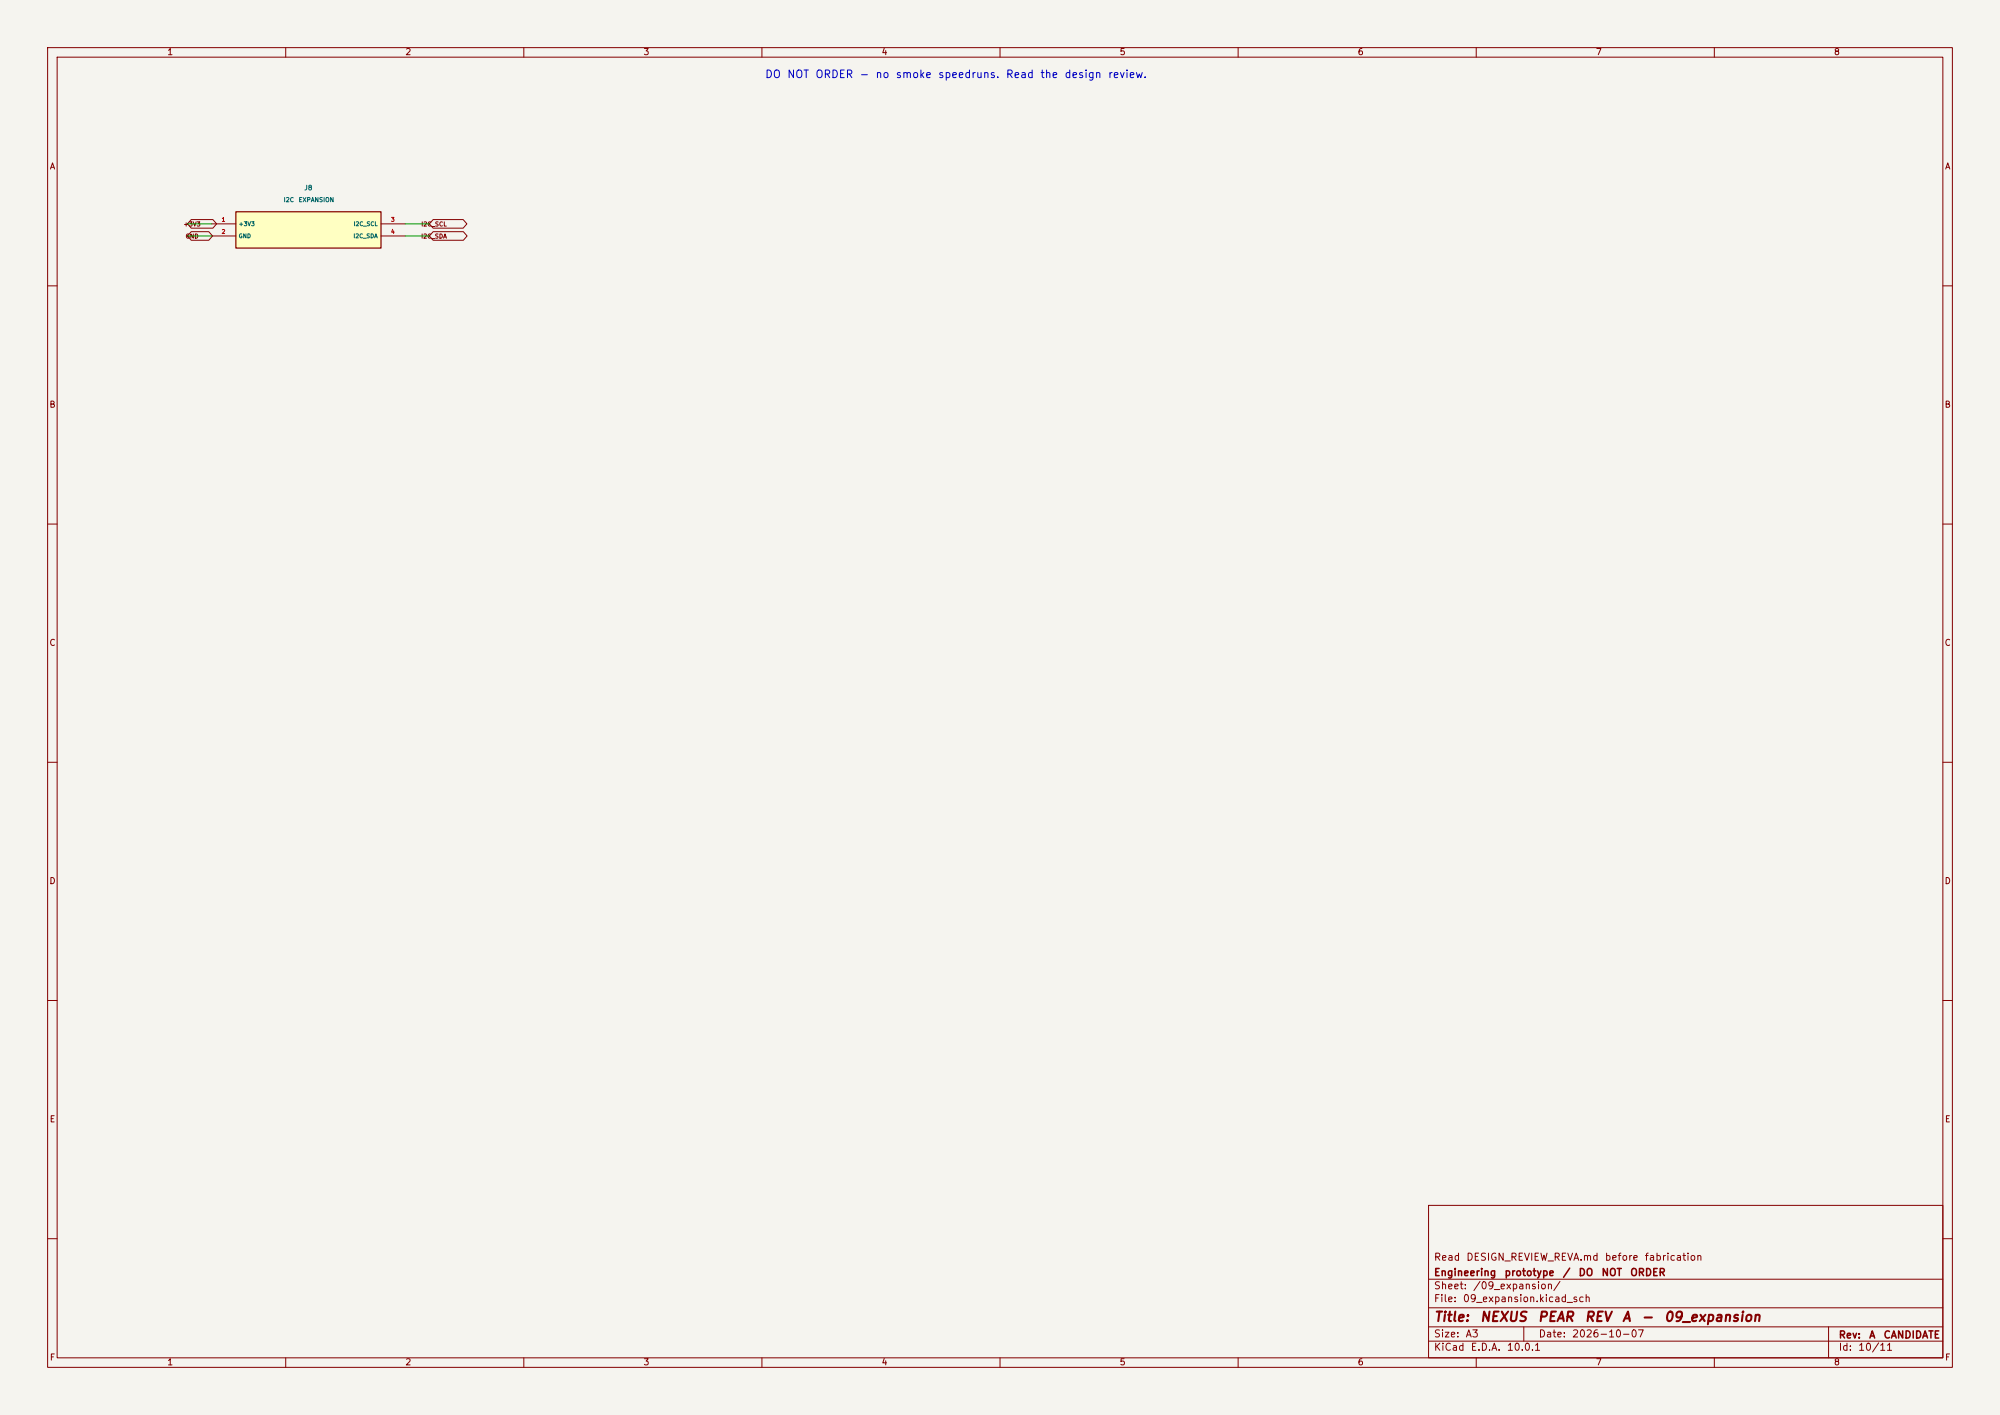
[picture p12: page 10]

Read DESIGN_REVIEW_REVA.md before fabrication
Engineering prototype / DO NOT ORDER
Sheet: /09_expansion/
File: 09_expansion.kicad_sch
Title: NEXUS PEAR REV A - 09_expansion

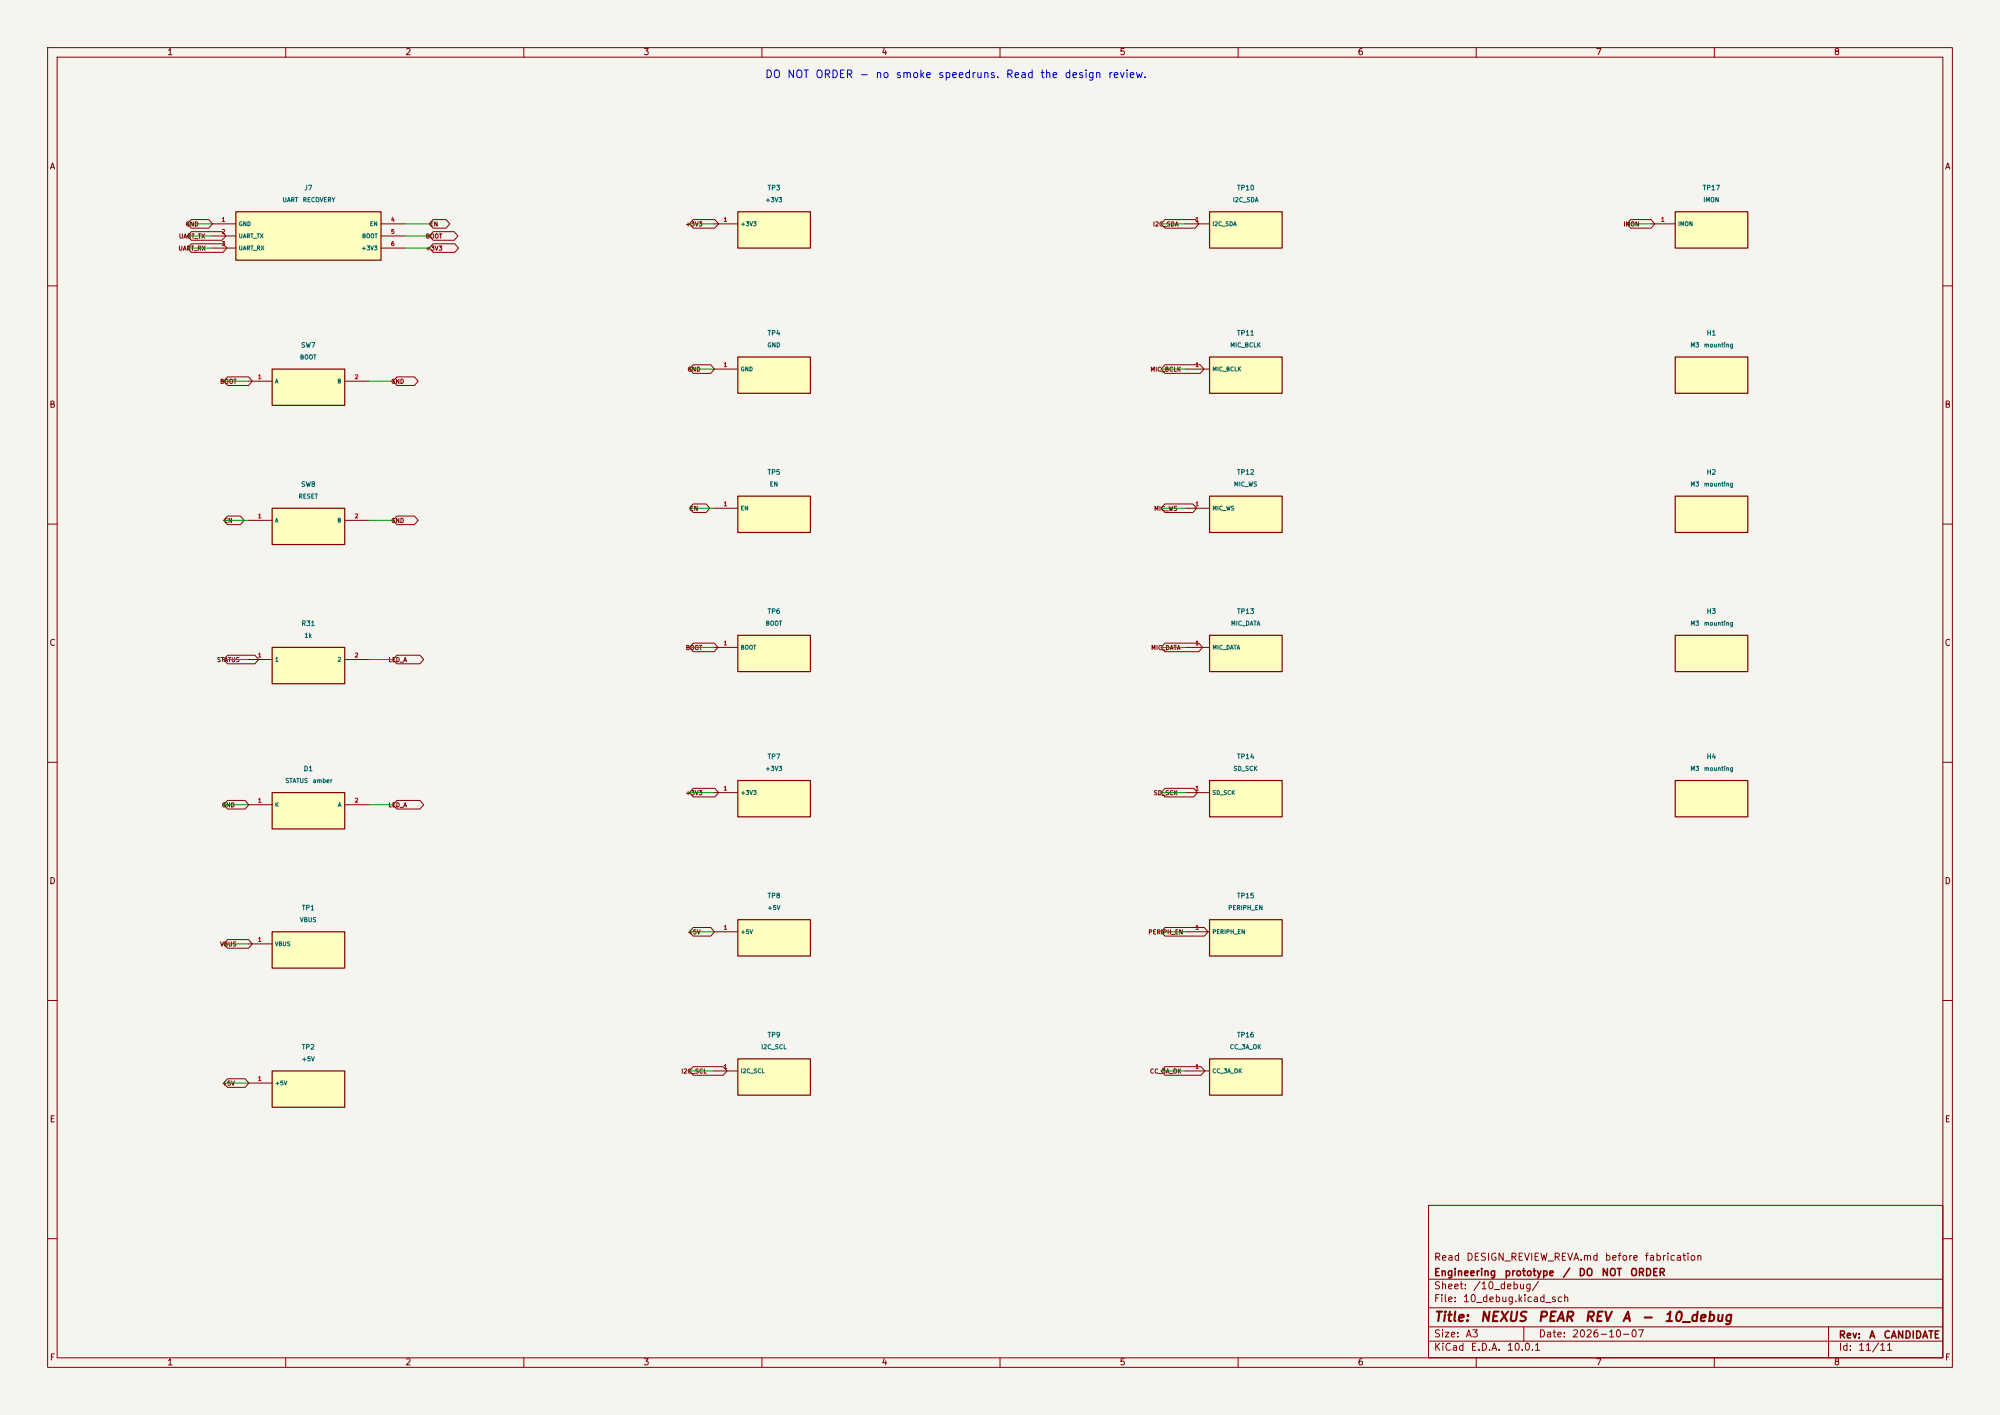
[picture p13: page 11]

Read DESIGN_REVIEW_REVA.md before fabrication
Engineering prototype / DO NOT ORDER
Sheet: /10_debug/
File: 10_debug.kicad_sch
Title: NEXUS PEAR REV A - 10_debug
