aminewe898/nexus-pear-reva/hardware/kicad/nexus-pear-reva/nexus-pear-reva.kicad_pcb

## KiCad design hardware/kicad/nexus-pear-reva/nexus-pear-reva.kicad_pcb (2026-10-09)

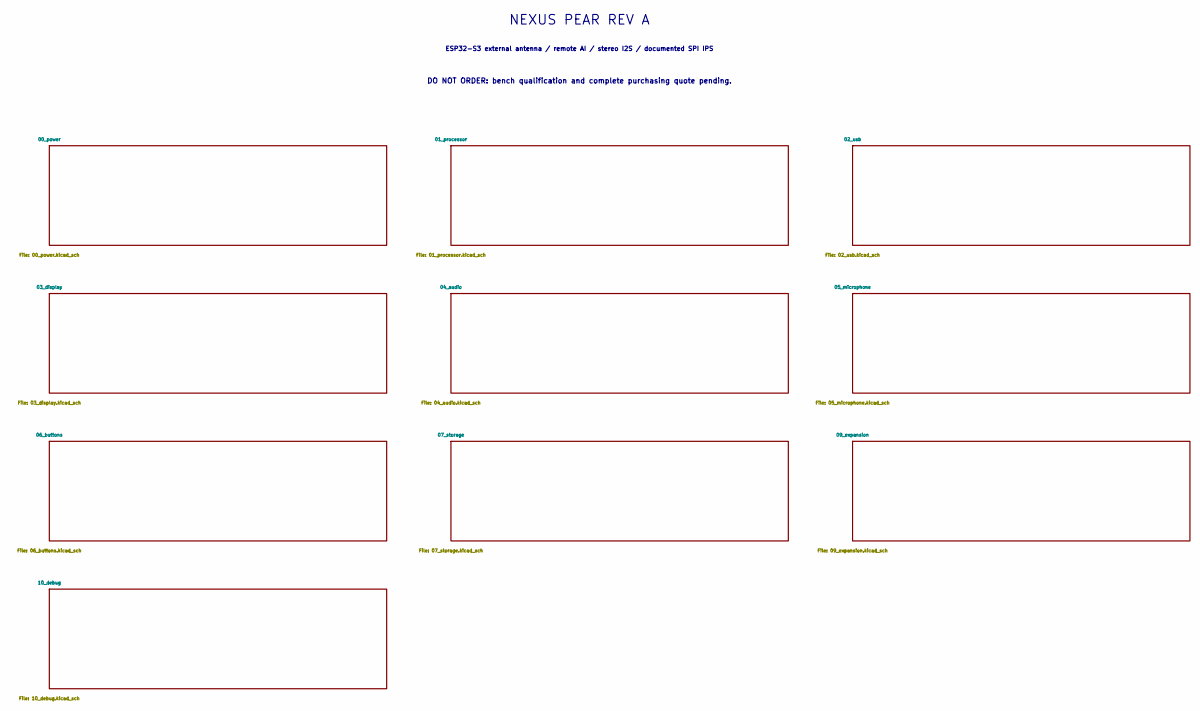
[picture p19: schematic nexus-pear-reva.kicad_sch, NEXUS PEAR REV A - System overview]

Notes on the sheet:
NEXUS PEAR REV A
ESP32-S3 external antenna / remote AI / stereo I2S / documented SPI IPS
DO NOT ORDER: bench qualification and complete purchasing quote pending.

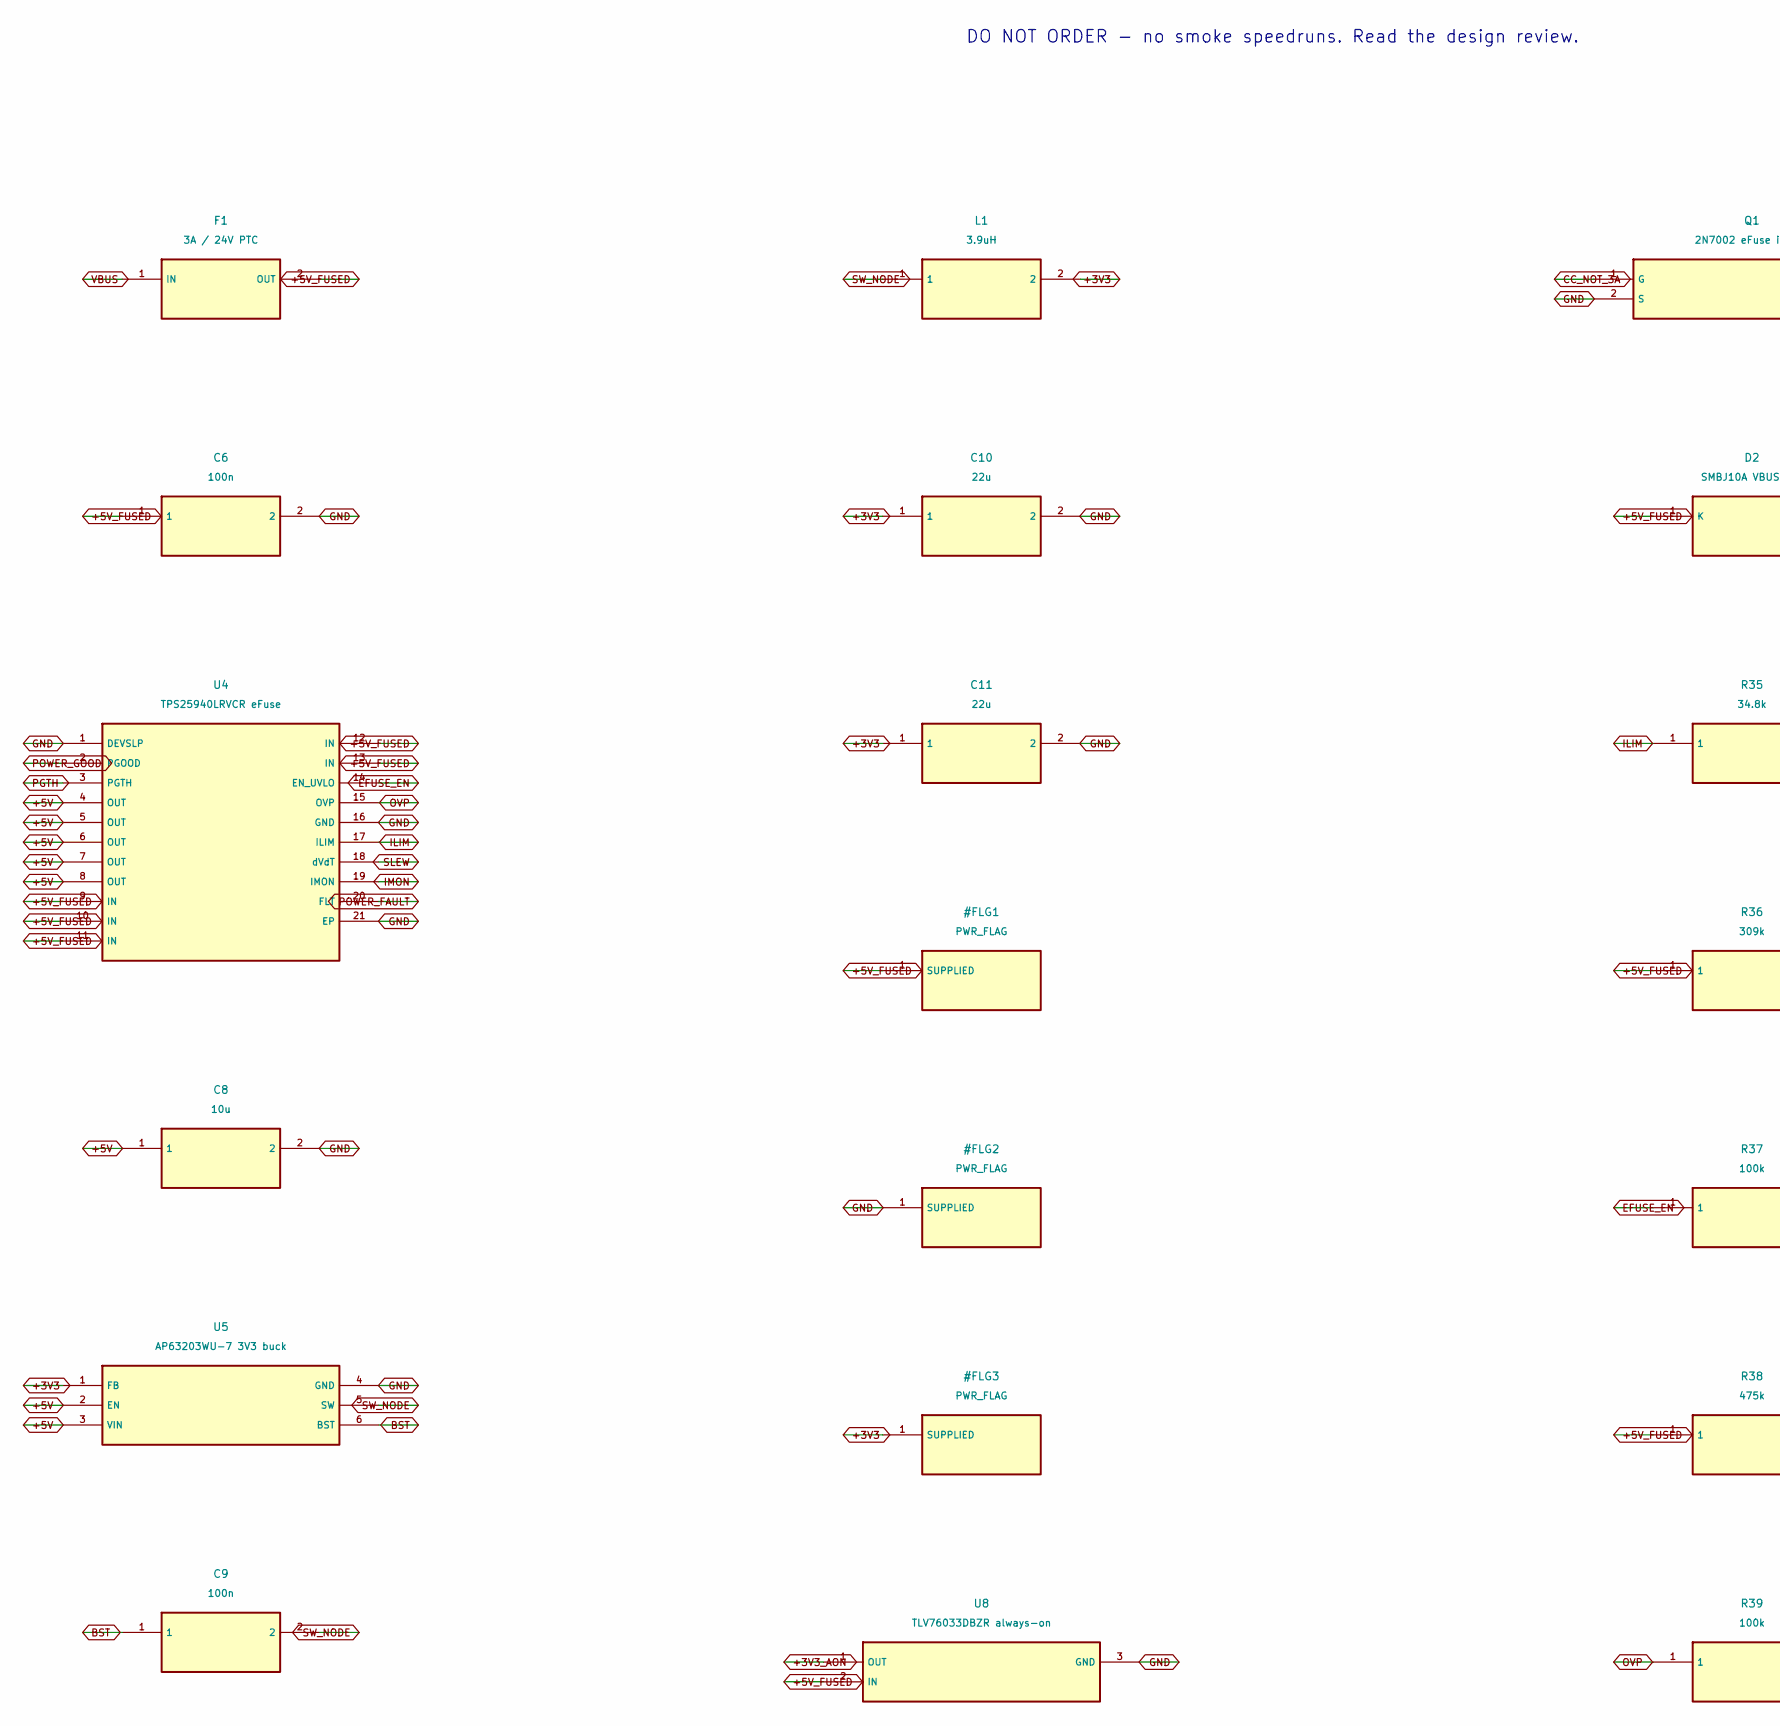
[picture p20: schematic 00_power.kicad_sch, NEXUS PEAR REV A - 00_power, part in row 1, column 1]

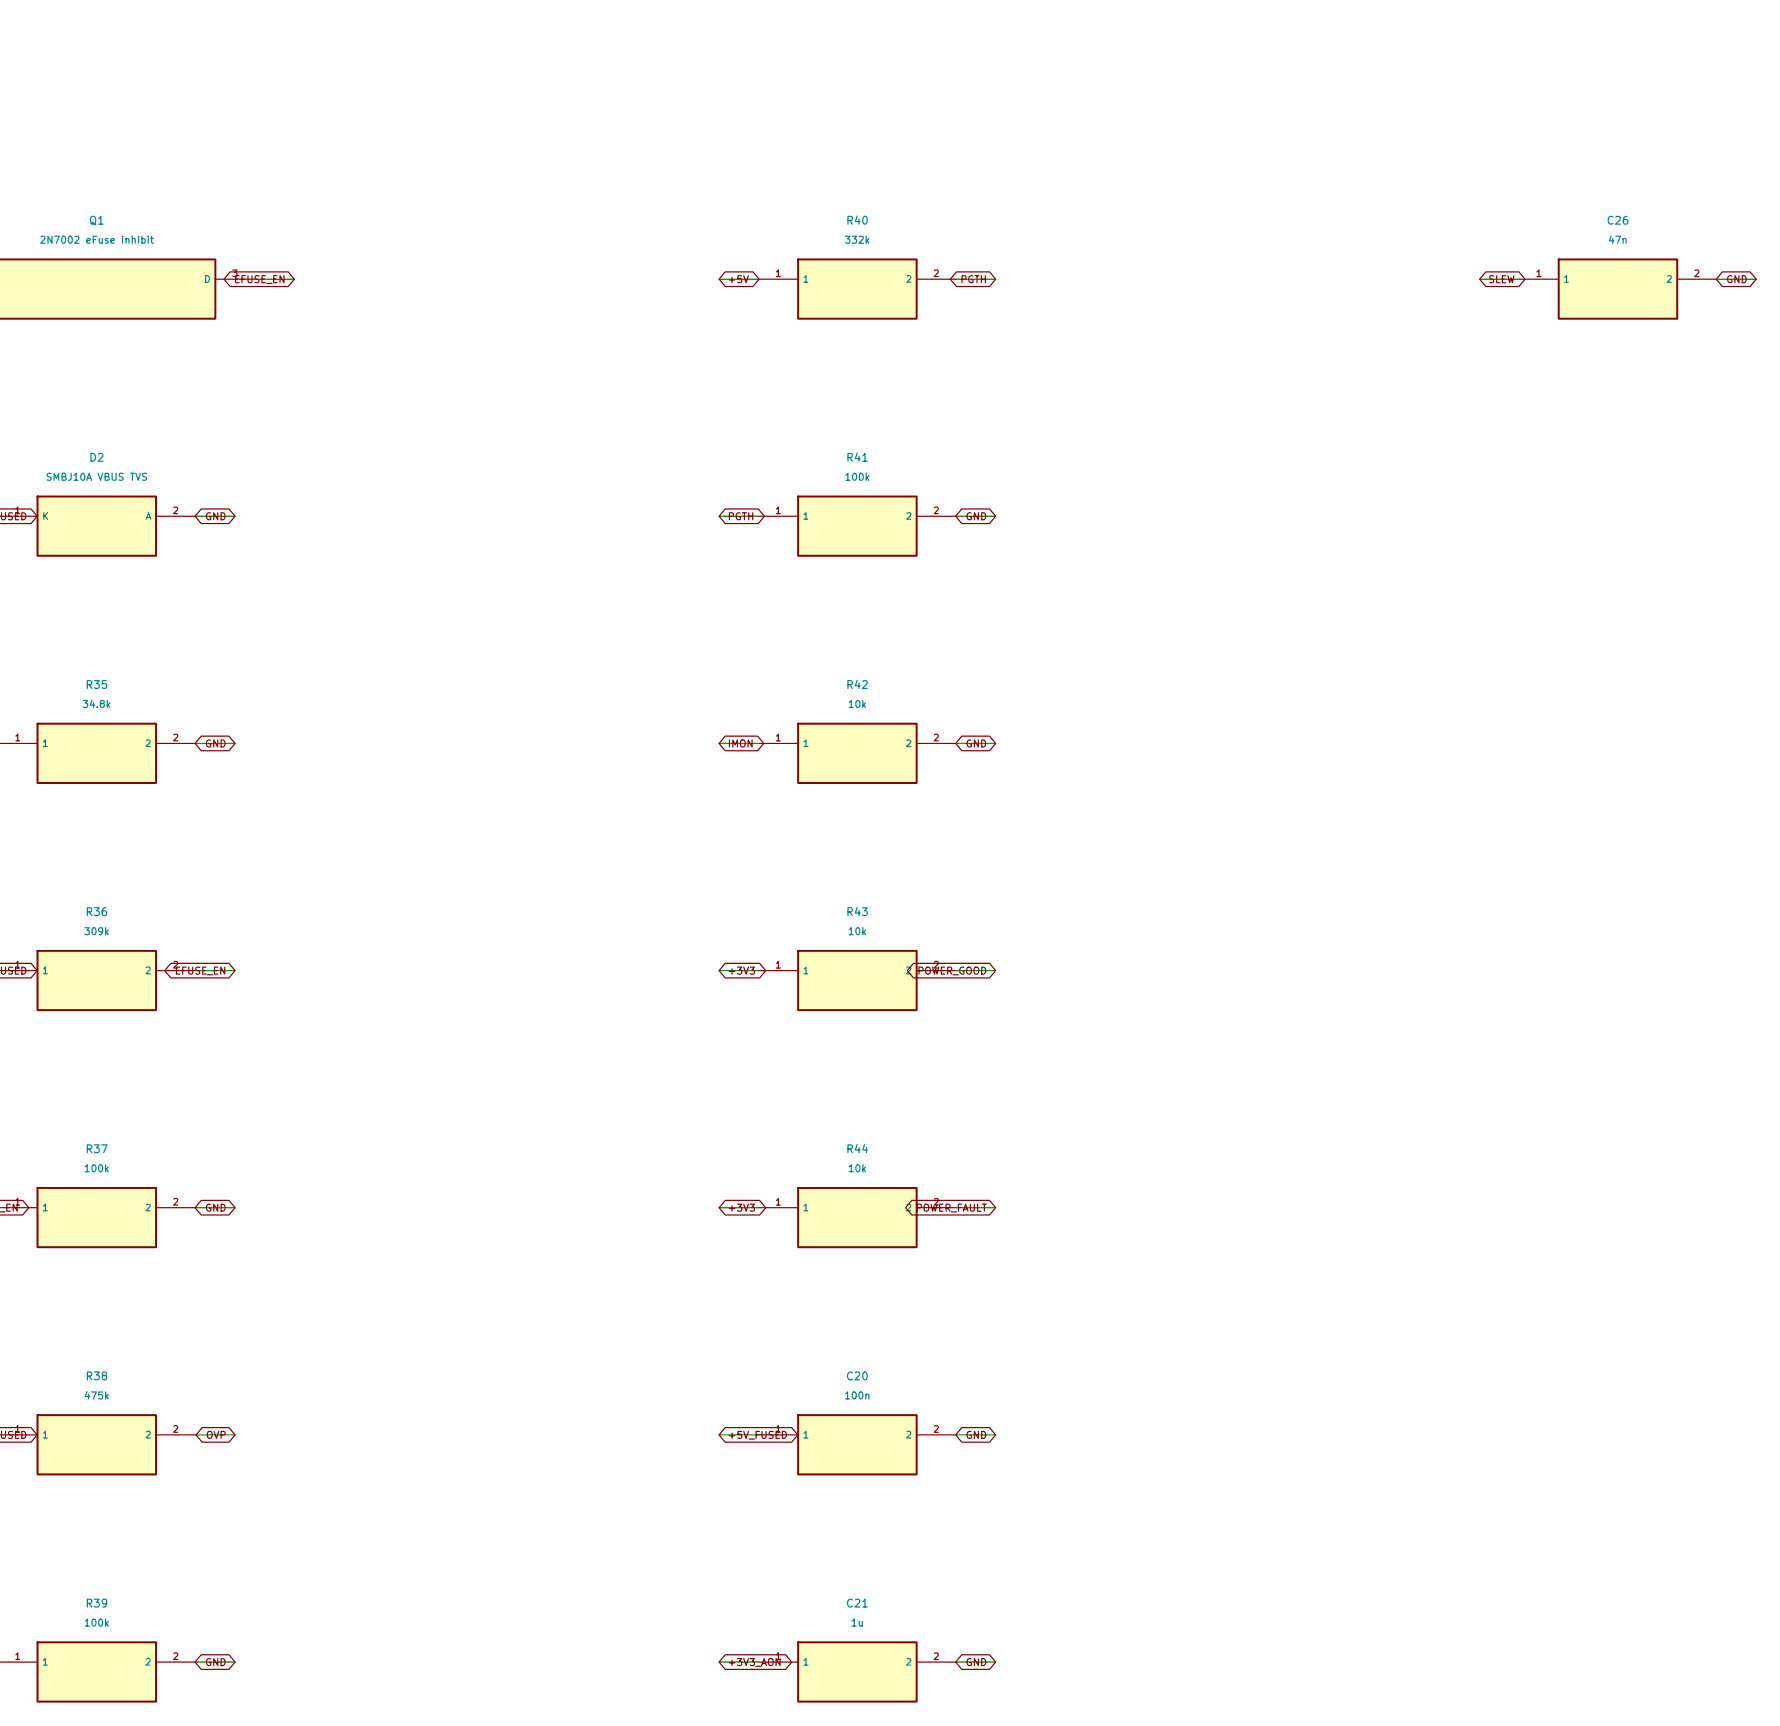
[picture p21: schematic 00_power.kicad_sch, NEXUS PEAR REV A - 00_power, part in row 1, column 2]

Parts:
C6, C9, C20: 100n; C_0805_2012Metric; MPN GRM21BR71H104KA01L
C8: 10u; C_1206_3216Metric; MPN GRM31CR61A106KA01L
C10, C11: 22u; C_1206_3216Metric; MPN GRM31CR61A226KE19L
C21: 1u; C_0805_2012Metric; MPN GRM21BR71A105KA01L
C26: 47n; C_0805_2012Metric; MPN GRM21BR71H473KA01L
D2: SMBJ10A VBUS TVS; D_SMB; MPN SMBJ10A
F1: 3A / 24V PTC; Fuse_1812_4532Metric; MPN 1812L300/24SLER
L1: 3.9uH; L_Bourns-SRN6028; MPN SRN6028C-3R9M
Q1: 2N7002 eFuse inhibit; SOT-23; MPN 2N7002,215
R35: 34.8k; R_0805_2012Metric; MPN RC0805FR-0734K8L
R36: 309k; R_0805_2012Metric; MPN RC0805FR-07309KL
R37, R41: 100k; R_0805_2012Metric; MPN RC0805FR-07100KL
R38: 475k; R_0805_2012Metric; MPN RT0805BRD07475KL
R39: 100k; R_0805_2012Metric; MPN RT0805BRD07100KL
R40: 332k; R_0805_2012Metric; MPN RC0805FR-07332KL
R42, R43, R44: 10k; R_0805_2012Metric; MPN RC0805FR-0710KL
U4: TPS25940LRVCR eFuse; Texas_RVC0020A_WQFN-20-1EP_3x4mm_P0.5mm_EP1.6x2.6mm; MPN TPS25940LRVCR
U5: AP63203WU-7 3V3 buck; TSOT-23-6; MPN AP63203WU-7
U8: TLV76033DBZR always-on; SOT-23; MPN TLV76033DBZR

Connections:
+3V3: C10.1, C11.1, L1.2, R43.1, R44.1, U5.1 (FB); also elsewhere on the board
+3V3_AON: C21.1, U8.1 (OUT); also elsewhere on the board
+5V: C8.1, R40.1, U4.4 (OUT), U4.5 (OUT), U4.6 (OUT), U4.7 (OUT), U4.8 (OUT), U5.2 (EN), U5.3 (VIN); also elsewhere on the board
+5V_FUSED: C6.1, C20.1, D2.1 (K), F1.2 (OUT), R36.1, R38.1, U4.9 (IN), U4.10 (IN), U4.11 (IN), U4.12 (IN), U4.13 (IN), U8.2 (IN); also elsewhere on the board
BST: C9.1, U5.6 (BST)
CC_NOT_3A: Q1.1 (G); also elsewhere on the board
EFUSE_EN: Q1.3 (D), R36.2, R37.1, U4.14 (EN_UVLO)
GND: C6.2, C8.2, C10.2, C11.2, C20.2, C21.2, C26.2, D2.2 (A), Q1.2 (S), R35.2, R37.2, R39.2, R41.2, R42.2, U4.1 (DEVSLP), U4.16 (GND), U4.21 (EP), U5.4 (GND), U8.3 (GND); also elsewhere on the board
ILIM: R35.1, U4.17 (ILIM)
IMON: R42.1, U4.19 (IMON); also elsewhere on the board
OVP: R38.2, R39.1, U4.15 (OVP)
PGTH: R40.2, R41.1, U4.3 (PGTH)
POWER_FAULT: R44.2, U4.20 (FLT)
POWER_GOOD: R43.2, U4.2 (PGOOD)
SLEW: C26.1, U4.18 (dVdT)
SW_NODE: C9.2, L1.1, U5.5 (SW)
VBUS: F1.1 (IN); also elsewhere on the board

Notes on the sheet:
DO NOT ORDER - no smoke speedruns. Read the design review.

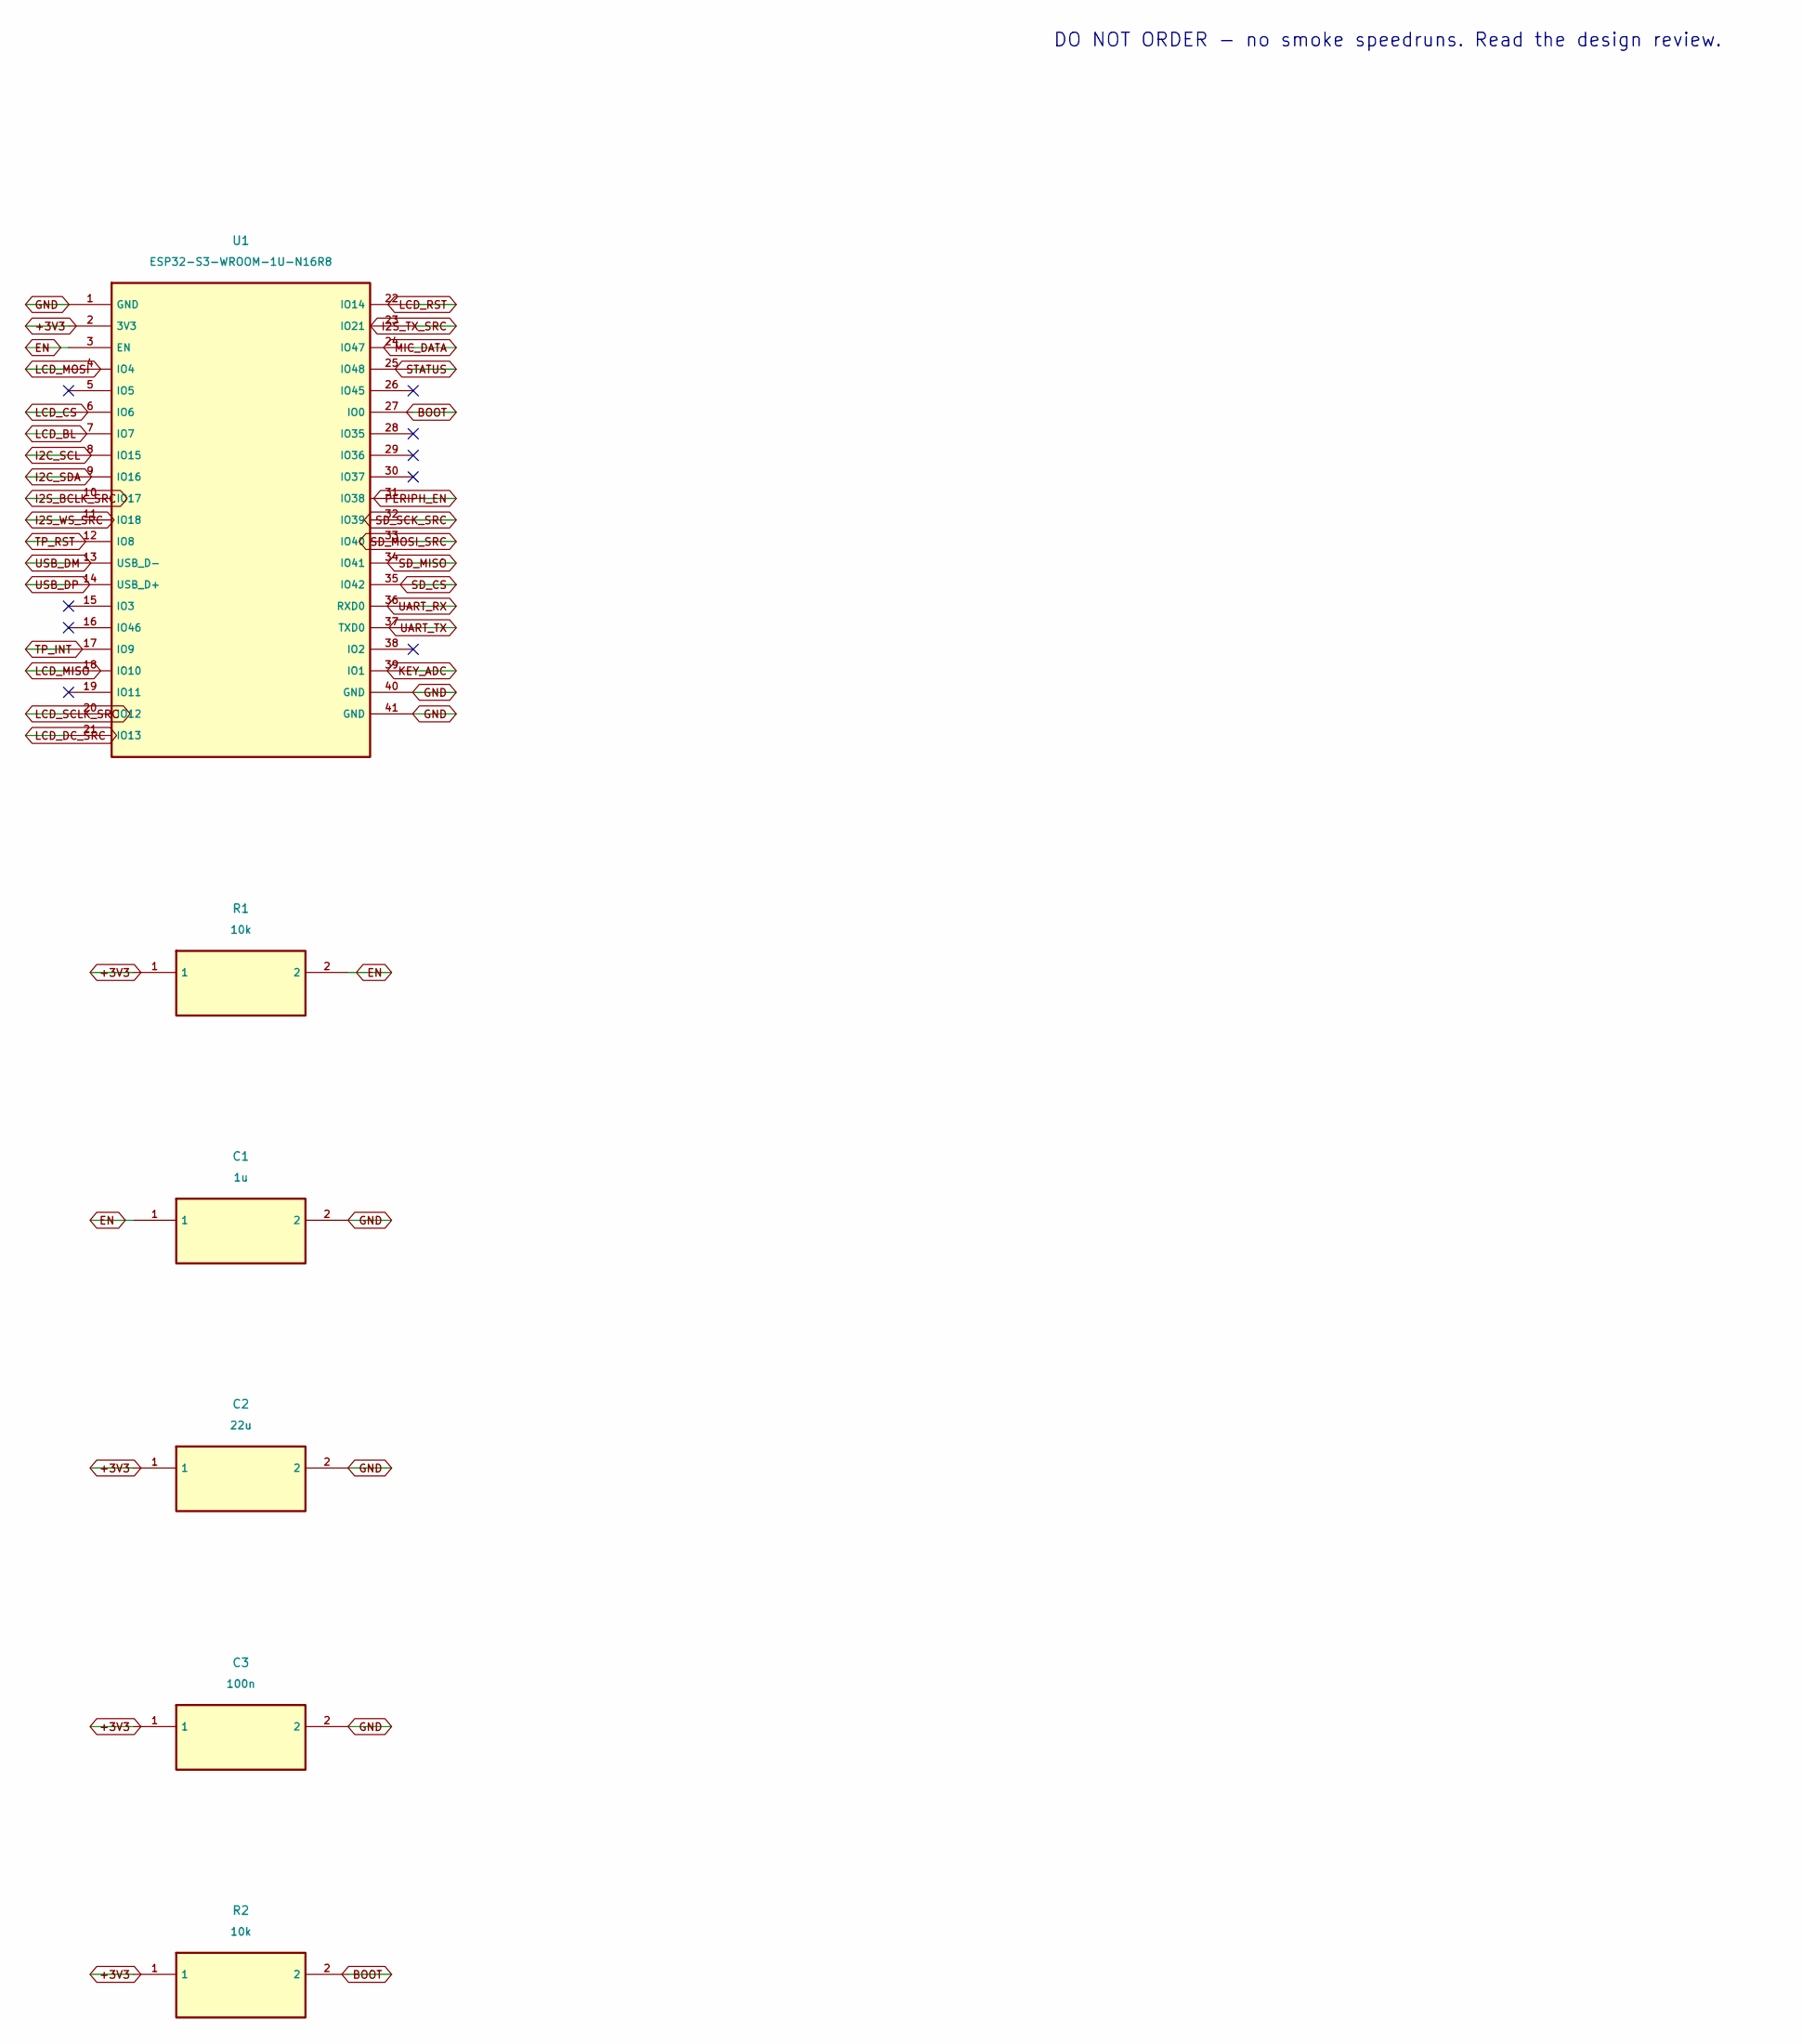
[picture p22: schematic 01_processor.kicad_sch, NEXUS PEAR REV A - 01_processor]

Parts:
C1: 1u; C_0805_2012Metric; MPN GRM21BR71A105KA01L
C2: 22u; C_1206_3216Metric; MPN GRM31CR61A226KE19L
C3: 100n; C_0805_2012Metric; MPN GRM21BR71H104KA01L
R1, R2: 10k; R_0805_2012Metric; MPN RC0805FR-0710KL
U1: ESP32-S3-WROOM-1U-N16R8; ESP32-S3-WROOM-1U; MPN ESP32-S3-WROOM-1U-N16R8

Connections:
+3V3: C2.1, C3.1, R1.1, R2.1, U1.2 (3V3); also elsewhere on the board
BOOT: R2.2, U1.27 (IO0); also elsewhere on the board
EN: C1.1, R1.2, U1.3 (EN); also elsewhere on the board
GND: C1.2, C2.2, C3.2, U1.1 (GND), U1.40 (GND), U1.41 (GND); also elsewhere on the board
I2C_SCL: U1.8 (IO15); also elsewhere on the board
I2C_SDA: U1.9 (IO16); also elsewhere on the board
I2S_BCLK_SRC: U1.10 (IO17); also elsewhere on the board
I2S_TX_SRC: U1.23 (IO21); also elsewhere on the board
I2S_WS_SRC: U1.11 (IO18); also elsewhere on the board
KEY_ADC: U1.39 (IO1); also elsewhere on the board
LCD_BL: U1.7 (IO7); also elsewhere on the board
LCD_CS: U1.6 (IO6); also elsewhere on the board
LCD_DC_SRC: U1.21 (IO13); also elsewhere on the board
LCD_MISO: U1.18 (IO10); also elsewhere on the board
LCD_MOSI: U1.4 (IO4); also elsewhere on the board
LCD_RST: U1.22 (IO14); also elsewhere on the board
LCD_SCLK_SRC: U1.20 (IO12); also elsewhere on the board
MIC_DATA: U1.24 (IO47); also elsewhere on the board
PERIPH_EN: U1.31 (IO38); also elsewhere on the board
SD_CS: U1.35 (IO42); also elsewhere on the board
SD_MISO: U1.34 (IO41); also elsewhere on the board
SD_MOSI_SRC: U1.33 (IO40); also elsewhere on the board
SD_SCK_SRC: U1.32 (IO39); also elsewhere on the board
STATUS: U1.25 (IO48); also elsewhere on the board
TP_INT: U1.17 (IO9); also elsewhere on the board
TP_RST: U1.12 (IO8); also elsewhere on the board
UART_RX: U1.36 (RXD0); also elsewhere on the board
UART_TX: U1.37 (TXD0); also elsewhere on the board
USB_DM: U1.13 (USB_D-); also elsewhere on the board
USB_DP: U1.14 (USB_D+); also elsewhere on the board

Notes on the sheet:
DO NOT ORDER - no smoke speedruns. Read the design review.

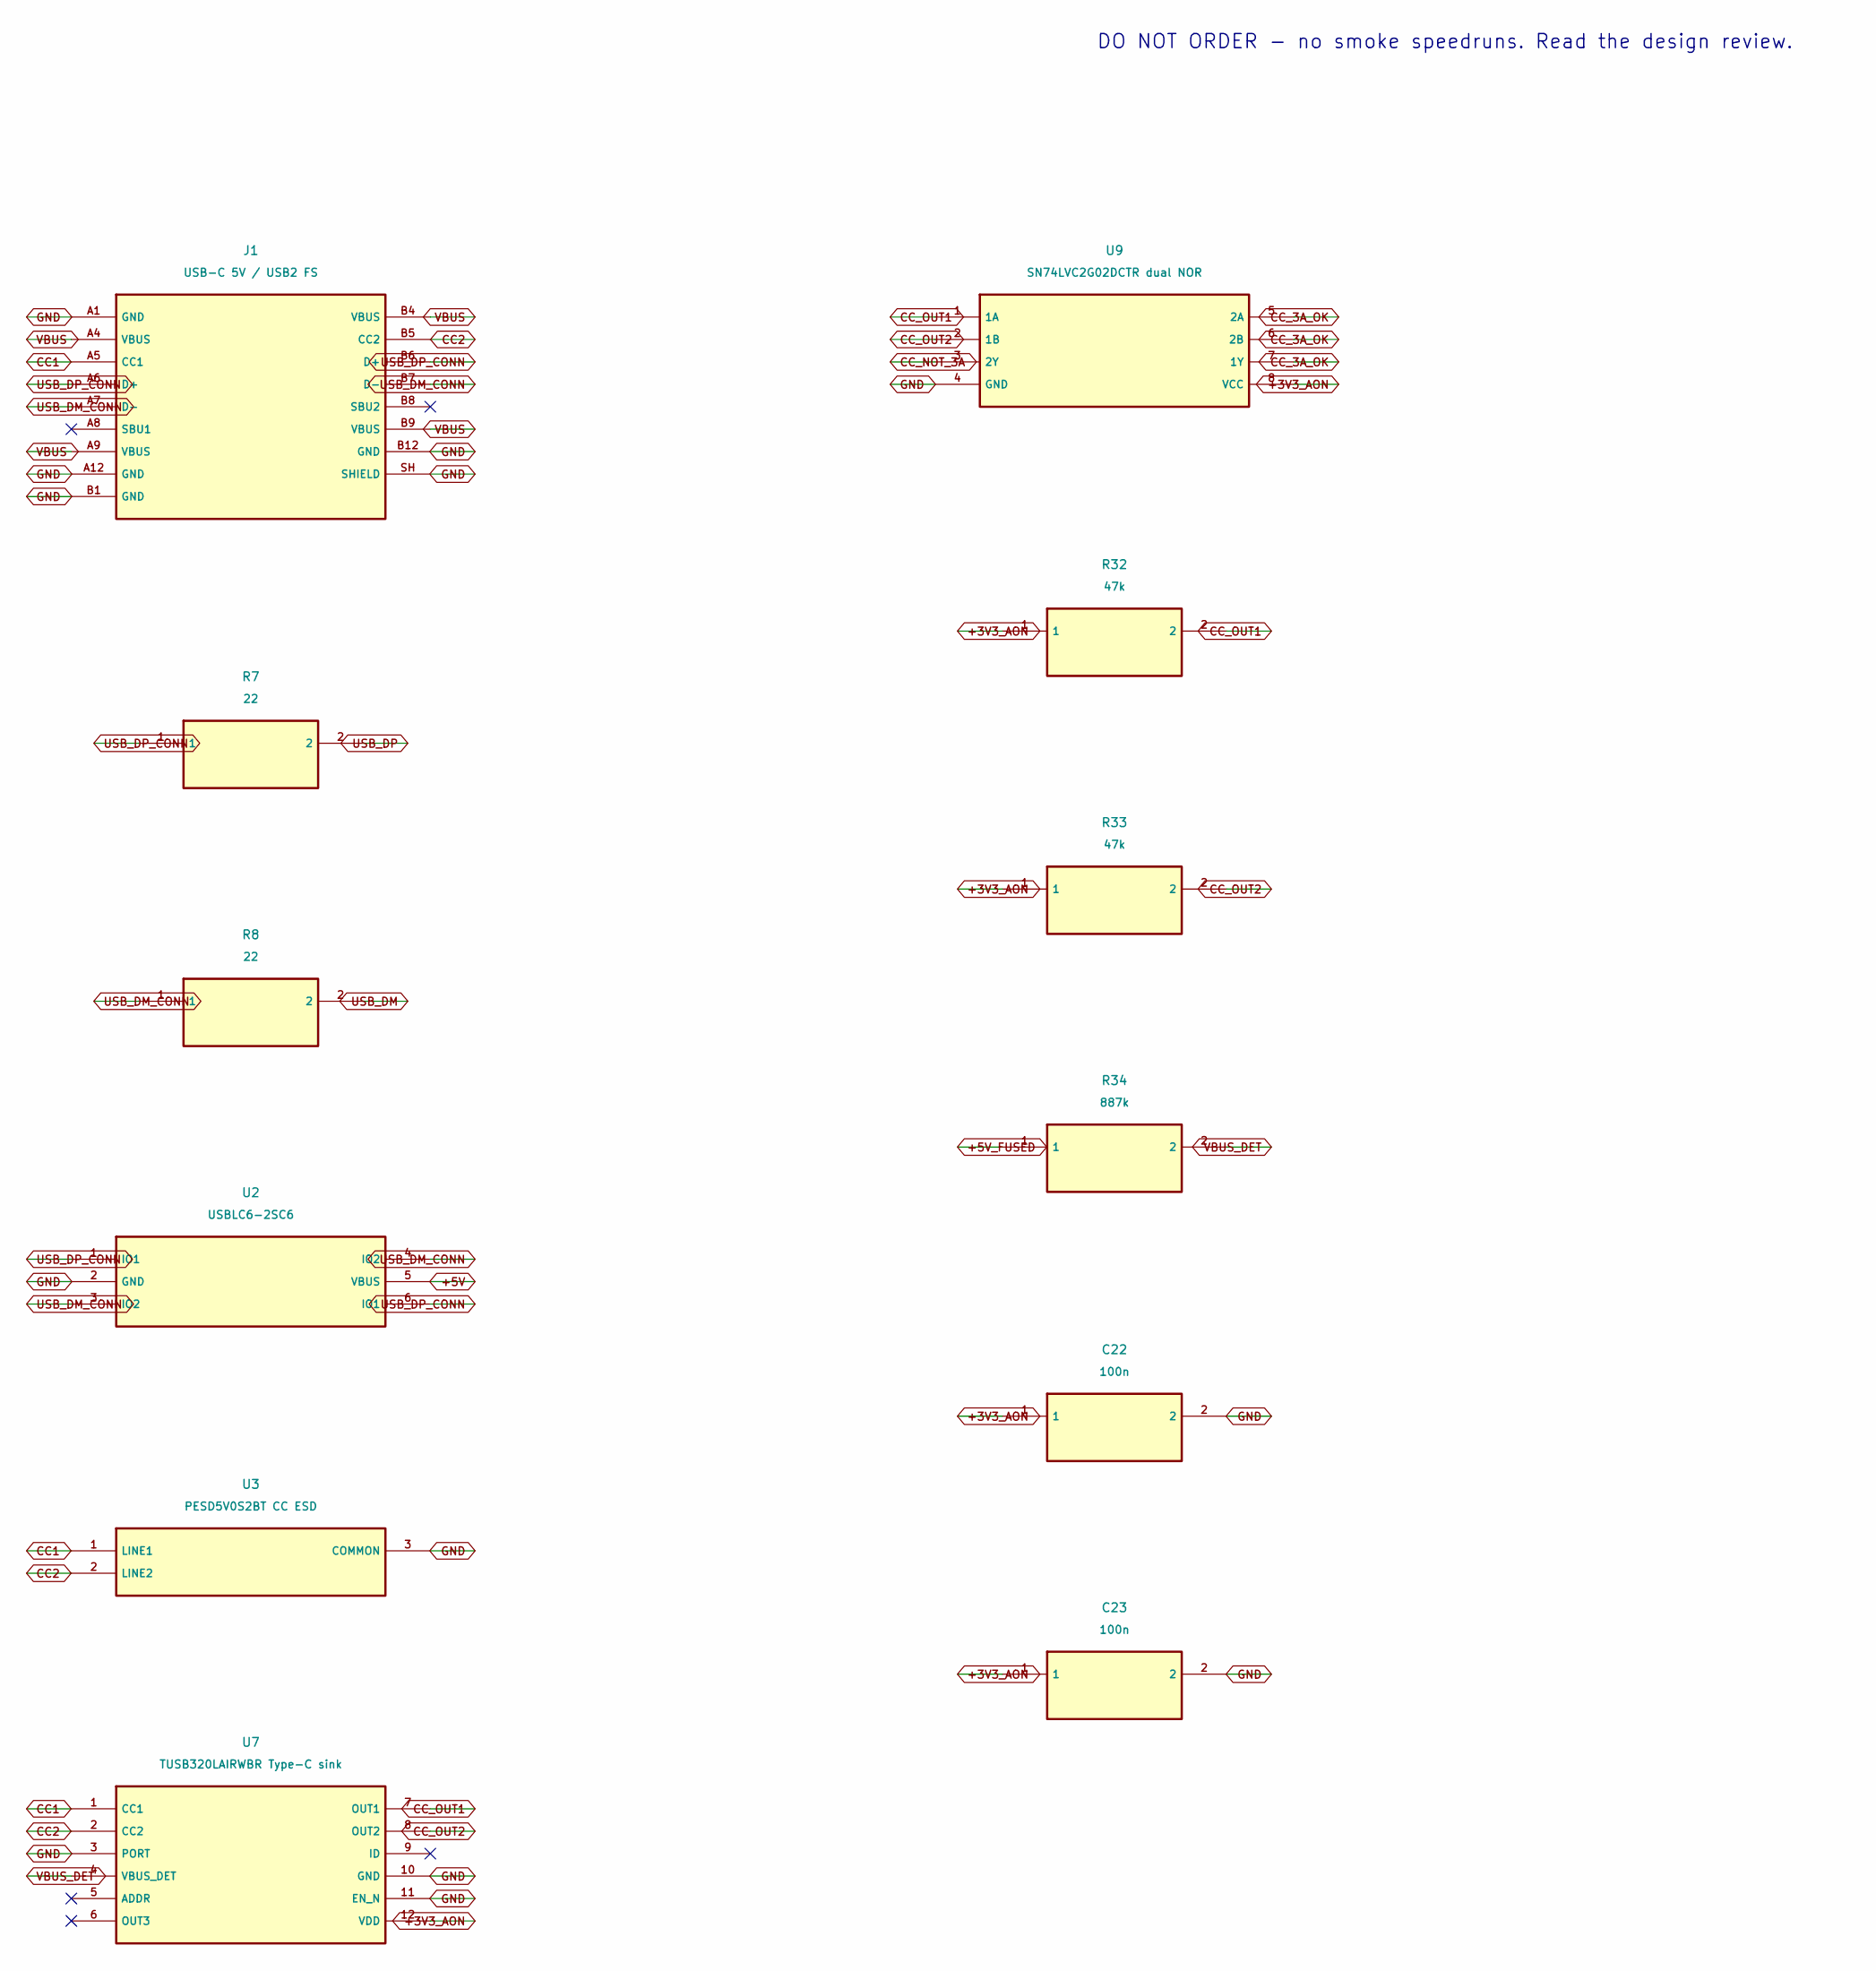
[picture p23: schematic 02_usb.kicad_sch, NEXUS PEAR REV A - 02_usb]

Parts:
C22, C23: 100n; C_0805_2012Metric; MPN GRM21BR71H104KA01L
J1: USB-C 5V / USB2 FS; USB_C_Receptacle_GCT_USB4105-xx-A_16P_TopMnt_Horizontal; MPN USB4105-GF-A
R7, R8: 22; R_0805_2012Metric; MPN RC0805FR-0722RL
R32, R33: 47k; R_0805_2012Metric; MPN RC0805FR-0747KL
R34: 887k; R_0805_2012Metric; MPN RC0805FR-07887KL
U2: USBLC6-2SC6; SOT-23-6; MPN USBLC6-2SC6
U3: PESD5V0S2BT CC ESD; SOT-23; MPN PESD5V0S2BT,215
U7: TUSB320LAIRWBR Type-C sink; Texas_X2QFN-12_1.6x1.6mm_P0.4mm; MPN TUSB320LAIRWBR
U9: SN74LVC2G02DCTR dual NOR; SSOP-8_2.95x2.8mm_P0.65mm; MPN SN74LVC2G02DCTR

Connections:
+3V3_AON: C22.1, C23.1, R32.1, R33.1, U7.12 (VDD), U9.8 (VCC); also elsewhere on the board
+5V: U2.5 (VBUS); also elsewhere on the board
+5V_FUSED: R34.1; also elsewhere on the board
CC1: J1.A5 (CC1), U3.1 (LINE1), U7.1 (CC1)
CC2: J1.B5 (CC2), U3.2 (LINE2), U7.2 (CC2)
CC_3A_OK: U9.5 (2A), U9.6 (2B), U9.7 (1Y); also elsewhere on the board
CC_NOT_3A: U9.3 (2Y); also elsewhere on the board
CC_OUT1: R32.2, U7.7 (OUT1), U9.1 (1A)
CC_OUT2: R33.2, U7.8 (OUT2), U9.2 (1B)
GND: C22.2, C23.2, J1.A1 (GND), J1.A12 (GND), J1.B1 (GND), J1.B12 (GND), J1.SH (SHIELD), U2.2 (GND), U3.3 (COMMON), U7.3 (PORT), U7.10 (GND), U7.11 (EN_N), U9.4 (GND); also elsewhere on the board
USB_DM: R8.2; also elsewhere on the board
USB_DM_CONN: J1.A7 (D-), J1.B7 (D-), R8.1, U2.3 (IO2), U2.4 (IO2)
USB_DP: R7.2; also elsewhere on the board
USB_DP_CONN: J1.A6 (D+), J1.B6 (D+), R7.1, U2.1 (IO1), U2.6 (IO1)
VBUS: J1.A4 (VBUS), J1.A9 (VBUS), J1.B4 (VBUS), J1.B9 (VBUS); also elsewhere on the board
VBUS_DET: R34.2, U7.4 (VBUS_DET)

Notes on the sheet:
DO NOT ORDER - no smoke speedruns. Read the design review.
