aminewe898/nexus-pear-reva/hardware/kicad/nexus-pear-reva/nexus-pear-reva.kicad_pcb

## KiCad design hardware/kicad/nexus-pear-reva/nexus-pear-reva.kicad_pcb (continued)

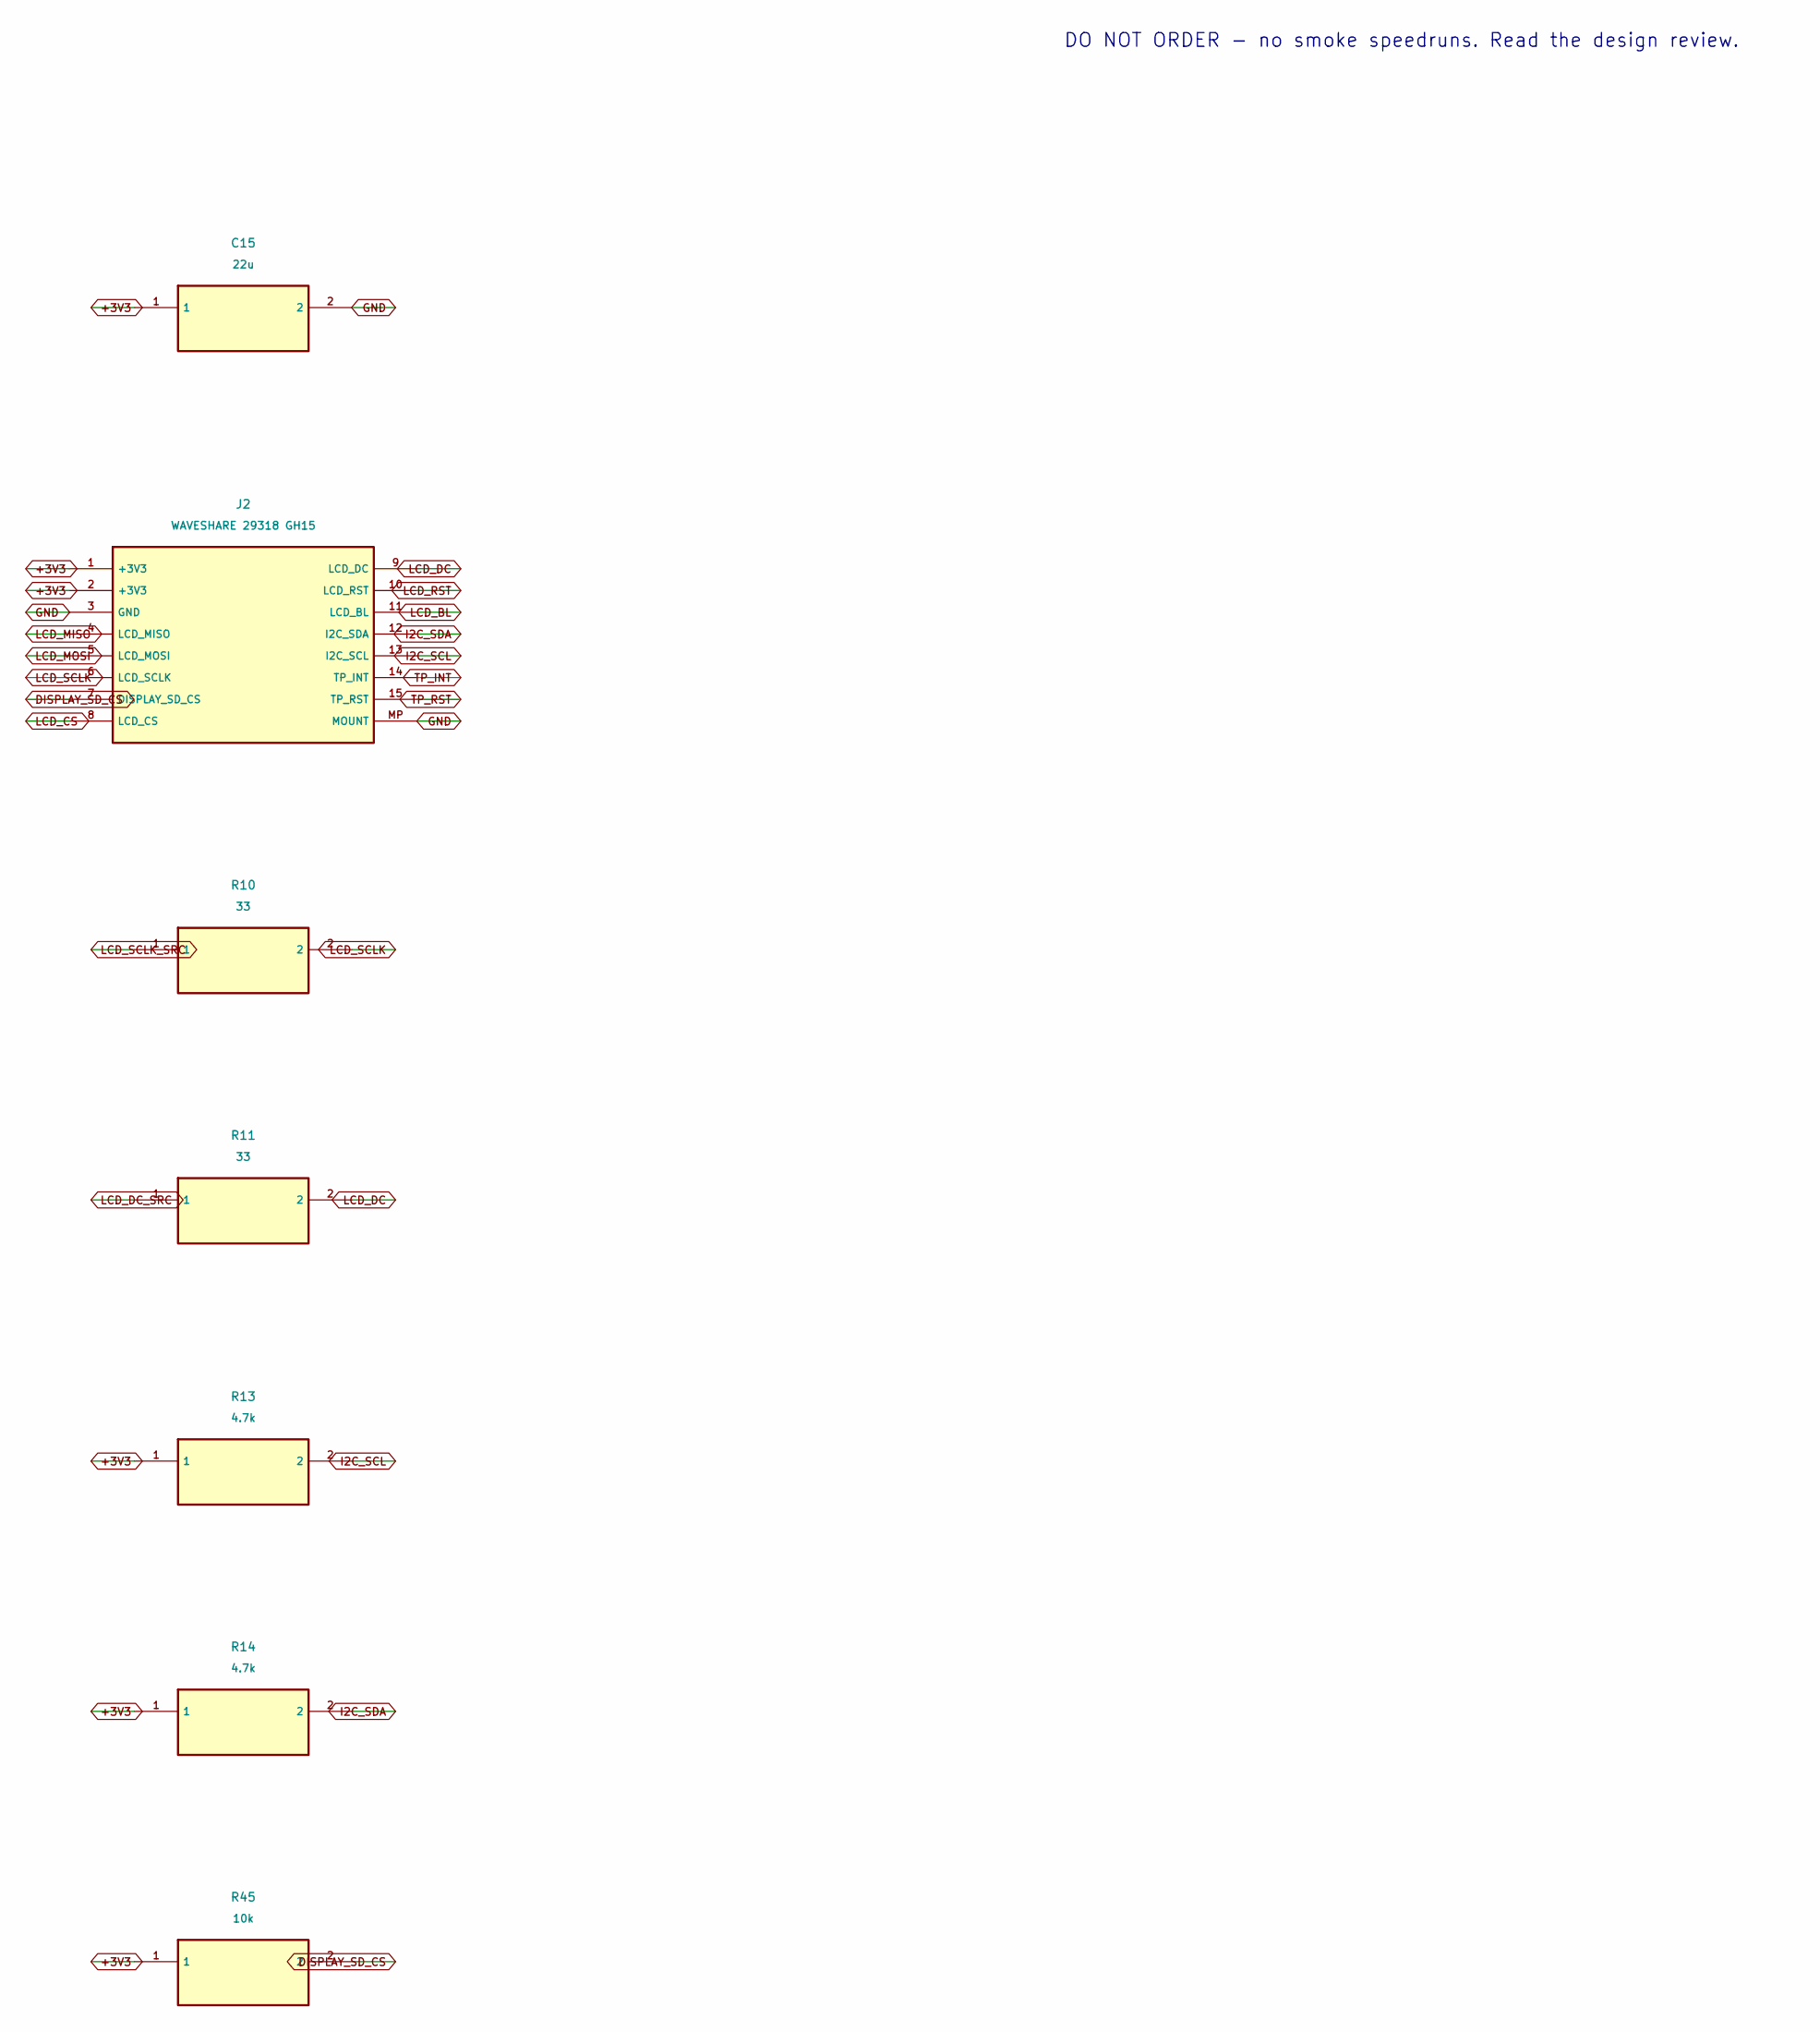
[picture p24: schematic 03_display.kicad_sch, NEXUS PEAR REV A - 03_display]

Parts:
C15: 22u; C_1206_3216Metric; MPN GRM31CR61A226KE19L
J2: WAVESHARE 29318 GH15; JST_GH_SM15B-GHS-TB_1x15-1MP_P1.25mm_Horizontal; MPN SM15B-GHS-TB(LF)(SN)
R10, R11: 33; R_0805_2012Metric; MPN RC0805FR-0733RL
R13, R14: 4.7k; R_0805_2012Metric; MPN RC0805FR-074K7L
R45: 10k; R_0805_2012Metric; MPN RC0805FR-0710KL

Connections:
+3V3: C15.1, J2.1 (+3V3), J2.2 (+3V3), R13.1, R14.1, R45.1; also elsewhere on the board
DISPLAY_SD_CS: J2.7 (DISPLAY_SD_CS), R45.2
GND: C15.2, J2.3 (GND), J2.MP (MOUNT); also elsewhere on the board
I2C_SCL: J2.13 (I2C_SCL), R13.2; also elsewhere on the board
I2C_SDA: J2.12 (I2C_SDA), R14.2; also elsewhere on the board
LCD_BL: J2.11 (LCD_BL); also elsewhere on the board
LCD_CS: J2.8 (LCD_CS); also elsewhere on the board
LCD_DC: J2.9 (LCD_DC), R11.2
LCD_DC_SRC: R11.1; also elsewhere on the board
LCD_MISO: J2.4 (LCD_MISO); also elsewhere on the board
LCD_MOSI: J2.5 (LCD_MOSI); also elsewhere on the board
LCD_RST: J2.10 (LCD_RST); also elsewhere on the board
LCD_SCLK: J2.6 (LCD_SCLK), R10.2
LCD_SCLK_SRC: R10.1; also elsewhere on the board
TP_INT: J2.14 (TP_INT); also elsewhere on the board
TP_RST: J2.15 (TP_RST); also elsewhere on the board

Notes on the sheet:
DO NOT ORDER - no smoke speedruns. Read the design review.

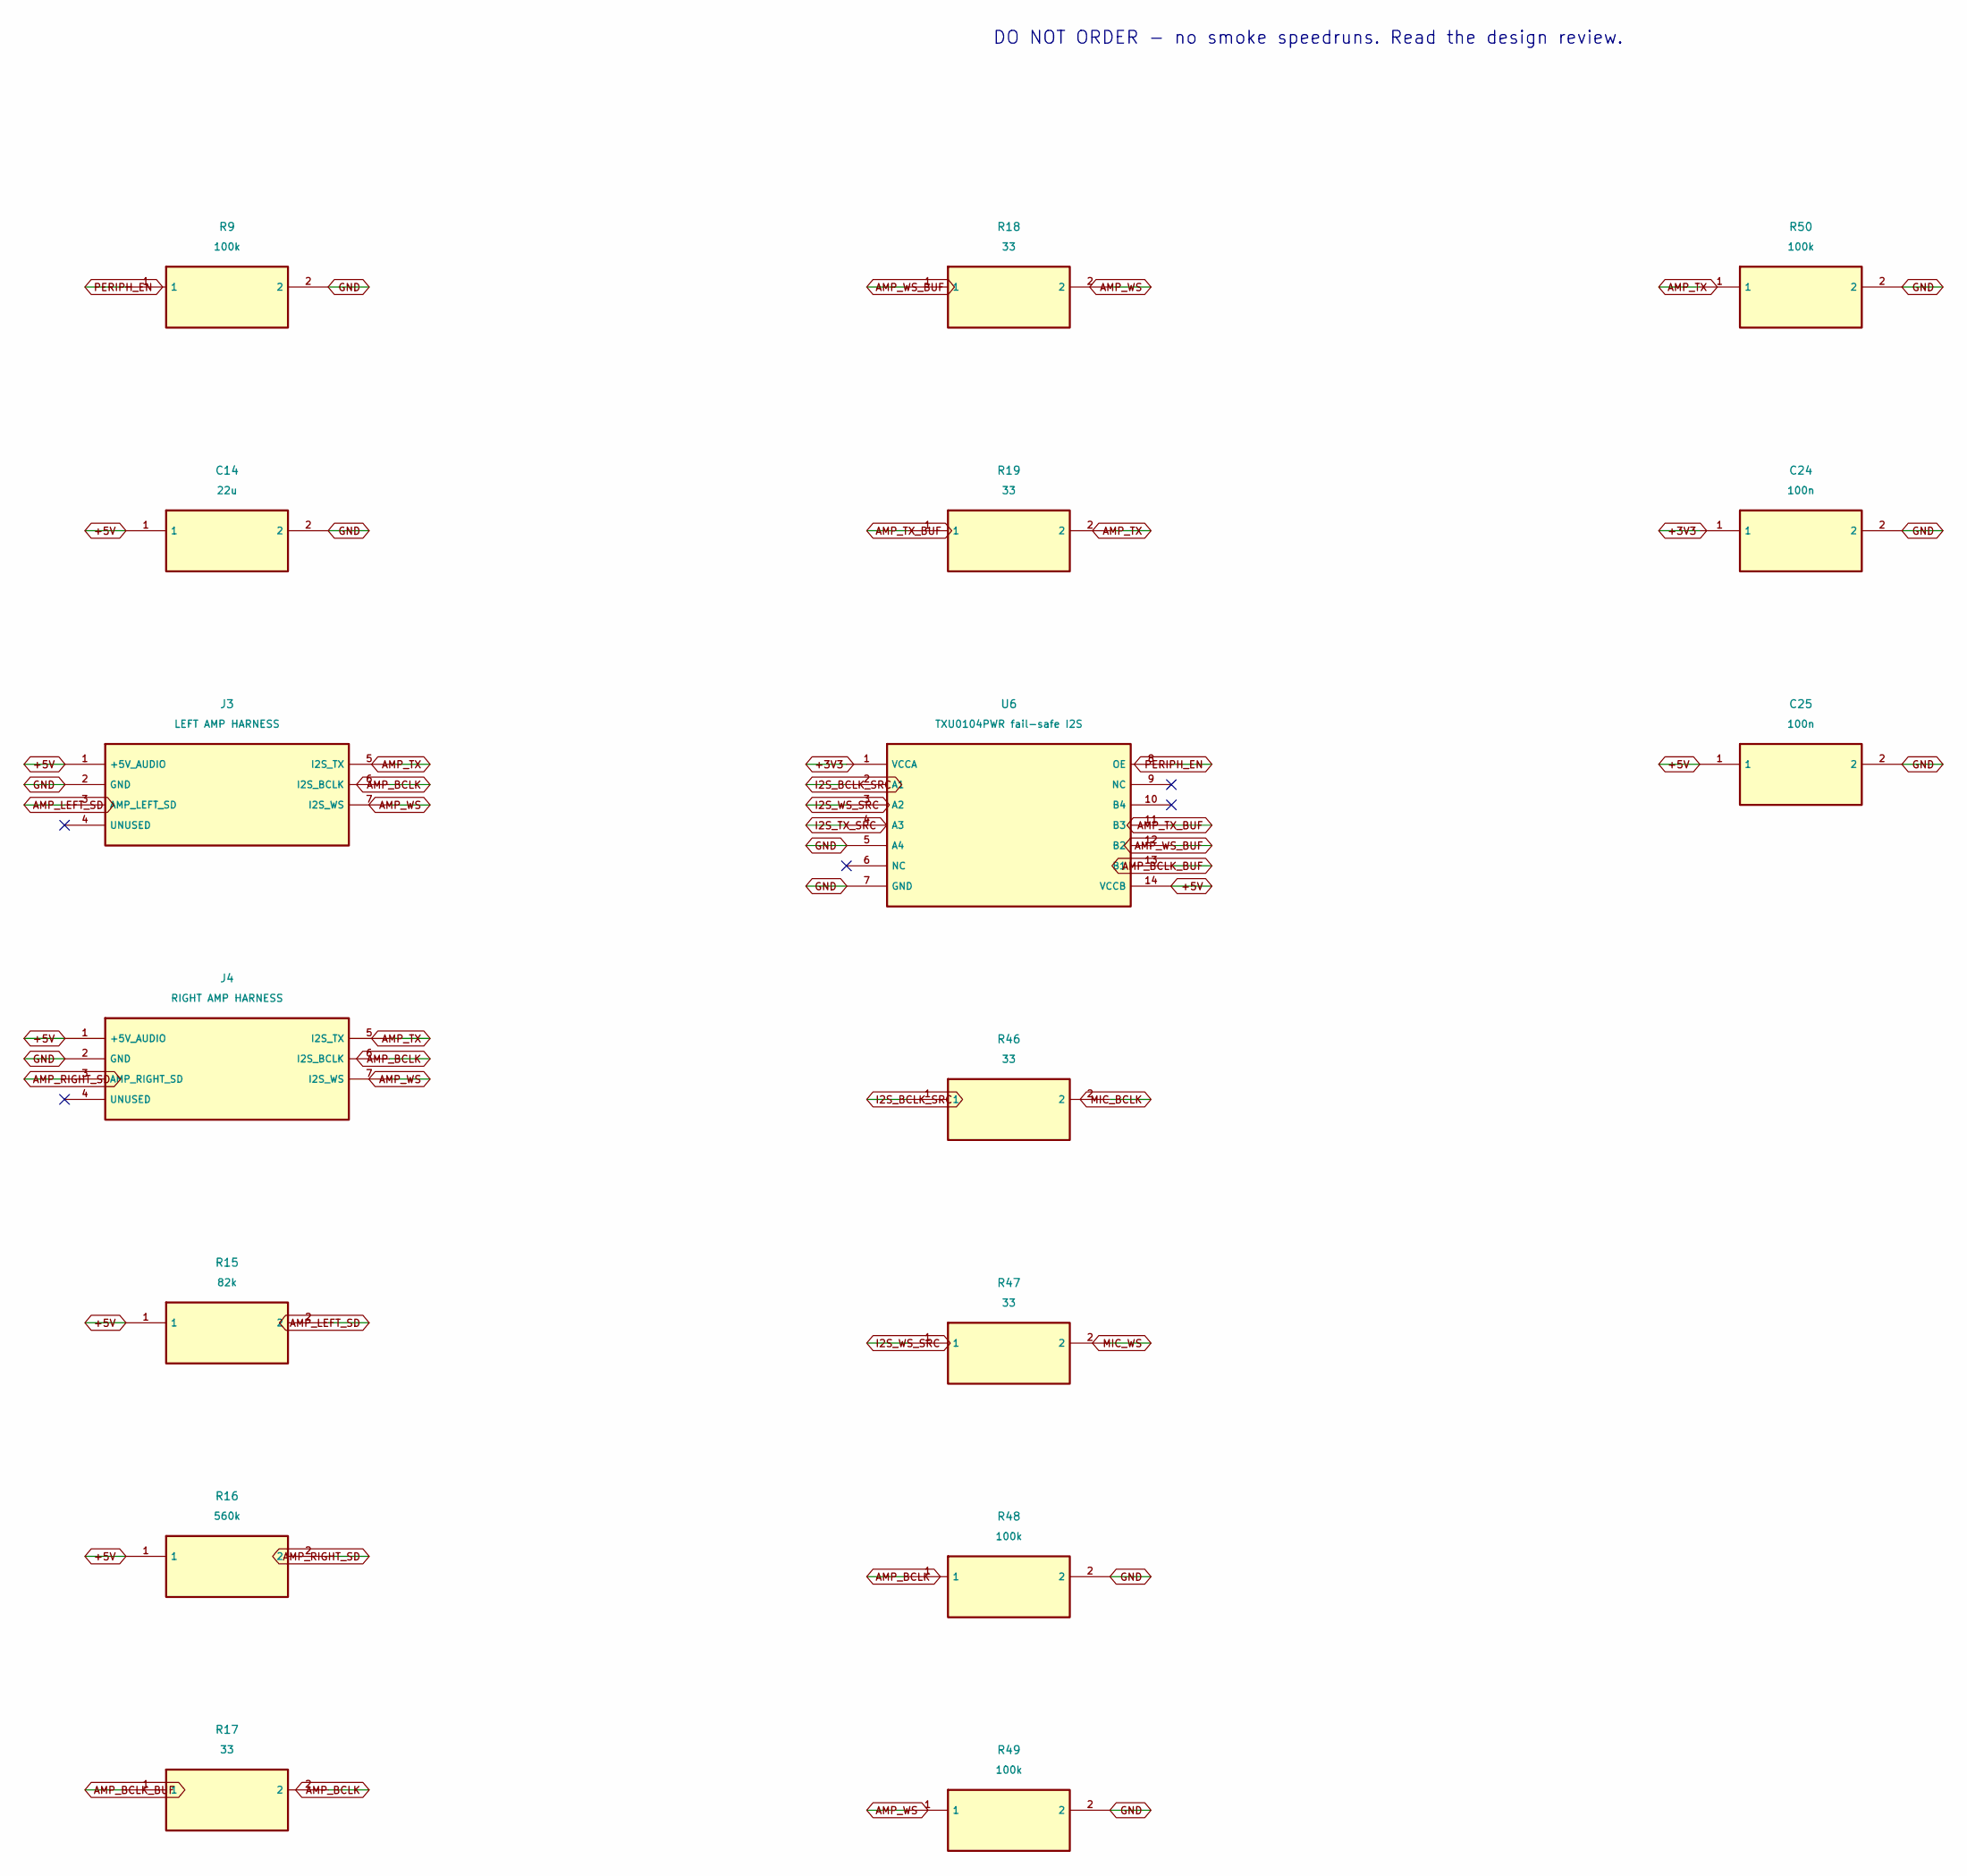
[picture p25: schematic 04_audio.kicad_sch, NEXUS PEAR REV A - 04_audio]

Parts:
C14: 22u; C_1206_3216Metric; MPN GRM31CR61A226KE19L
C24, C25: 100n; C_0805_2012Metric; MPN GRM21BR71H104KA01L
J3: LEFT AMP HARNESS; PinHeader_1x07_P2.54mm_Vertical; MPN TSW-007-07-G-S
J4: RIGHT AMP HARNESS; PinHeader_1x07_P2.54mm_Vertical; MPN TSW-007-07-G-S
R9, R48, R49, R50: 100k; R_0805_2012Metric; MPN RC0805FR-07100KL
R15: 82k; R_0805_2012Metric; MPN RC0805FR-0782KL
R16: 560k; R_0805_2012Metric; MPN RC0805FR-07560KL
R17, R18, R19, R46, R47: 33; R_0805_2012Metric; MPN RC0805FR-0733RL
U6: TXU0104PWR fail-safe I2S; TSSOP-14_4.4x5mm_P0.65mm; MPN TXU0104PWR

Connections:
+3V3: C24.1, U6.1 (VCCA); also elsewhere on the board
+5V: C14.1, C25.1, J3.1 (+5V_AUDIO), J4.1 (+5V_AUDIO), R15.1, R16.1, U6.14 (VCCB); also elsewhere on the board
AMP_BCLK: J3.6 (I2S_BCLK), J4.6 (I2S_BCLK), R17.2, R48.1
AMP_BCLK_BUF: R17.1, U6.13 (B1)
AMP_LEFT_SD: J3.3 (AMP_LEFT_SD), R15.2
AMP_RIGHT_SD: J4.3 (AMP_RIGHT_SD), R16.2
AMP_TX: J3.5 (I2S_TX), J4.5 (I2S_TX), R19.2, R50.1
AMP_TX_BUF: R19.1, U6.11 (B3)
AMP_WS: J3.7 (I2S_WS), J4.7 (I2S_WS), R18.2, R49.1
AMP_WS_BUF: R18.1, U6.12 (B2)
GND: C14.2, C24.2, C25.2, J3.2 (GND), J4.2 (GND), R9.2, R48.2, R49.2, R50.2, U6.5 (A4), U6.7 (GND); also elsewhere on the board
I2S_BCLK_SRC: R46.1, U6.2 (A1); also elsewhere on the board
I2S_TX_SRC: U6.4 (A3); also elsewhere on the board
I2S_WS_SRC: R47.1, U6.3 (A2); also elsewhere on the board
MIC_BCLK: R46.2; also elsewhere on the board
MIC_WS: R47.2; also elsewhere on the board
PERIPH_EN: R9.1, U6.8 (OE); also elsewhere on the board

Notes on the sheet:
DO NOT ORDER - no smoke speedruns. Read the design review.

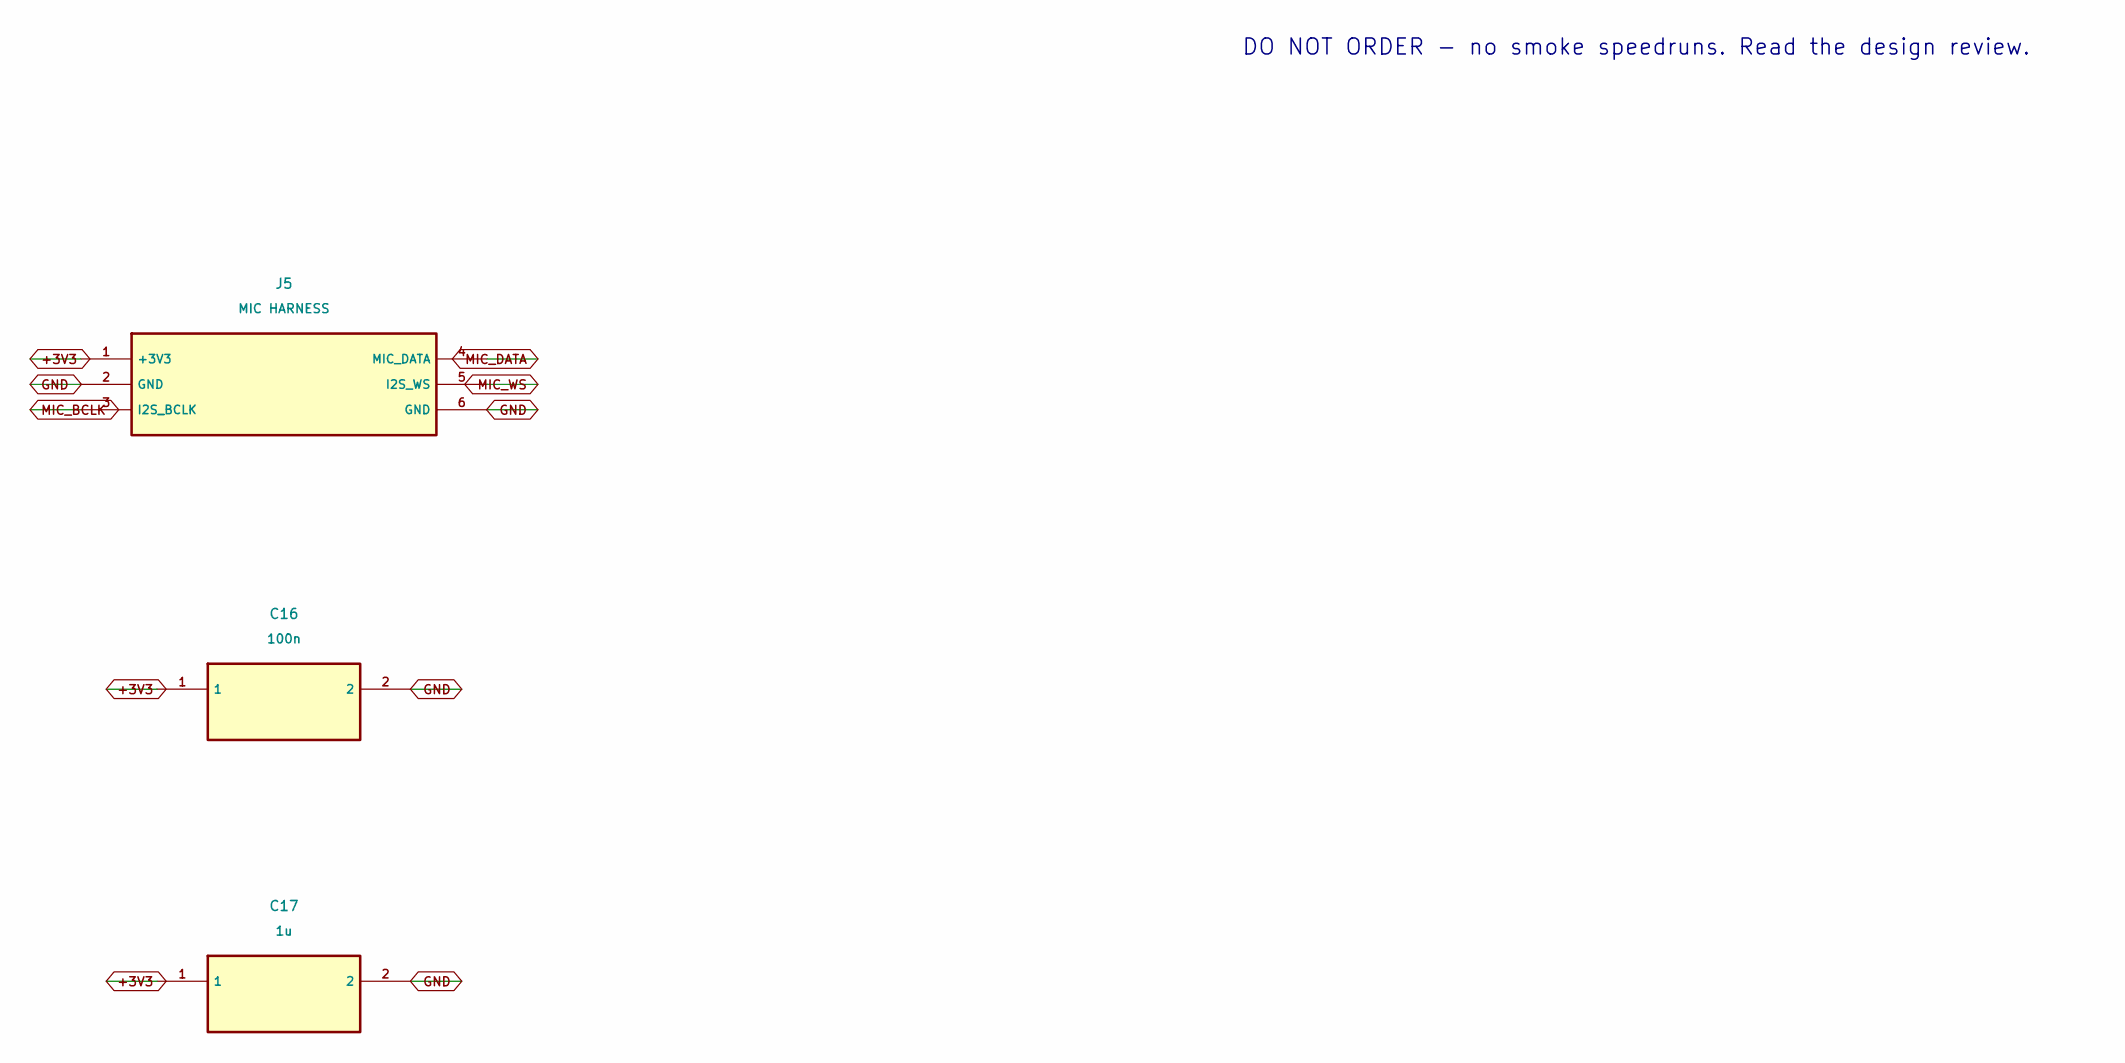
[picture p26: schematic 05_microphone.kicad_sch, NEXUS PEAR REV A - 05_microphone]

Parts:
C16: 100n; C_0805_2012Metric; MPN GRM21BR71H104KA01L
C17: 1u; C_0805_2012Metric; MPN GRM21BR71A105KA01L
J5: MIC HARNESS; PinHeader_1x06_P2.54mm_Vertical; MPN TSW-006-07-G-S

Connections:
+3V3: C16.1, C17.1, J5.1 (+3V3); also elsewhere on the board
GND: C16.2, C17.2, J5.2 (GND), J5.6 (GND); also elsewhere on the board
MIC_BCLK: J5.3 (I2S_BCLK); also elsewhere on the board
MIC_DATA: J5.4 (MIC_DATA); also elsewhere on the board
MIC_WS: J5.5 (I2S_WS); also elsewhere on the board

Notes on the sheet:
DO NOT ORDER - no smoke speedruns. Read the design review.

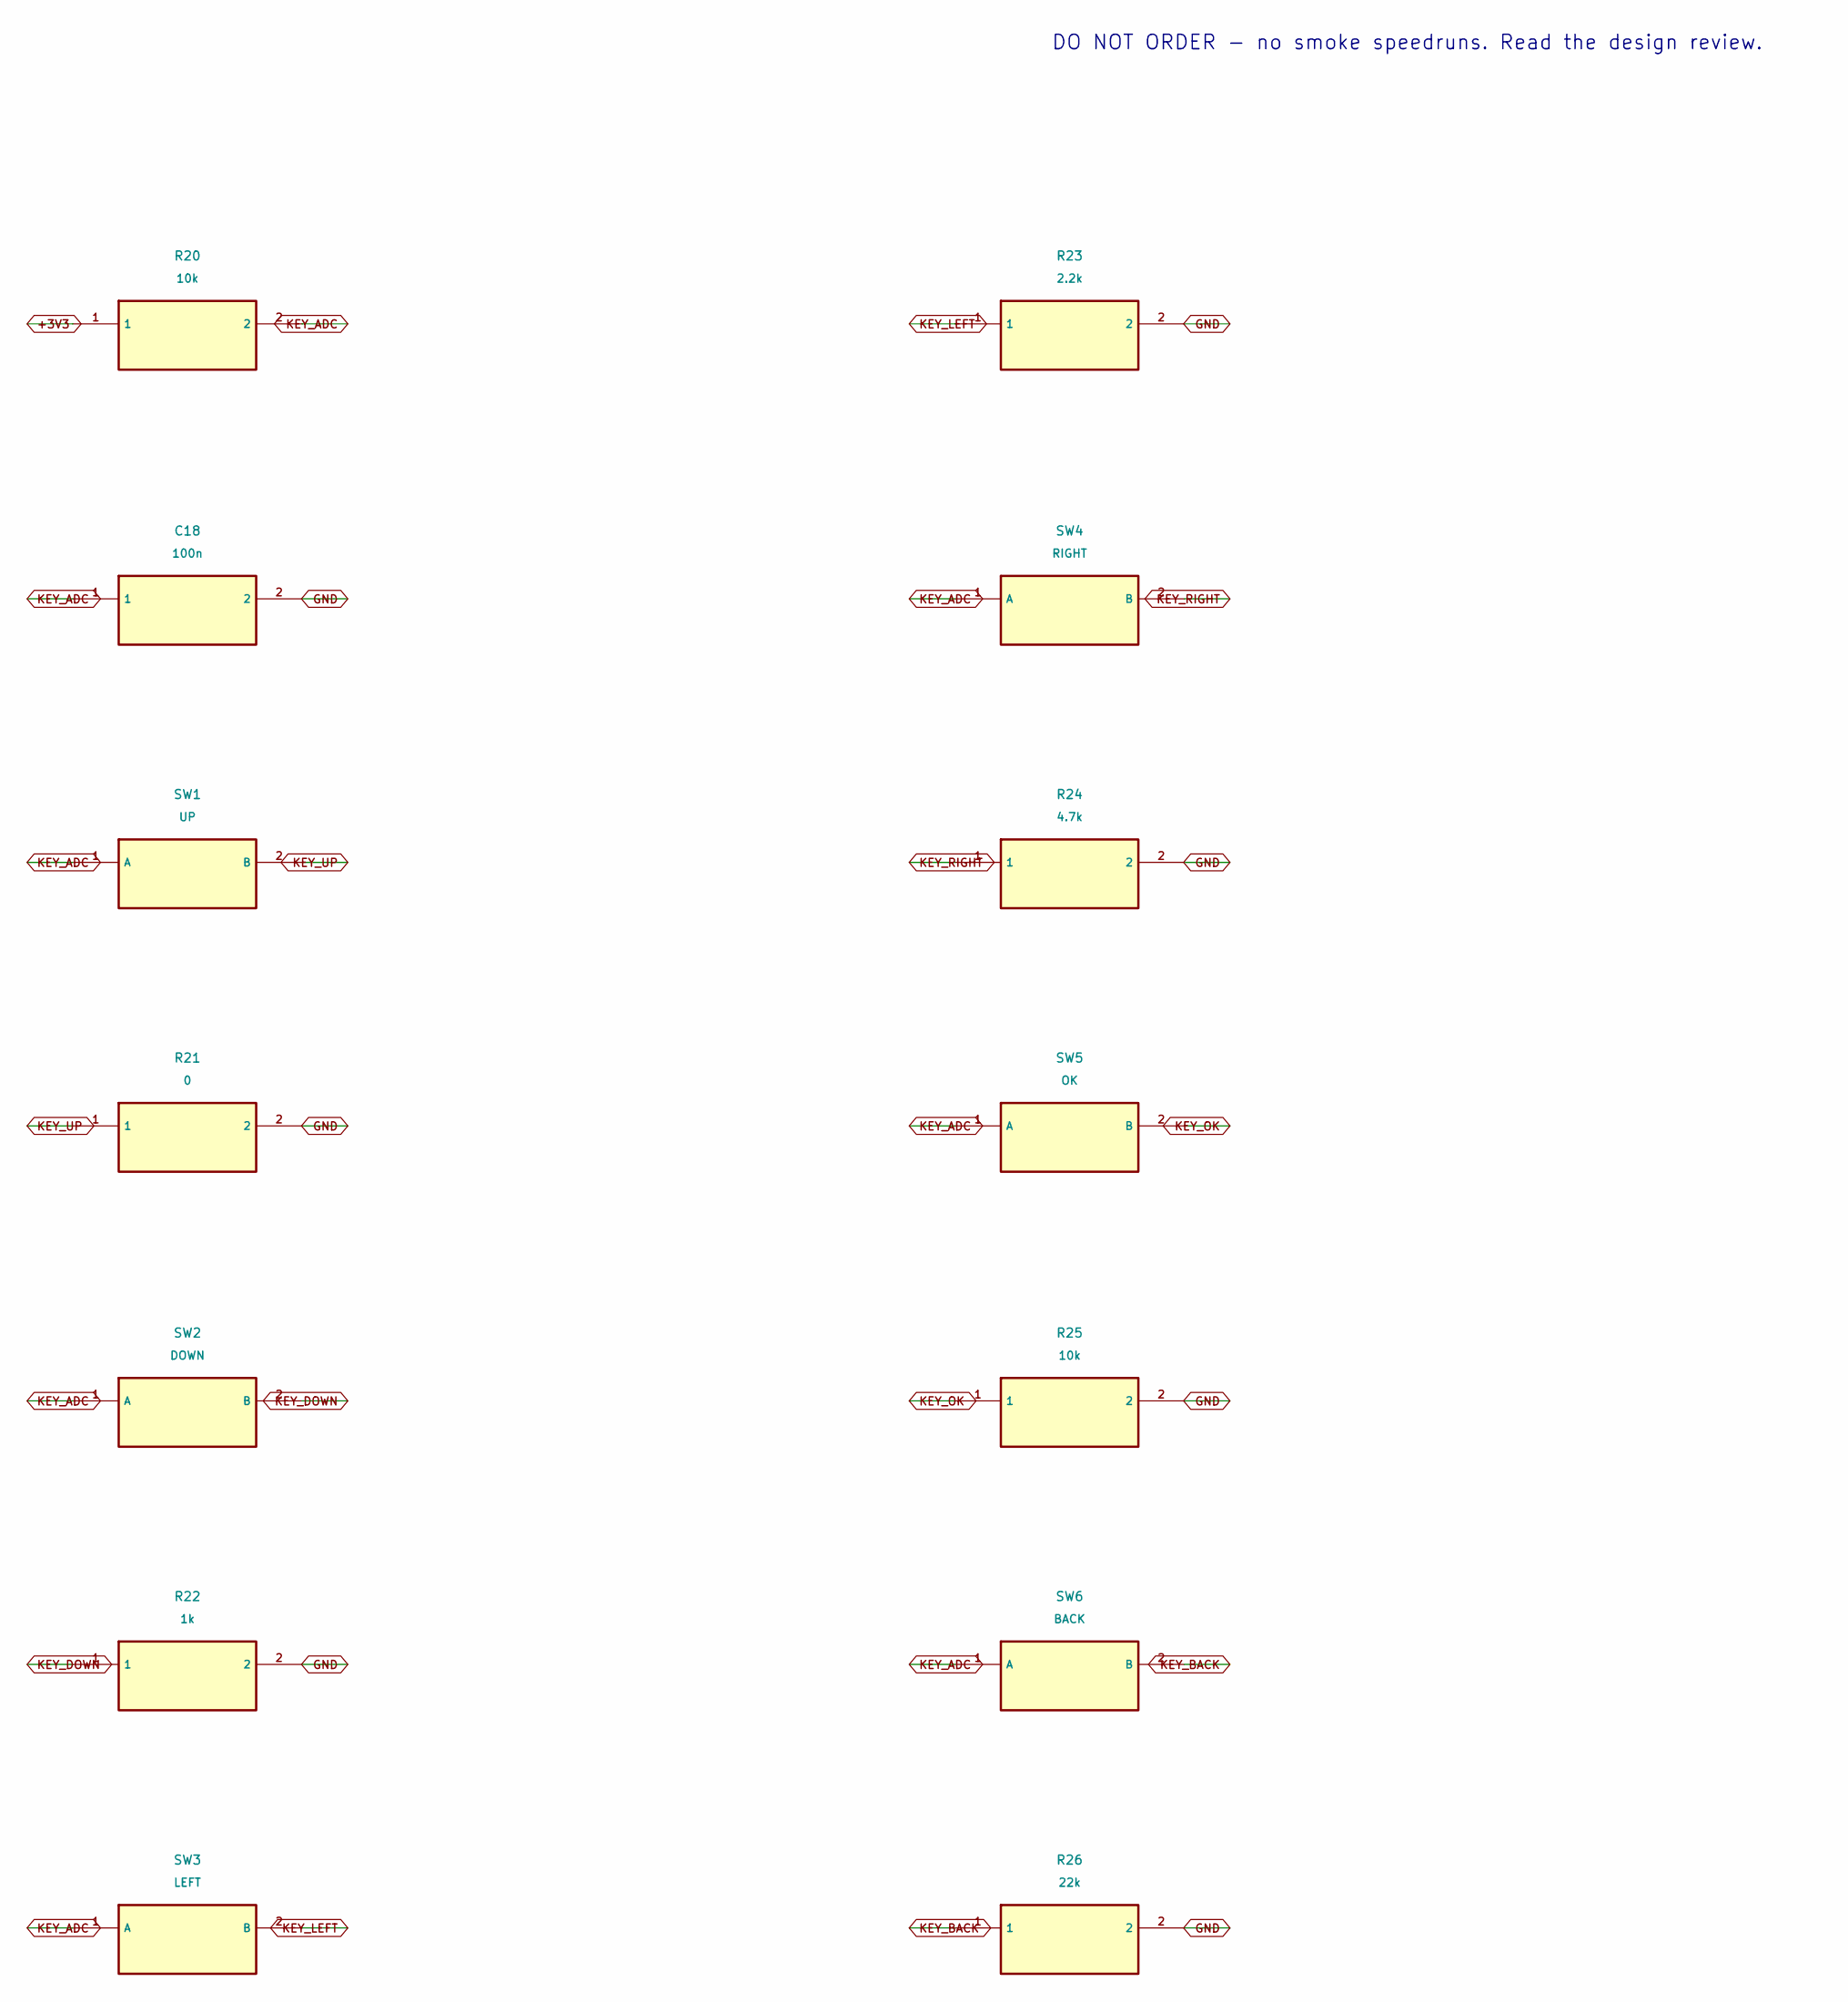
[picture p27: schematic 06_buttons.kicad_sch, NEXUS PEAR REV A - 06_buttons]

Parts:
C18: 100n; C_0805_2012Metric; MPN GRM21BR71H104KA01L
R20, R25: 10k; R_0805_2012Metric; MPN RC0805FR-0710KL
R21: 0; R_0805_2012Metric; MPN RC0805JR-070RL
R22: 1k; R_0805_2012Metric; MPN RC0805FR-071KL
R23: 2.2k; R_0805_2012Metric; MPN RC0805FR-072K2L
R24: 4.7k; R_0805_2012Metric; MPN RC0805FR-074K7L
R26: 22k; R_0805_2012Metric; MPN RC0805FR-0722KL
SW1: UP; SW_PUSH_6mm; MPN B3F-1000
SW2: DOWN; SW_PUSH_6mm; MPN B3F-1000
SW3: LEFT; SW_PUSH_6mm; MPN B3F-1000
SW4: RIGHT; SW_PUSH_6mm; MPN B3F-1000
SW5: OK; SW_PUSH_6mm; MPN B3F-1000
SW6: BACK; SW_PUSH_6mm; MPN B3F-1000

Connections:
+3V3: R20.1; also elsewhere on the board
GND: C18.2, R21.2, R22.2, R23.2, R24.2, R25.2, R26.2; also elsewhere on the board
KEY_ADC: C18.1, R20.2, SW1.1 (A), SW2.1 (A), SW3.1 (A), SW4.1 (A), SW5.1 (A), SW6.1 (A); also elsewhere on the board
KEY_BACK: R26.1, SW6.2 (B)
KEY_DOWN: R22.1, SW2.2 (B)
KEY_LEFT: R23.1, SW3.2 (B)
KEY_OK: R25.1, SW5.2 (B)
KEY_RIGHT: R24.1, SW4.2 (B)
KEY_UP: R21.1, SW1.2 (B)

Notes on the sheet:
DO NOT ORDER - no smoke speedruns. Read the design review.

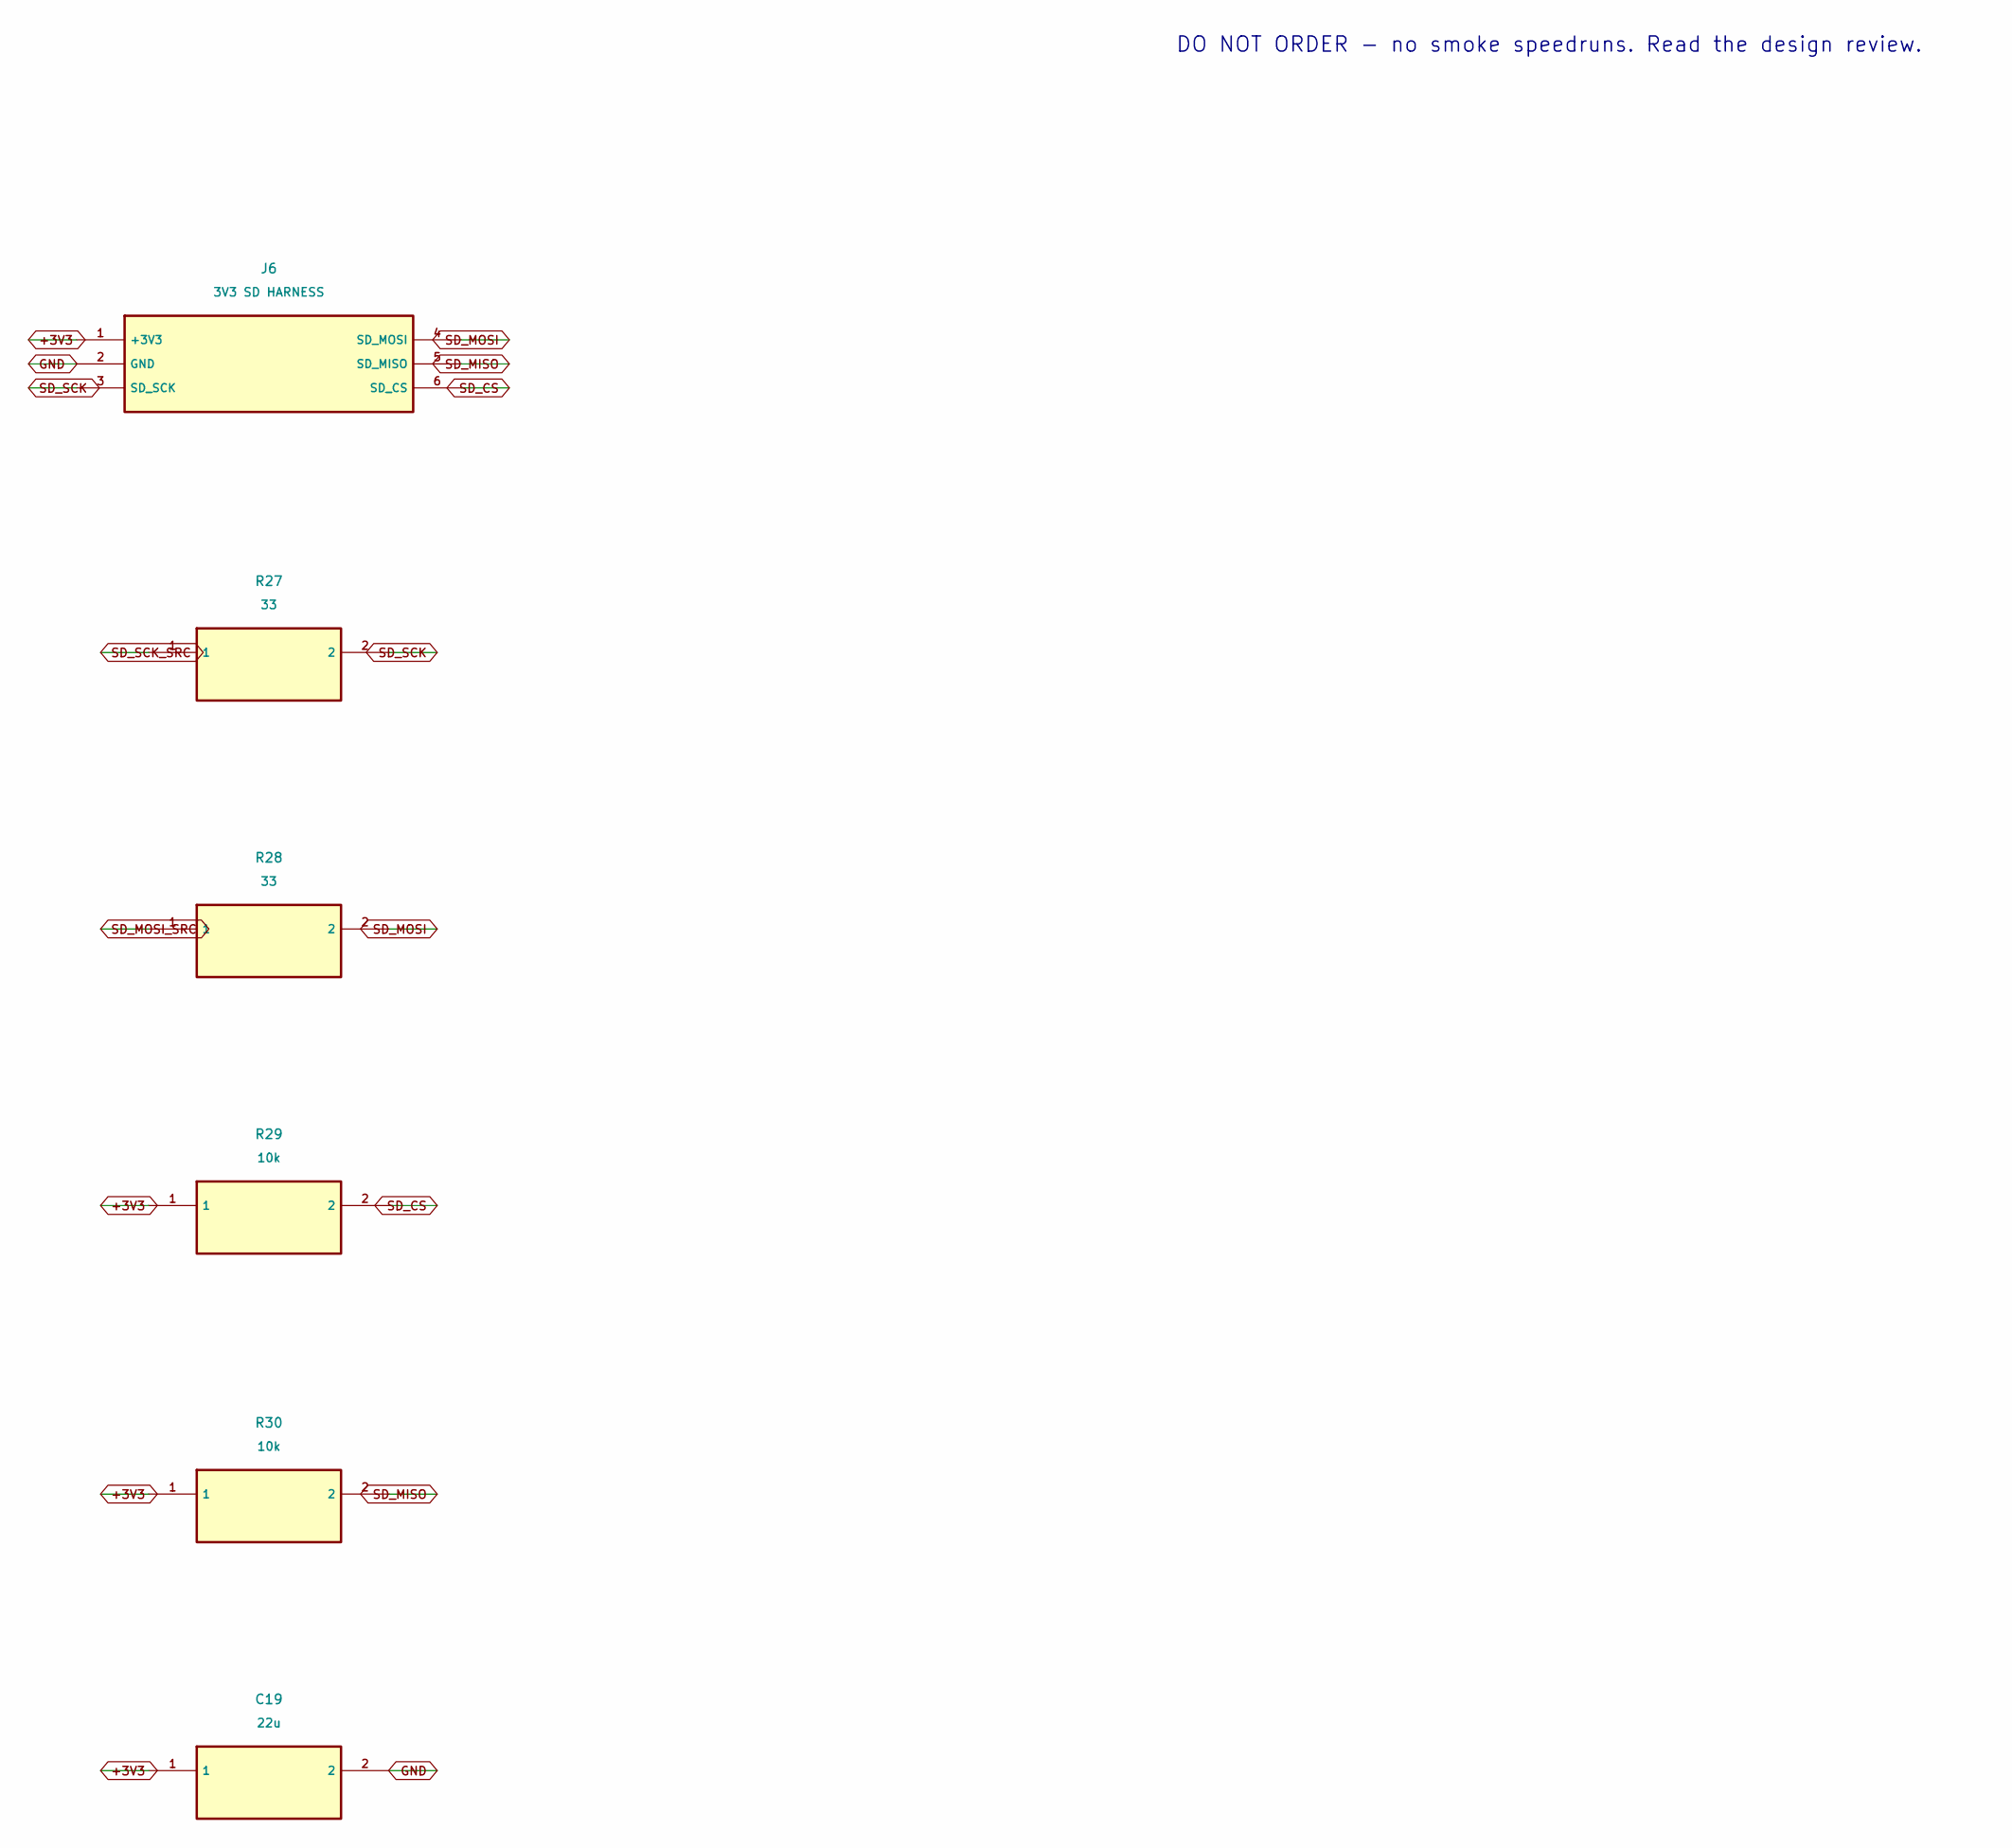
[picture p28: schematic 07_storage.kicad_sch, NEXUS PEAR REV A - 07_storage]

Parts:
C19: 22u; C_1206_3216Metric; MPN GRM31CR61A226KE19L
J6: 3V3 SD HARNESS; PinHeader_1x06_P2.54mm_Vertical; MPN TSW-006-07-G-S
R27, R28: 33; R_0805_2012Metric; MPN RC0805FR-0733RL
R29, R30: 10k; R_0805_2012Metric; MPN RC0805FR-0710KL

Connections:
+3V3: C19.1, J6.1 (+3V3), R29.1, R30.1; also elsewhere on the board
GND: C19.2, J6.2 (GND); also elsewhere on the board
SD_CS: J6.6 (SD_CS), R29.2; also elsewhere on the board
SD_MISO: J6.5 (SD_MISO), R30.2; also elsewhere on the board
SD_MOSI: J6.4 (SD_MOSI), R28.2
SD_MOSI_SRC: R28.1; also elsewhere on the board
SD_SCK: J6.3 (SD_SCK), R27.2; also elsewhere on the board
SD_SCK_SRC: R27.1; also elsewhere on the board

Notes on the sheet:
DO NOT ORDER - no smoke speedruns. Read the design review.
