aminewe898/nexus-pear-reva/hardware/kicad/nexus-pear-reva/nexus-pear-reva.kicad_pcb

## KiCad design hardware/kicad/nexus-pear-reva/nexus-pear-reva.kicad_pcb (continued)

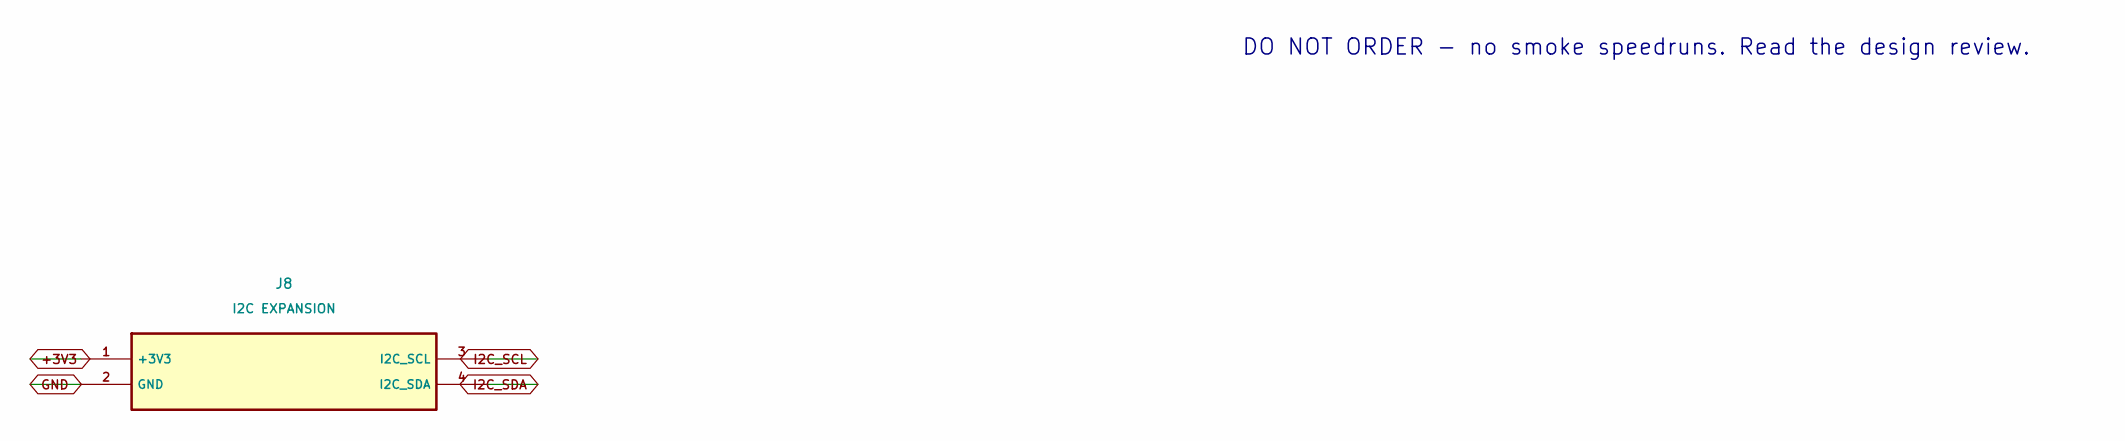
[picture p29: schematic 09_expansion.kicad_sch, NEXUS PEAR REV A - 09_expansion]

Parts:
J8: I2C EXPANSION; PinHeader_1x04_P2.54mm_Vertical; MPN TSW-004-07-G-S

Connections:
+3V3: J8.1 (+3V3); also elsewhere on the board
GND: J8.2 (GND); also elsewhere on the board
I2C_SCL: J8.3 (I2C_SCL); also elsewhere on the board
I2C_SDA: J8.4 (I2C_SDA); also elsewhere on the board

Notes on the sheet:
DO NOT ORDER - no smoke speedruns. Read the design review.

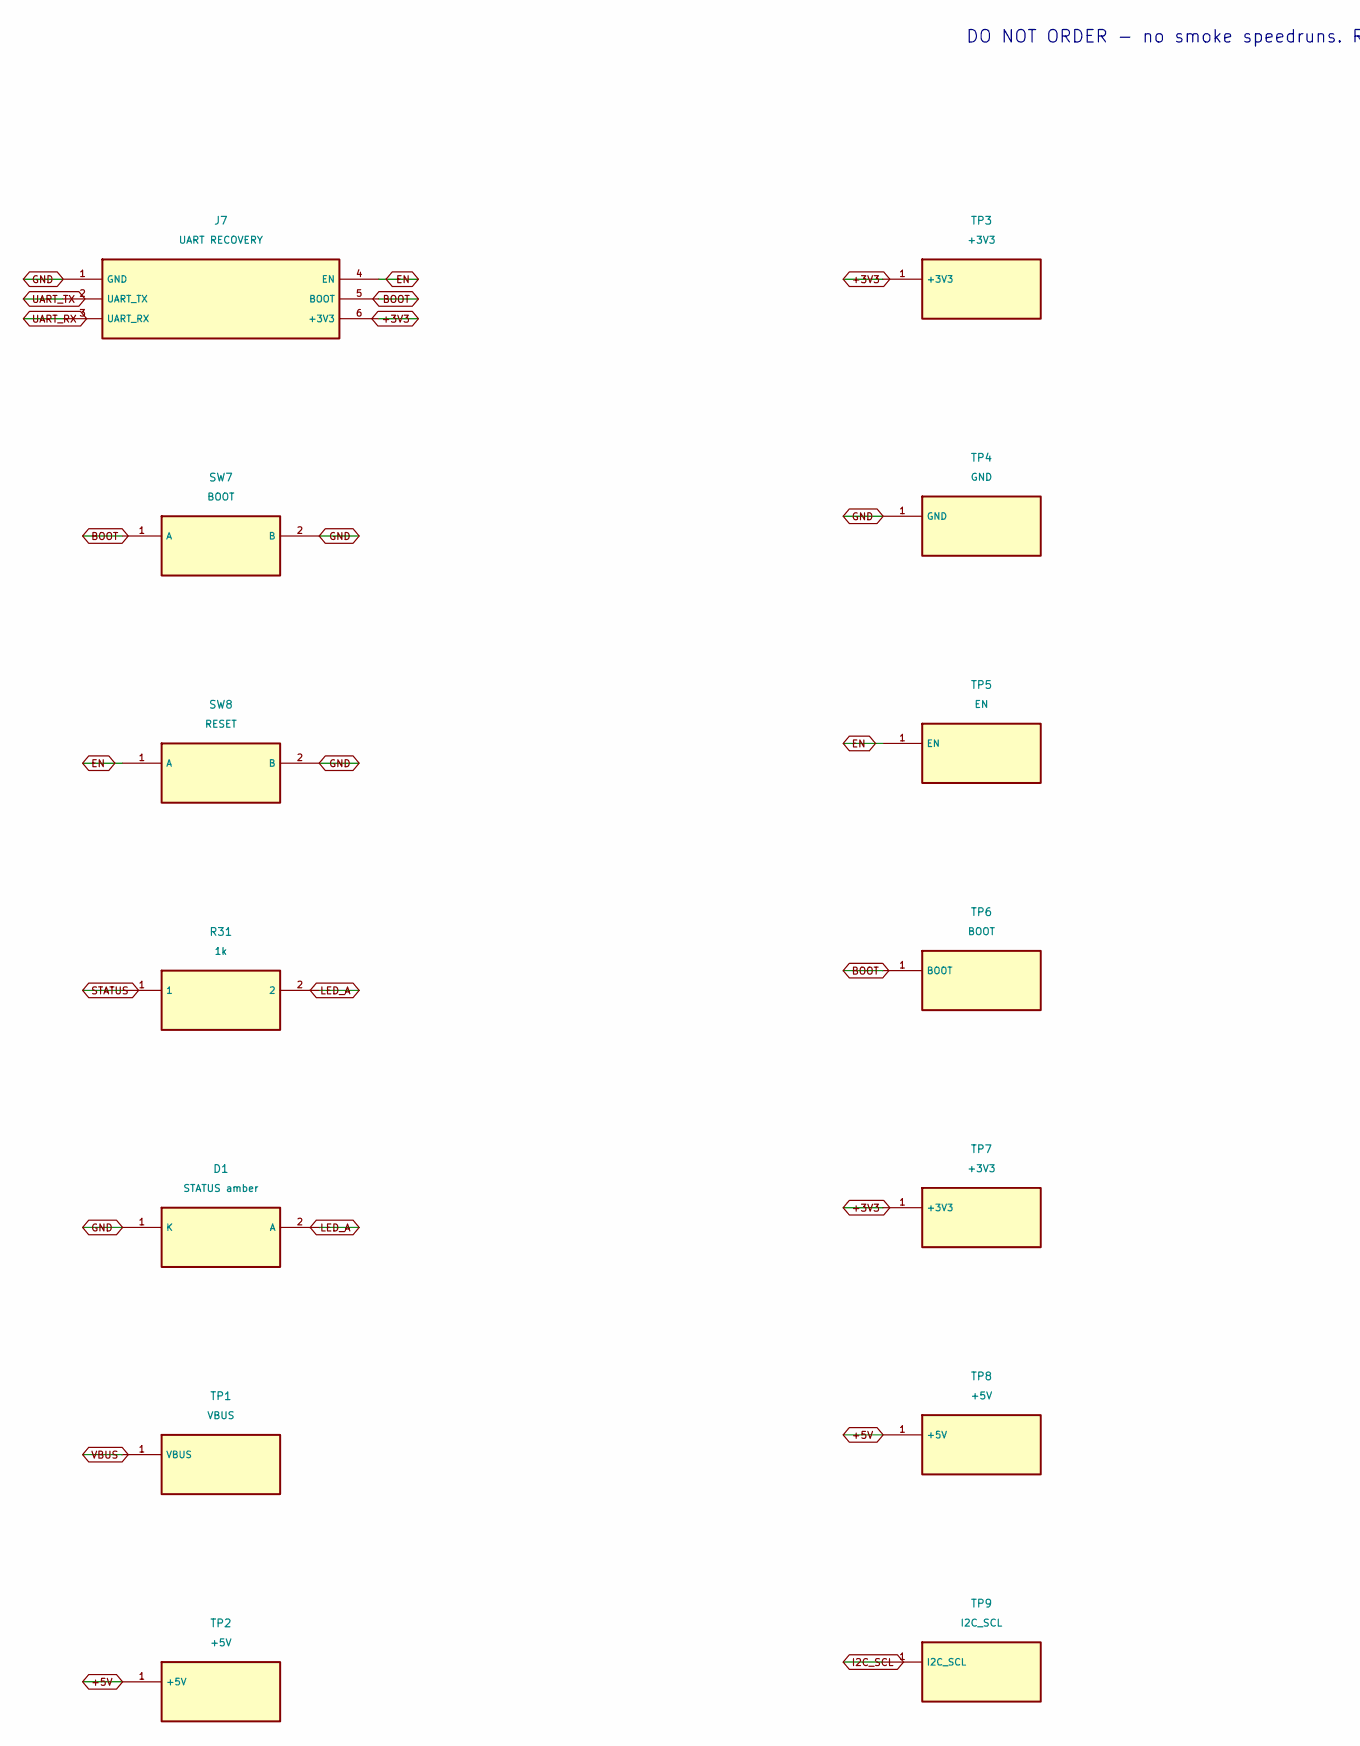
[picture p30: schematic 10_debug.kicad_sch, NEXUS PEAR REV A - 10_debug, part in row 1, column 1]

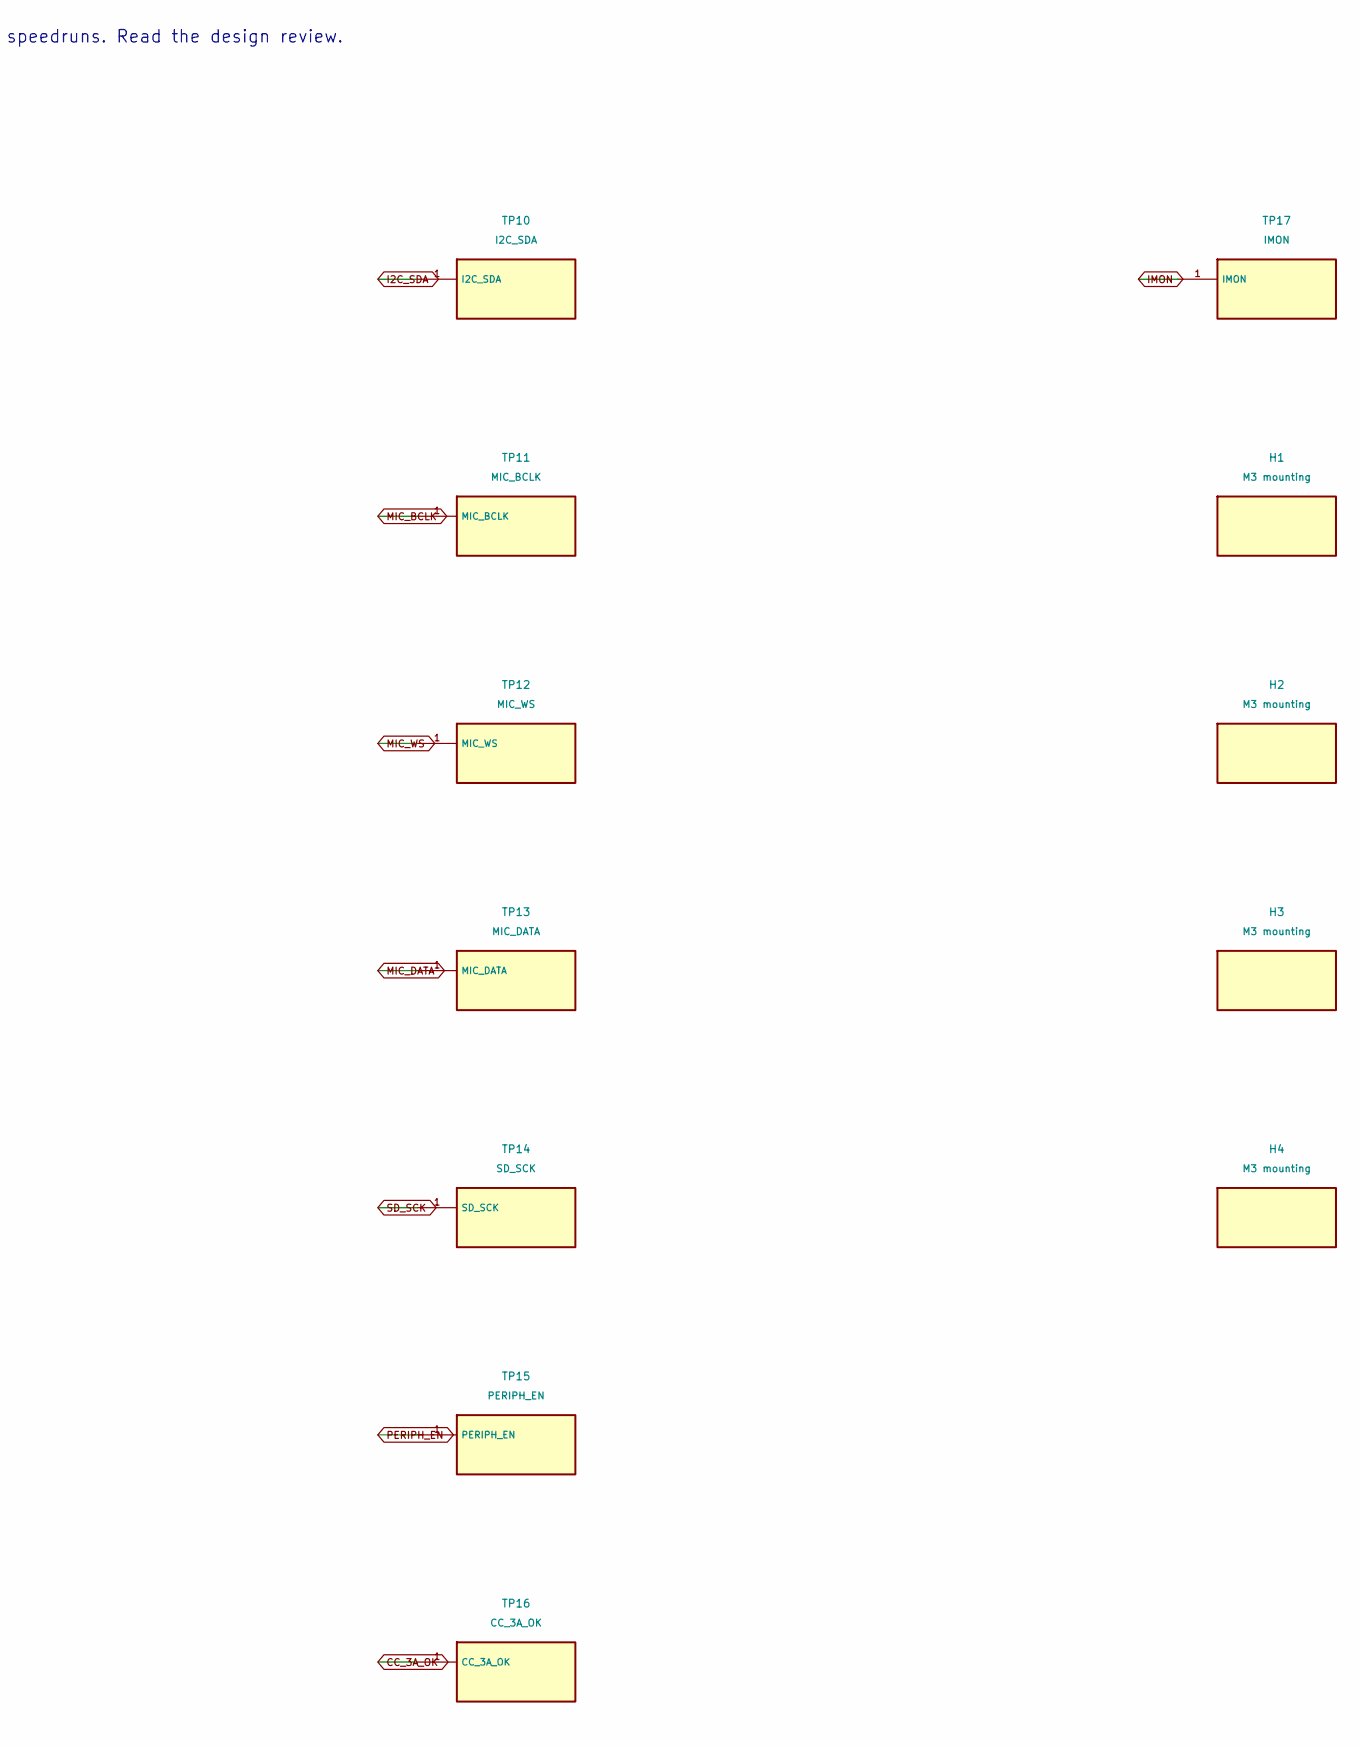
[picture p31: schematic 10_debug.kicad_sch, NEXUS PEAR REV A - 10_debug, part in row 1, column 2]

Parts:
D1: STATUS amber; LED_0805_2012Metric; MPN LTST-C170KFKT
H1, H2, H3, H4: M3 mounting; MountingHole_3.2mm_M3; MPN NPTH 3.2mm
J7: UART RECOVERY; PinHeader_1x06_P2.54mm_Vertical; MPN TSW-006-07-G-S
R31: 1k; R_0805_2012Metric; MPN RC0805FR-071KL
SW7: BOOT; SW_PUSH_6mm; MPN B3F-1000
SW8: RESET; SW_PUSH_6mm; MPN B3F-1000
TP1: VBUS; TestPoint_Pad_D2.0mm; MPN PCB TEST PAD
TP2, TP8: +5V; TestPoint_Pad_D2.0mm; MPN PCB TEST PAD
TP3, TP7: +3V3; TestPoint_Pad_D2.0mm; MPN PCB TEST PAD
TP4: GND; TestPoint_Pad_D2.0mm; MPN PCB TEST PAD
TP5: EN; TestPoint_Pad_D2.0mm; MPN PCB TEST PAD
TP6: BOOT; TestPoint_Pad_D2.0mm; MPN PCB TEST PAD
TP9: I2C_SCL; TestPoint_Pad_D2.0mm; MPN PCB TEST PAD
TP10: I2C_SDA; TestPoint_Pad_D2.0mm; MPN PCB TEST PAD
TP11: MIC_BCLK; TestPoint_Pad_D2.0mm; MPN PCB TEST PAD
TP12: MIC_WS; TestPoint_Pad_D2.0mm; MPN PCB TEST PAD
TP13: MIC_DATA; TestPoint_Pad_D2.0mm; MPN PCB TEST PAD
TP14: SD_SCK; TestPoint_Pad_D2.0mm; MPN PCB TEST PAD
TP15: PERIPH_EN; TestPoint_Pad_D2.0mm; MPN PCB TEST PAD
TP16: CC_3A_OK; TestPoint_Pad_D2.0mm; MPN PCB TEST PAD
TP17: IMON; TestPoint_Pad_D2.0mm; MPN PCB TEST PAD

Connections:
+3V3: J7.6 (+3V3), TP3.1, TP7.1; also elsewhere on the board
+5V: TP2.1, TP8.1; also elsewhere on the board
BOOT: J7.5 (BOOT), SW7.1 (A), TP6.1; also elsewhere on the board
CC_3A_OK: TP16.1; also elsewhere on the board
EN: J7.4 (EN), SW8.1 (A), TP5.1; also elsewhere on the board
GND: D1.1 (K), J7.1 (GND), SW7.2 (B), SW8.2 (B), TP4.1; also elsewhere on the board
I2C_SCL: TP9.1; also elsewhere on the board
I2C_SDA: TP10.1; also elsewhere on the board
IMON: TP17.1; also elsewhere on the board
LED_A: D1.2 (A), R31.2
MIC_BCLK: TP11.1; also elsewhere on the board
MIC_DATA: TP13.1; also elsewhere on the board
MIC_WS: TP12.1; also elsewhere on the board
PERIPH_EN: TP15.1; also elsewhere on the board
SD_SCK: TP14.1; also elsewhere on the board
STATUS: R31.1; also elsewhere on the board
UART_RX: J7.3 (UART_RX); also elsewhere on the board
UART_TX: J7.2 (UART_TX); also elsewhere on the board
VBUS: TP1.1; also elsewhere on the board

Notes on the sheet:
DO NOT ORDER - no smoke speedruns. Read the design review.

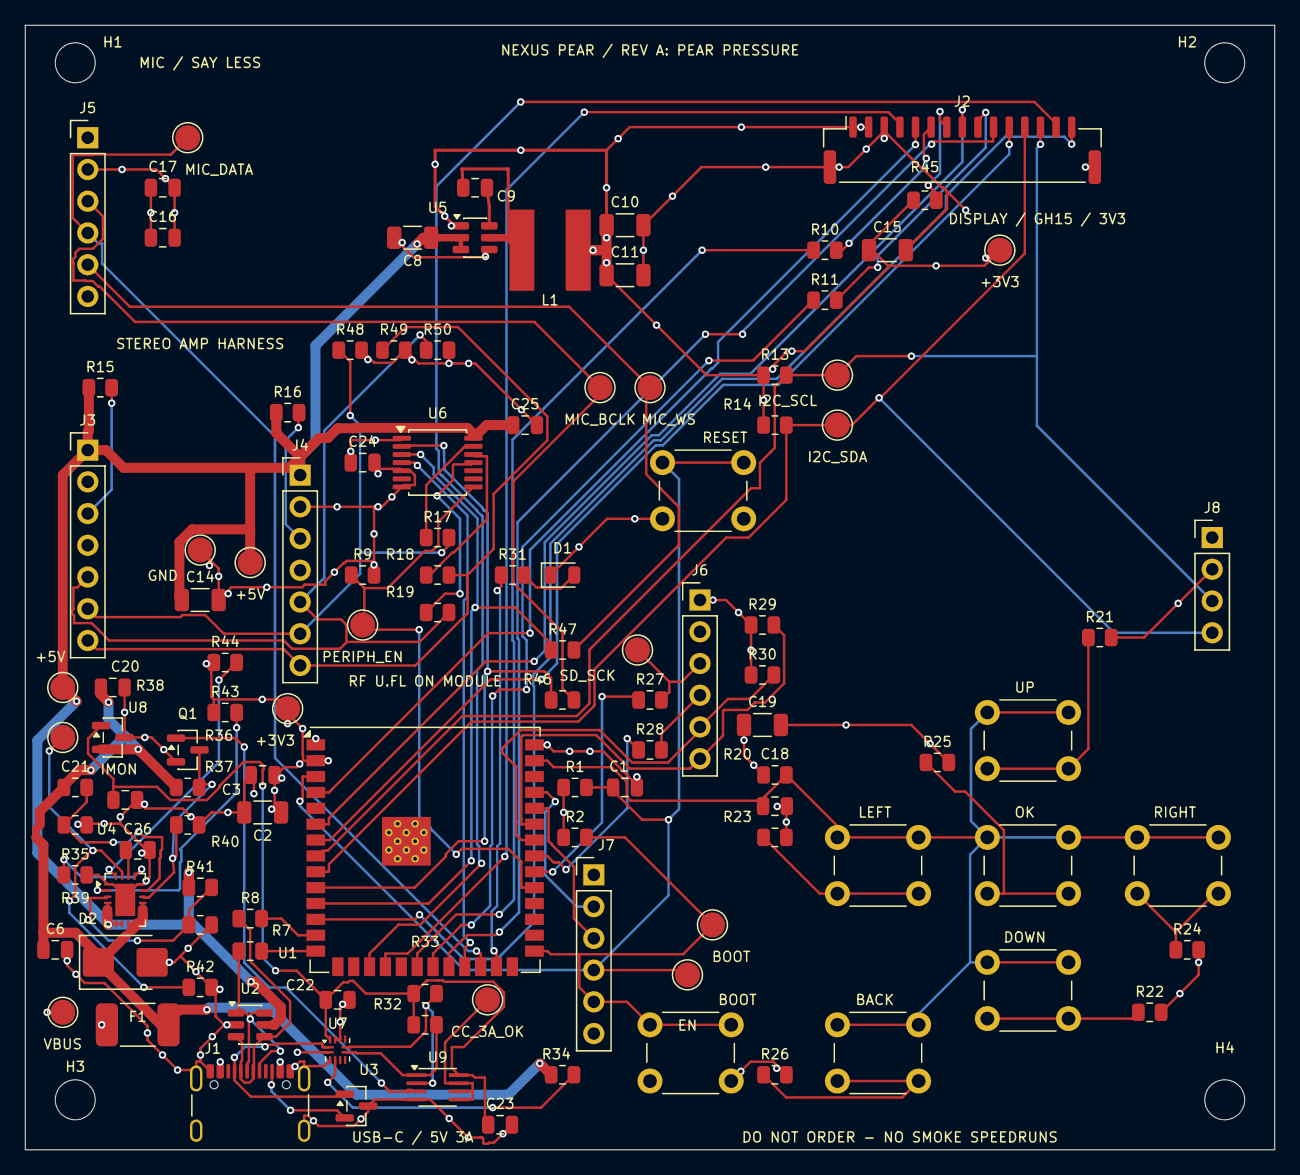
[picture p32: board nexus-pear-reva.kicad_pcb from above]

Board: 4 copper layers, 100.0 x 90.0 mm, 117 parts (0 on the bottom side), 75 nets.
