aminewe898/nexus-pear-reva/engineering-tools/power_router_script.py

from pathlib import Path
s=Path('work/raw_fanout.py').read_text();s=s.replace("for t in list(b.GetTracks()):\n if t.GetNetname()=='VBUS':b.RemoveNative(t)","for t in list(b.GetTracks()):\n if t.GetNetname()=='VBUS' or (t.GetNetname()=='CC2' and not isinstance(t,p.PCB_VIA) and t.GetLayer()==p.F_Cu and 49.7<=p.ToMM(t.GetStart().x)<=54.1 and 112.2<=p.ToMM(t.GetStart().y)<=113.75):b.RemoveNative(t)")
s=s.replace("p.SaveBoard(str(path),b)","\nfrom heapq import heappush,heappop\nviaobs=[pt(t.GetPosition()) for t in b.GetTracks() if isinstance(t,p.PCB_VIA) and t.GetNetname()!='VBUS']\nrectobs=[]\nfor a in pads:\n if a.GetAttribute()==p.PAD_ATTRIB_SMD or a.GetNetCode()==net:continue\n z=a.GetBoundingBox();rectobs.append(tuple(p.ToMM(v) for v in [z.GetLeft(),z.GetTop(),z.GetRight(),z.GetBottom()]))\ndef ok(q):\n if not 31<q[0]<60 or not 103<q[1]<119:return False\n if any(math.dist(q,v)<.91 for v in viaobs):return False\n for l,t,r,d in rectobs:\n  if math.hypot(max(l-q[0],0,q[0]-r),max(t-q[1],0,q[1]-d))<.61:return False\n return True\ndef route(a,z):\n start=tuple(round(v*10) for v in a);end=tuple(round(v*10) for v in z);queue=[(0,start)];cost={start:0};prev={}\n while queue:\n  _,q=heappop(queue)\n  if q==end:break\n  for dx,dy in [(1,0),(-1,0),(0,1),(0,-1),(1,1),(-1,1),(1,-1),(-1,-1)]:\n   n=(q[0]+dx,q[1]+dy);pos=(n[0]/10,n[1]/10)\n   if not ok(pos):continue\n   v=cost[q]+math.hypot(dx,dy)\n   if v>=cost.get(n,1e9):continue\n   cost[n]=v;prev[n]=q;heappush(queue,(v+math.dist(n,end),n))\n if end not in cost:raise RuntimeError(('No raw input path',a,z))\n pts=[end]\n while pts[-1]!=start:pts.append(prev[pts[-1]])\n pts=[a]+[(q[0]/10,q[1]/10) for q in reversed(pts)]+[z]\n for x,y in zip(pts,pts[1:]):\n  if math.dist(x,y)<.0001:continue\n  tr=p.PCB_TRACK(b);tr.SetStart(xy(x));tr.SetEnd(xy(y));tr.SetWidth(p.FromMM(.8));tr.SetLayer(p.In2_Cu);tr.SetNetCode(net);b.Add(tr)\n print('Raw power path',a,z,len(pts))\nfor q in raw[1:]:route(raw[0],q)\np.SaveBoard(str(path),b)")
Path('work/raw_power_route.py').write_text(s)
