aminewe898/nexus-pear-reva/engineering-tools/recovery_continue_prepare.py

from pathlib import Path
p=Path('work/recover_fix_new_clearance.py');s=p.read_text();s=s.replace("if len(matches)!=1:raise RuntimeError((key,len(matches)))", "lengths={'cb0ad747-e365-48ac-927f-2baea1fb922c':4.2944,'5670cb03-1823-4125-84cf-a0b6ad0c5c85':2.0975,'14485d18-4500-431b-b879-f2685f865dbc':.8660,'45f33b8f-93e4-4bf5-a723-238a68a16295':.1437,'19f58cb7-a8f9-446e-a20e-103acfc1150f':.2435,'88795d20-790b-4cea-93f6-f38948dd765b':.2215,'92cee17a-302c-4006-9e56-e6575db2d44f':.0622,'d2d8634c-88d9-4d72-9aec-9e04accd9e89':.0312}\n matches=sorted(matches,key=lambda t:abs(p.ToMM(t.GetLength())-lengths[key]))\n if not matches:raise RuntimeError(key)")
p.write_text(s)
s=Path('work/recovery_run.py').read_text();s=s[s.index('import subprocess'):];a=s.index("script('build_design_fixed')");z=s.index("drc();script('manufacturer_fixes')");s=s[:a]+"script('fix_new_clearance');drc();script('vbus_fix');script('raw_power_route');drc();script('ground_finish');drc();script('cc2_route');drc()\nPath('work/reviewed-routed-backup.kicad_pcb').write_bytes(Path(pro+'nexus-pear-reva.kicad_pcb').read_bytes())\nscript('finish_new_layout');drc()\n";Path('work/recovery_continue.py').write_text(s)
